BudimanZahri/mini_cnc_miling_engraver/Poster/Poster.PNG

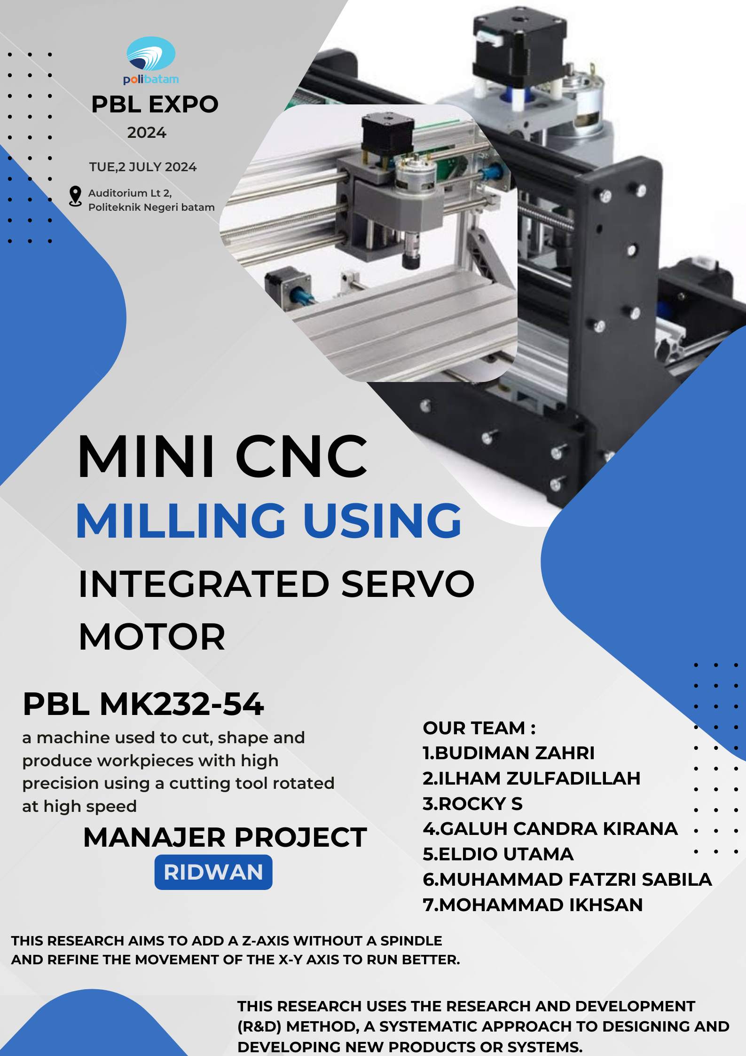
Poster/Poster.PNG
