BudimanZahri/mini_cnc_miling_engraver/Image Documentation/WhatsApp Image 2024-03-01 at 21.08.24.jpeg

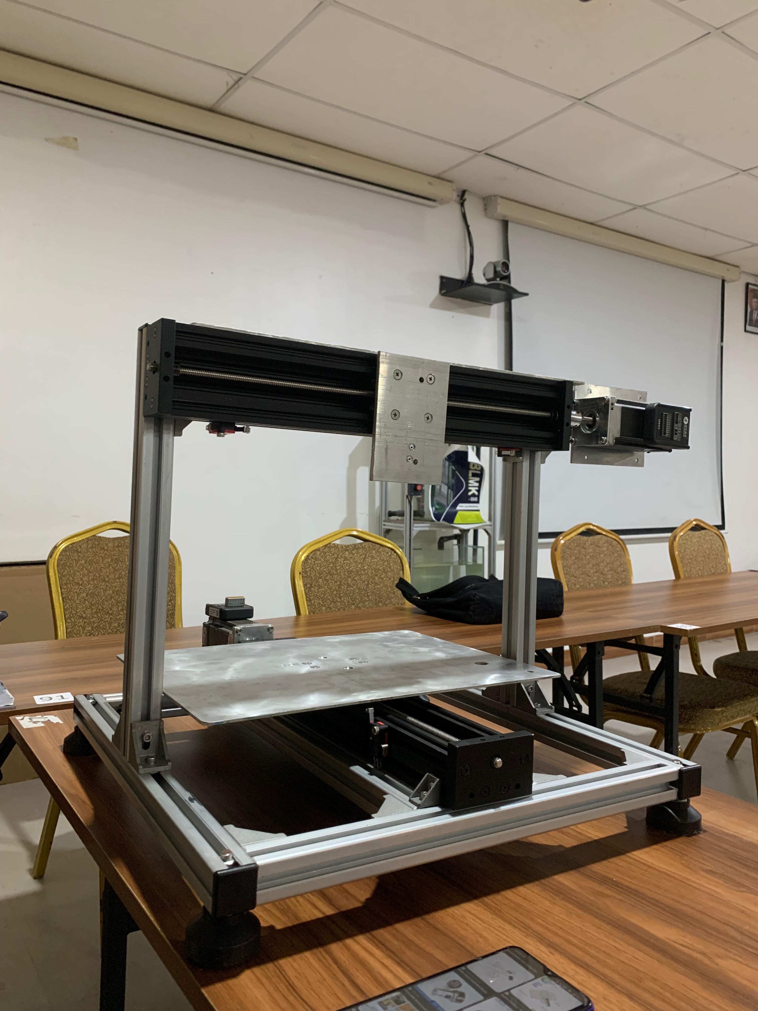
Image Documentation/WhatsApp Image 2024-03-01 at 21.08.24.jpeg
