BudimanZahri/mini_cnc_miling_engraver/Image Documentation/WhatsApp Image 2024-03-02 at 20.33.16.jpeg

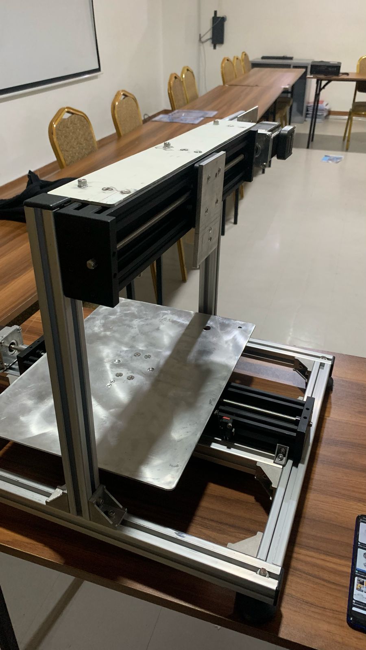
Image Documentation/WhatsApp Image 2024-03-02 at 20.33.16.jpeg
