BudimanZahri/mini_cnc_miling_engraver/Image Documentation/WhatsApp Image 2024-07-15 at 20.14.46 (1).jpeg

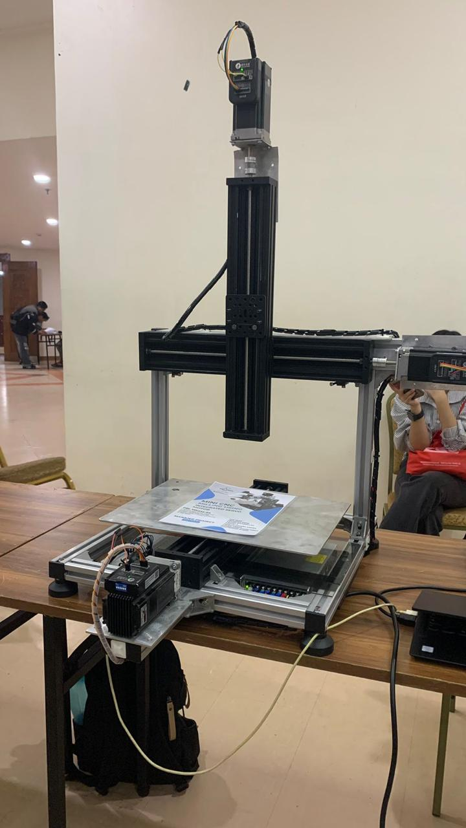
Image Documentation/WhatsApp Image 2024-07-15 at 20.14.46 (1).jpeg
