BudimanZahri/mini_cnc_miling_engraver/Mechanical/3D Design/images.png

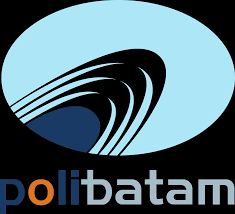
Mechanical/3D Design/images.png
