BudimanZahri/mini_cnc_miling_engraver/Program Interface/MINI_CNC_MILING/src/img/Arrow Down Axis X.png

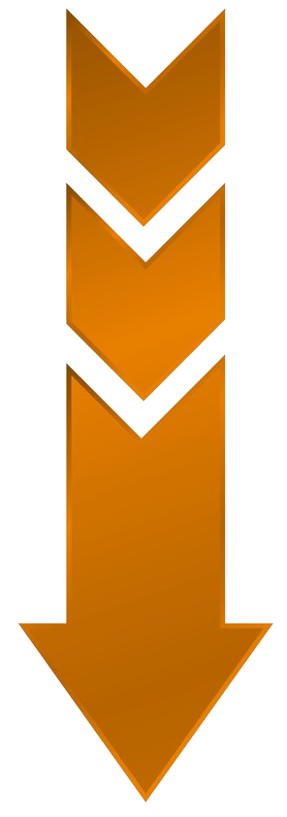
Program Interface/MINI_CNC_MILING/src/img/Arrow Down Axis X.png
