BudimanZahri/mini_cnc_miling_engraver/Program Interface/MINI_CNC_MILING/src/img/Arrow Left Axis Y.png

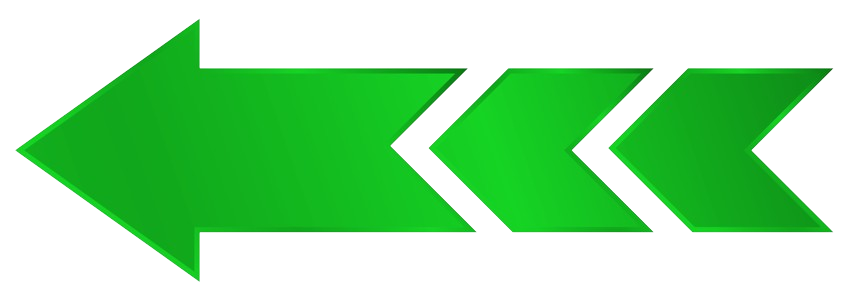
Program Interface/MINI_CNC_MILING/src/img/Arrow Left Axis Y.png
