BudimanZahri/mini_cnc_miling_engraver/Program Interface/MINI_CNC_MILING/src/img/Arrow Up Axis X.png

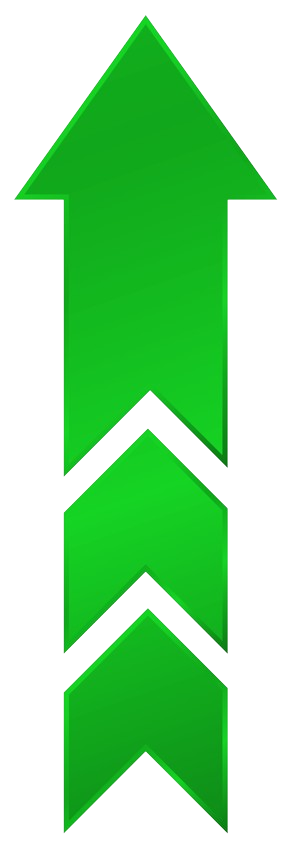
Program Interface/MINI_CNC_MILING/src/img/Arrow Up Axis X.png
