BudimanZahri/mini_cnc_miling_engraver/Program Interface/MINI_CNC_MILING/src/img/arrow_down.png

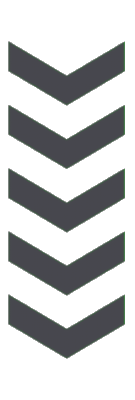
Program Interface/MINI_CNC_MILING/src/img/arrow_down.png
