BudimanZahri/mini_cnc_miling_engraver/Program Interface/MINI_CNC_MILING/src/img/arrow_up.png

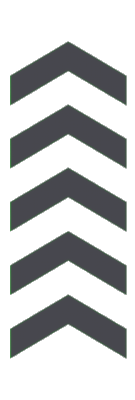
Program Interface/MINI_CNC_MILING/src/img/arrow_up.png
