BudimanZahri/mini_cnc_miling_engraver/Program Interface/MINI_CNC_MILING/src/img/cylinder_up.png

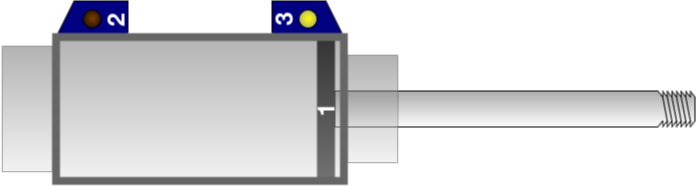
Program Interface/MINI_CNC_MILING/src/img/cylinder_up.png
