BudimanZahri/mini_cnc_miling_engraver/Program Interface/MINI_CNC_MILING/src/img/emergency_button.png

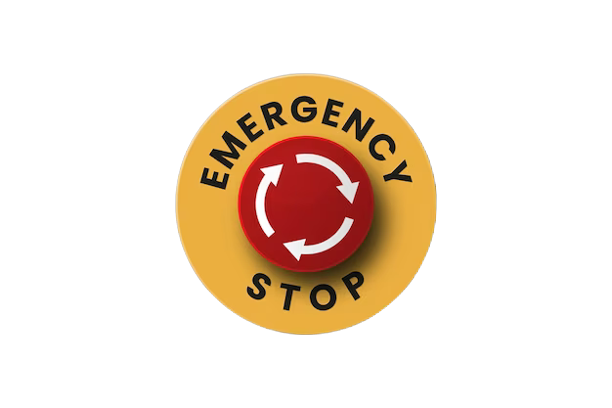
Program Interface/MINI_CNC_MILING/src/img/emergency_button.png
