BudimanZahri/mini_cnc_miling_engraver/Program Interface/MINI_CNC_MILING/src/img/green_light_signal.png

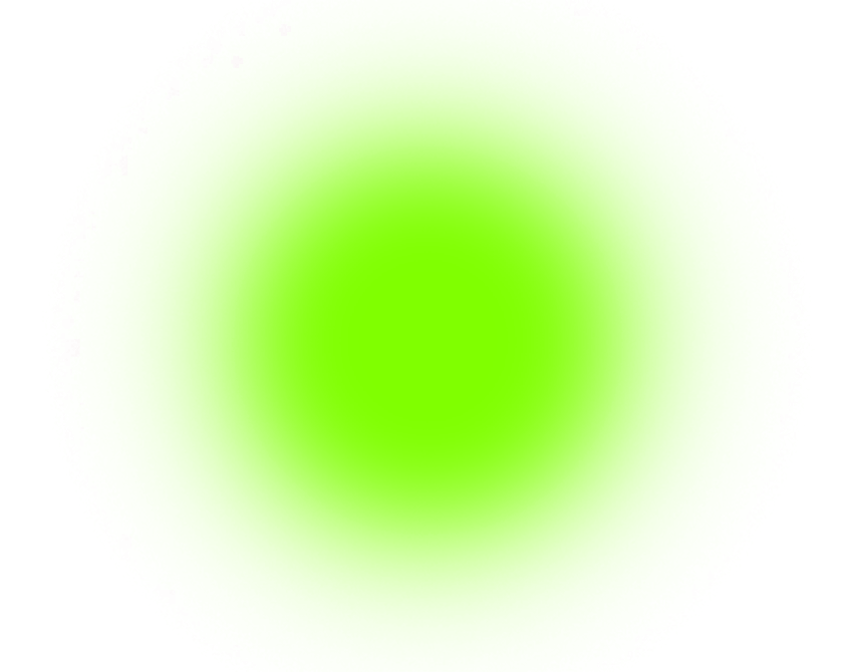
Program Interface/MINI_CNC_MILING/src/img/green_light_signal.png
