BudimanZahri/mini_cnc_miling_engraver/Program Interface/MINI_CNC_MILING/src/img/greenled_light_on.png

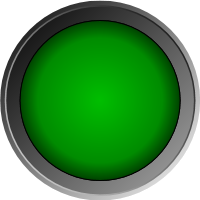
Program Interface/MINI_CNC_MILING/src/img/greenled_light_on.png
