BudimanZahri/mini_cnc_miling_engraver/Program Interface/MINI_CNC_MILING/src/img/pb_stop.png

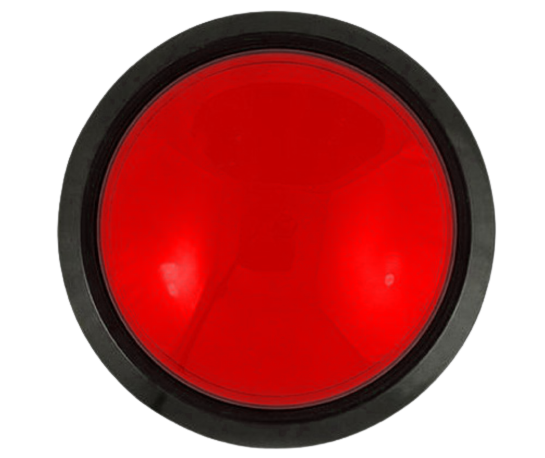
Program Interface/MINI_CNC_MILING/src/img/pb_stop.png
