BudimanZahri/mini_cnc_miling_engraver/Program Interface/MINI_CNC_MILING/src/img/pipe_conveyor.png

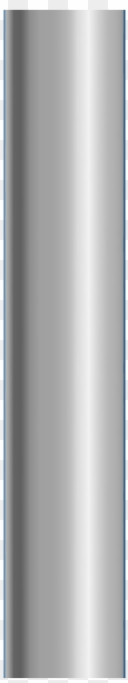
Program Interface/MINI_CNC_MILING/src/img/pipe_conveyor.png
