BudimanZahri/mini_cnc_miling_engraver/Gantt Chart/PBLMK232-54_Gant Chart.xlsx

Sheet: Gantt Chart
PBL Code | PBLMK232-54
PROJECT TITLE | Mini CNC Milling Using Integrated Servo Motor
No | Description Task |  | PIC | Status | Achievement in percentage | Team | Plan/Actual | February | March |  |  |  |  |  |  |  |  |  |  |  |  |  |  |  |  |  |  | April |  |  |  |  |  |  | May
 |  |  |  |  |  |  |  | Date | Dates |  |  |  |  |  |  |  |  |  |  |  |  |  |  |  |  |  |  | Dates |  |  |  |  |  |  | Dates
 |  |  |  |  |  |  |  | 29 | 1 | 4 | 5 | 6 | 7 | 8 | 11 | 13 | 14 | 15 | 18 | 19 | 20 | 21 | 22 | 25 | 26 | 27 | 28 | 22 | 23 | 24 | 25 | 26 | 29 | 30 | 1 | 2 | 3 | 6 | 7 | 8 | 9 | 10 | 13 | 14 | 15 | 16 | 17 | 20 | 21 | 22 | 23 | 24 | 27 | 28 | 29 | 30 | 31
1. | Planning and Team Discussion |  | Budiman Zahri
 | 1.1 | First discussion online with Project Manager |  | Done | 100% | All | PLAN
 |  |  |  |  |  |  | ACTUAL
 | 1.2 | Member registration on PBL ready website |  | Done | 100% | All | PLAN
 |  |  |  |  |  |  | ACTUAL
 | 1.3 | Create timeline |  | Done | 100% | Galuh | PLAN
 |  |  |  |  |  |  | ACTUAL
 | 1.4 | Offline discussion with project manager |  | Done | 100% | All | PLAN
 |  |  |  |  |  |  | ACTUAL
 | 1.5 | Identify team members and assign roles. |  | Done | 100% | Budi | PLAN
 |  |  |  |  |  |  | ACTUAL
 | 1.6 | Discussion about the list of BHP that will be submitted |  | Done | 100% | All | PLAN
 |  |  |  |  |  |  | ACTUAL
 | 1.7 | Ensure the targets that will result from this PBL |  | Done | 100% | Budi | PLAN
 |  |  |  |  |  |  | ACTUAL
 | 1.8 | Search information about CNC Milling that is worked on in the project. |  | Done | 100% | Galuh | PLAN
 |  |  |  |  |  |  | ACTUAL
2. | Planner and HR |  | Galuh Candra Kirana
 | 2.1 | Create the RPP (Rencana Pelaksanaan Proyek) |  | Done | 100% | Galuh | PLAN
 |  |  |  |  |  |  | ACTUAL
 | 2.2 | Create a BHP list |  | Done | 100% | Galuh | PLAN
 |  |  |  |  |  |  | ACTUAL
 | 2.3 | Ensure smooth submission of BHP from ordering until the goods are ready for use |  | Done | 100% | Galuh | PLAN
 |  |  |  |  |  |  | ACTUAL
 | 2.4 | Create attendance to ensure team members are working according to their tasks. |  | Done | 100% | Galuh | PLAN
 |  |  |  |  |  |  | ACTUAL
3. | Mechanical Design |  | Eldio Utama
 | 3.1 | Download software Soliwork |  | Done | 100 | Eldio | PLAN
 |  |  |  |  |  |  | ACTUAL
 | 3.2 | Measuring the parts of the tool to be designed |  | Done | 100 | Eldio | PLAN
 |  |  |  |  |  |  | ACTUAL
 | 3.3 | Create a design |  | Done | 100 | Eldio | PLAN
 |  |  |  |  |  |  | ACTUAL
4. | Machanical |  | Mohammad Ihsan
 | 4.1 | Checking Raw Material and Request Material Approval |  | Done | 100% | Ihsan | PLAN
 |  |  |  |  |  |  | ACTUAL
 | 4.2 | Assembly Z Axis |  | Done | 100% | Ihsan | PLAN
 |  |  |  |  |  |  | ACTUAL
 | 4.3 | Assembly Spindell |  | Done | 100% | Ihsan | PLAN
 |  |  |  |  |  |  | ACTUAL
 | 4.4 | Assembly Servo Motor |  | Done | 100% | Ihsan | PLAN
 |  |  |  |  |  |  | ACTUAL
 | 4.5 | Assembly of other supporting materials |  | Done | 100% | Ihsan | PLAN
 |  |  |  |  |  |  | ACTUAL
5. | Electrical Diagram |  | Ilham Zulfadillah
 | 5.1 | Make electrical diagrams in accordance with electrical wiring |  | Done | 100 | Ilham | PLAN
 |  |  |  |  |  |  | ACTUAL
 | 5.2 | Perform wiring check |  | Done | 100 | Ilham | PLAN
 |  |  |  |  |  |  | ACTUAL
6. | Electrical Wiring |  | Muhammad Fatzri Sabila
 | 6.1 | Checking Raw Material and Request Material Approval |  | Done | 100% | Fatzri | PLAN
 |  |  |  |  |  |  | ACTUAL
 | 6.2 | Install power supply |  | Done | 100% | Fatzri | PLAN
 |  |  |  |  |  |  | ACTUAL
 | 6.3 | Install electrical for X, Y, and Z axis |  | Done | 100% | Fatzri | PLAN
 |  |  |  |  |  |  | ACTUAL
 | 6.4 | Adjust part for moving X, Y, and Z axis |  | Done | 100% | Fatzri | PLAN
 |  |  |  |  |  |  | ACTUAL
 | 6.5 | Trubleshooting electrical |  | Done | 100% | Fatzri | PLAN
 |  |  |  |  |  |  | ACTUAL
 | 6.6 | Testing |  | Done | 100% | Fatzri | PLAN
 |  |  |  |  |  |  | ACTUAL
7. | Program Interface |  | Budiman Zahri
 | 7.1 | study documentation of Servo motor, C#, C++, Accelstepper |  | Done | 100 | Budi | PLAN
 |  |  |  |  |  |  | ACTUAL
 | 7.2 | Create the program interfaces CNC Milling |  | Done | 100 | Budi | PLAN
 |  |  |  |  |  |  | ACTUAL
 | 7.3 | Testing |  | Done | 100 | Budi | PLAN
 |  |  |  |  |  |  | ACTUAL
8. | QA/QC |  | Rocky S
 | 8.1 | Verifying product conformance to specifications |  | Done | 100 | Rocky | PLAN
 |  |  |  |  |  |  | ACTUAL
 | 8.2 | Identify and report quality issues |  | Done | 100 | Rocky | PLAN
 |  |  |  |  |  |  | ACTUAL
 | 8.3 | Provide recommendations for process improvement |  | Done | 100 | Rocky | PLAN
 |  |  |  |  |  |  | ACTUAL
9 | Report PBL |  | Galuh Candra Kirana
 | 9.1 | Create a PBL report |  | Done | 100% | Galuh | PLAN
 |  |  |  |  |  |  | ACTUAL

Sheet: Konfigurasi
STATUS | Information | Nama PIC | Information
To Do |  | Galuh
In Progress |  | Ikhsan
Waiting Approval |  | Budi
Done |  | Rocky
Cancelled |  | Ilham
 |  | Fatzri
 |  | Eldio
 |  | All
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
