BudimanZahri/mini_cnc_miling_engraver/Mechanical/3D Design/PBLMK-041-A/Frame/Frame0001.SLDASM

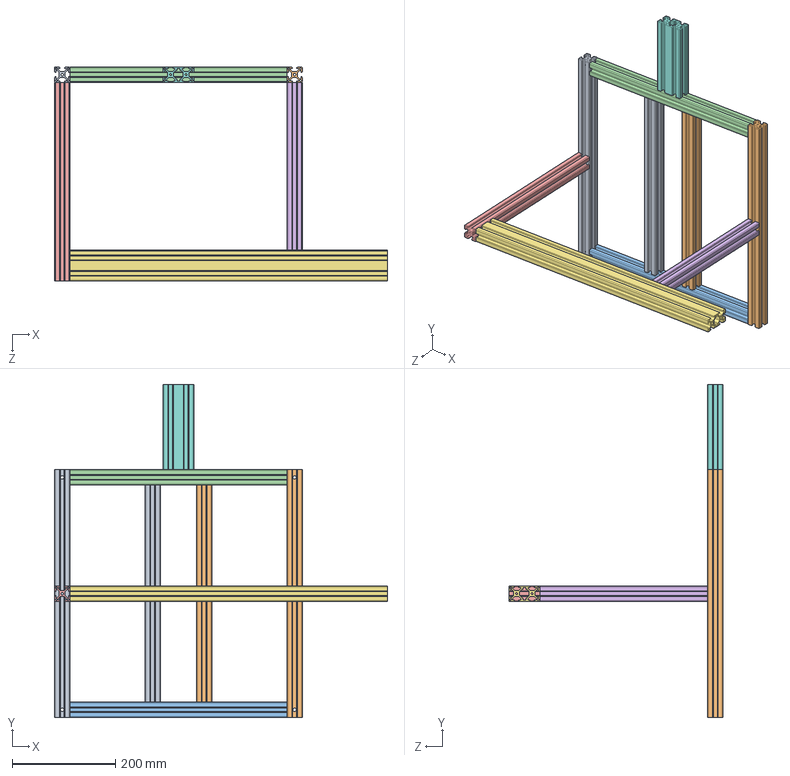
[picture p33: CAD file, 2024-07-05]
Mechanical/3D Design/PBLMK-041-A/Frame/Frame0001.SLDASM
645.0 x 645.0 x 415.0 mm
ALU PROFILE 3030 00000001.ipt
ALU PROFILE 3030 00000002.ipt
ALU PROFILE 3030 00000003.ipt
ALU PROFILE 3030 00000004.ipt
ALU PROFILE 3030 00000006.ipt
ALU PROFILE 3030 00000007.ipt
ALU PROFILE 3060 00000008.ipt
ALU PROFILE 3060 00000009.ipt
Aluminum Profile 30x30 00000010.ipt
Aluminum Profile 30x30 00000011.ipt
