BudimanZahri/mini_cnc_miling_engraver/Mechanical/3D Design/LINEAR ACTUATOR.SLDASM

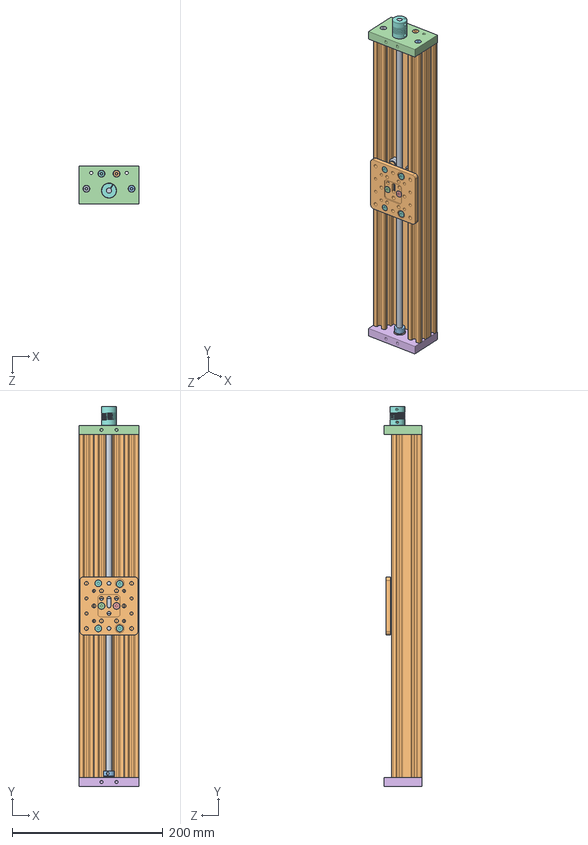
[picture p34: CAD file, 2024-07-05]
Mechanical/3D Design/LINEAR ACTUATOR.SLDASM
80.0 x 505.0 x 50.0 mm
Solid33.ipt
Solid45.ipt
Solid39.ipt
Solid41.ipt
Solid43.ipt
Solid44.ipt
Solid57.ipt
Solid58.ipt x 3
Solid31.ipt
Solid32.ipt
Solid1.ipt x 2
Solid53.ipt
Solid54.ipt
Solid55.ipt
Solid56.ipt
Solid49.ipt x 4
Solid16.ipt x 4
Solid15.ipt x 4
Solid14.ipt x 4
Solid13.ipt x 4
Solid12.ipt x 4
Solid11.ipt x 4
Solid10.ipt x 4
Solid64.ipt
Solid63.ipt
Solid62.ipt
Solid61.ipt
Solid46.ipt
Solid42.ipt
Solid40.ipt
Solid38.ipt
Solid34.ipt
