BudimanZahri/mini_cnc_miling_engraver/Mechanical/3D Design/PBLMK-041-5.SLDPRT

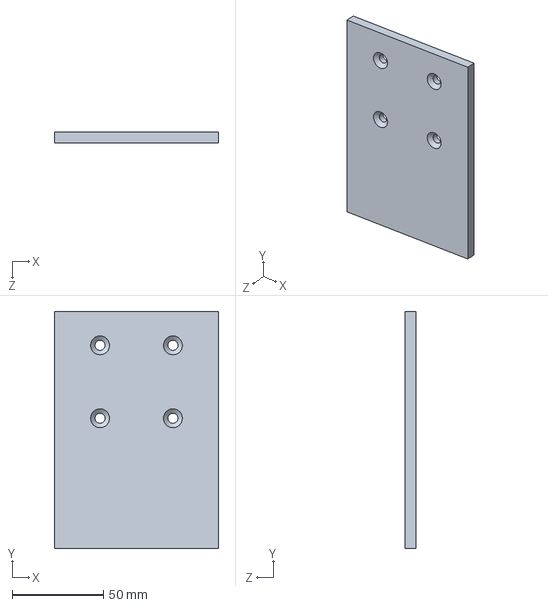
[picture p35: CAD file, 2024-07-05]
Mechanical/3D Design/PBLMK-041-5.SLDPRT
90.0 x 130.0 x 6.00 mm
