BudimanZahri/mini_cnc_miling_engraver/Mechanical/3D Design/PBLMK-041-A/Frame/ALU PROFILE 3060  00000008.SLDPRT

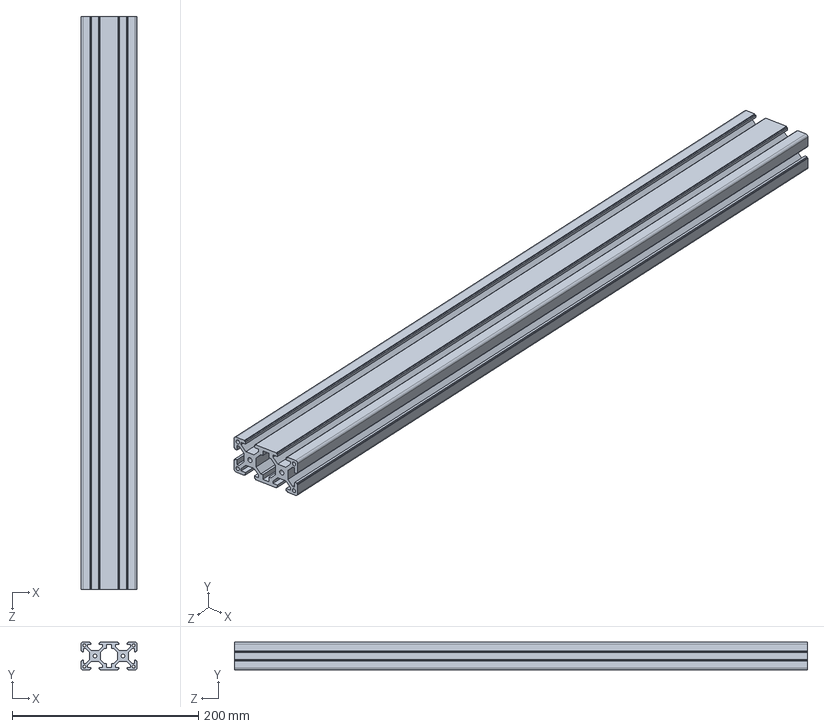
[picture p36: CAD file, 2024-07-05]
Mechanical/3D Design/PBLMK-041-A/Frame/ALU PROFILE 3060 00000008.SLDPRT
60.0 x 30.0 x 615.0 mm
