BudimanZahri/mini_cnc_miling_engraver/Mechanical/3D Design/BASE LINEAR ACTUATOR.SLDPRT

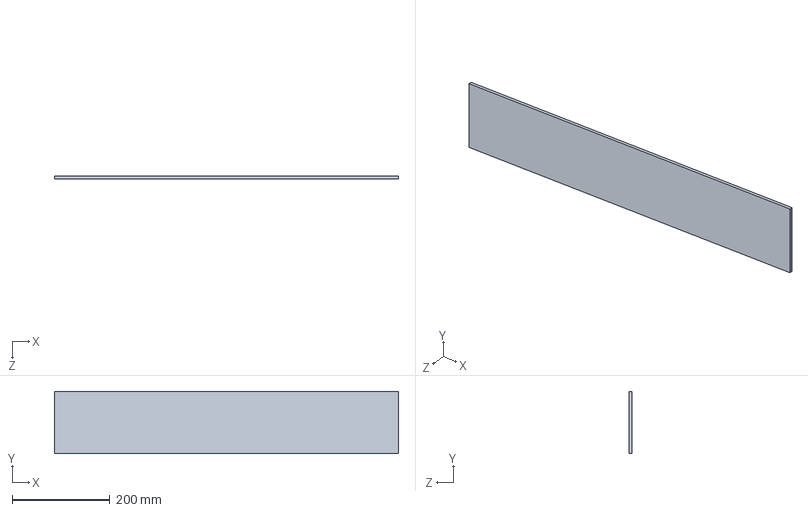
[picture p37: CAD file, 2024-07-05]
Mechanical/3D Design/BASE LINEAR ACTUATOR.SLDPRT
703.0 x 127.0 x 6.00 mm
