BudimanZahri/mini_cnc_miling_engraver/Mechanical/3D Design/END CAP 3060.SLDPRT

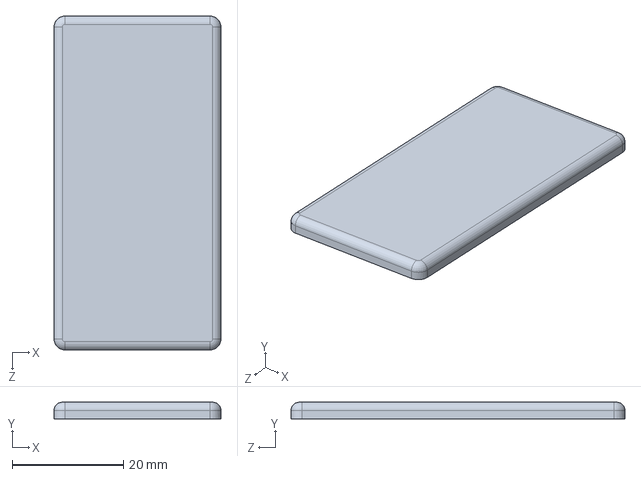
[picture p38: CAD file, 2024-07-05]
Mechanical/3D Design/END CAP 3060.SLDPRT
30.0 x 3.00 x 60.0 mm
