BudimanZahri/mini_cnc_miling_engraver/Mechanical/3D Design/Adjuster Pad.SLDPRT

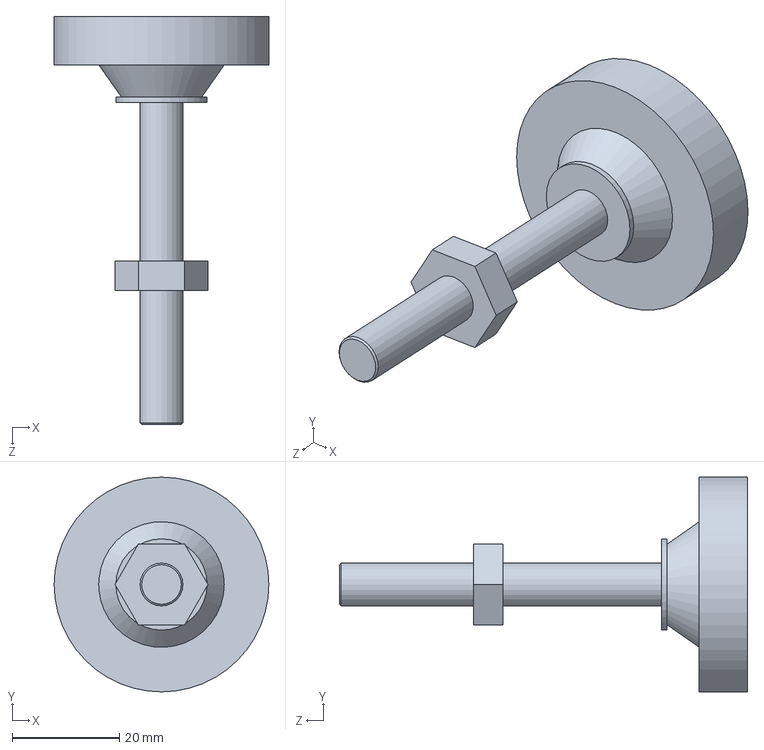
[picture p39: CAD file, 2024-07-05]
Mechanical/3D Design/Adjuster Pad.SLDPRT
40.0 x 40.0 x 76.0 mm
