BudimanZahri/mini_cnc_miling_engraver/Mechanical/3D Design/PBLMK-041-A/Frame/ALU PROFILE 3030  00000005.SLDPRT

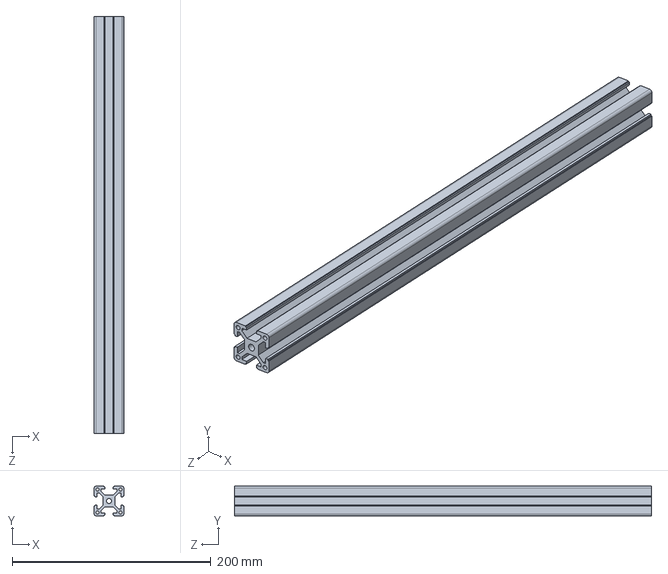
[picture p40: CAD file, 2024-07-05]
Mechanical/3D Design/PBLMK-041-A/Frame/ALU PROFILE 3030 00000005.SLDPRT
30.0 x 30.0 x 420.0 mm
