BudimanZahri/mini_cnc_miling_engraver/Mechanical/3D Design/END CAP 30.SLDPRT

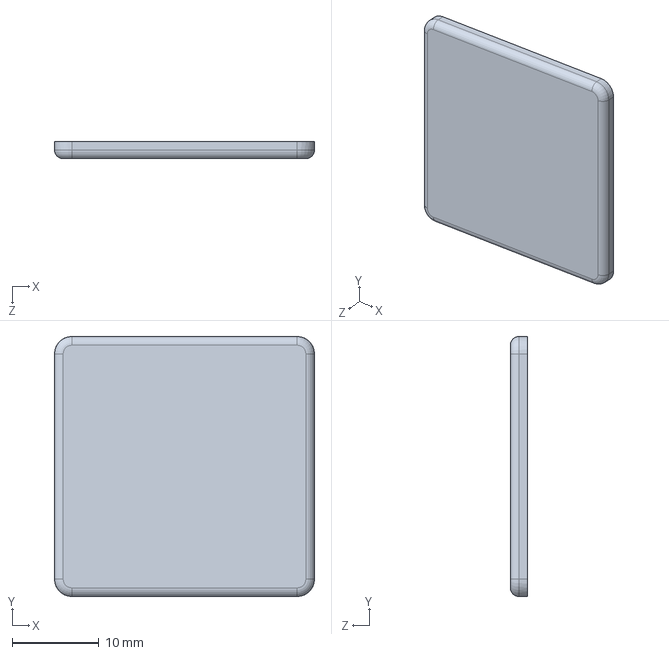
[picture p41: CAD file, 2024-07-05]
Mechanical/3D Design/END CAP 30.SLDPRT
30.0 x 30.0 x 2.00 mm
