BudimanZahri/mini_cnc_miling_engraver/Mechanical/3D Design/PBLMK-041-A/Frame/ALU PROFILE 3030  00000001.SLDPRT

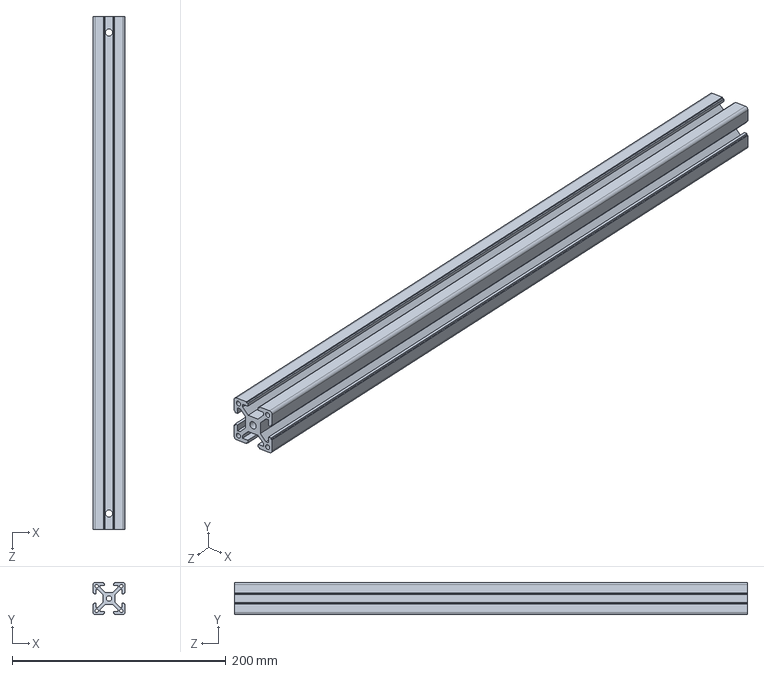
[picture p42: CAD file, 2024-07-05]
Mechanical/3D Design/PBLMK-041-A/Frame/ALU PROFILE 3030 00000001.SLDPRT
30.0 x 30.0 x 480.0 mm
