BudimanZahri/mini_cnc_miling_engraver/Mechanical/3D Design/Gusset 30.SLDPRT

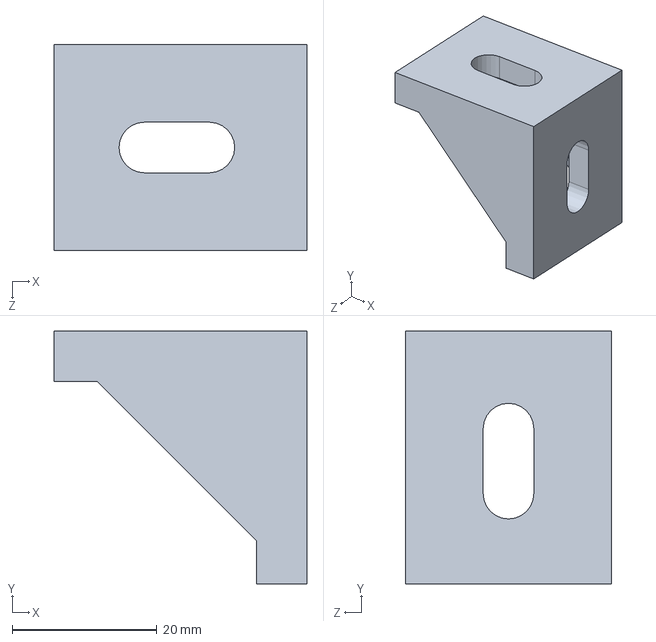
[picture p43: CAD file, 2024-07-05]
Mechanical/3D Design/Gusset 30.SLDPRT
35.0 x 35.0 x 28.5 mm
