BudimanZahri/mini_cnc_miling_engraver/Mechanical/3D Design/PBLMK-041-A/Frame/C-Beam Linear Actuator 500mm.stp.SLDPRT

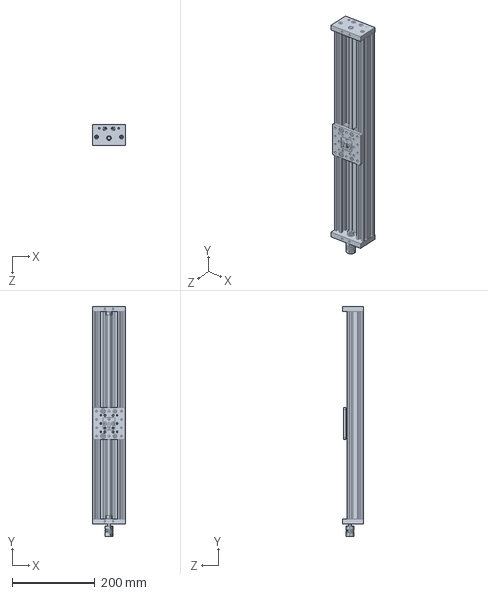
[picture p44: CAD file, 2024-07-05]
Mechanical/3D Design/PBLMK-041-A/Frame/C-Beam Linear Actuator 500mm.stp.SLDPRT
80.0 x 554.4 x 50.0 mm
