BudimanZahri/mini_cnc_miling_engraver/Mechanical/3D Design/PBLMK-041-1.SLDPRT

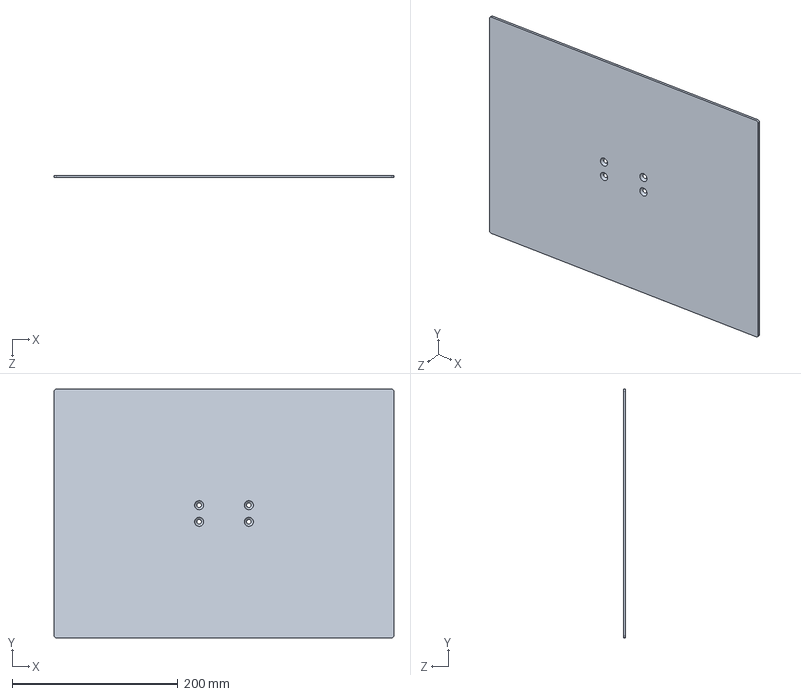
[picture p45: CAD file, 2024-07-05]
Mechanical/3D Design/PBLMK-041-1.SLDPRT
410.0 x 300.0 x 3.00 mm
