BudimanZahri/mini_cnc_miling_engraver/Mechanical/3D Design/PBLMK-041-A/Frame/ALU PROFILE 3030  00000007.SLDPRT

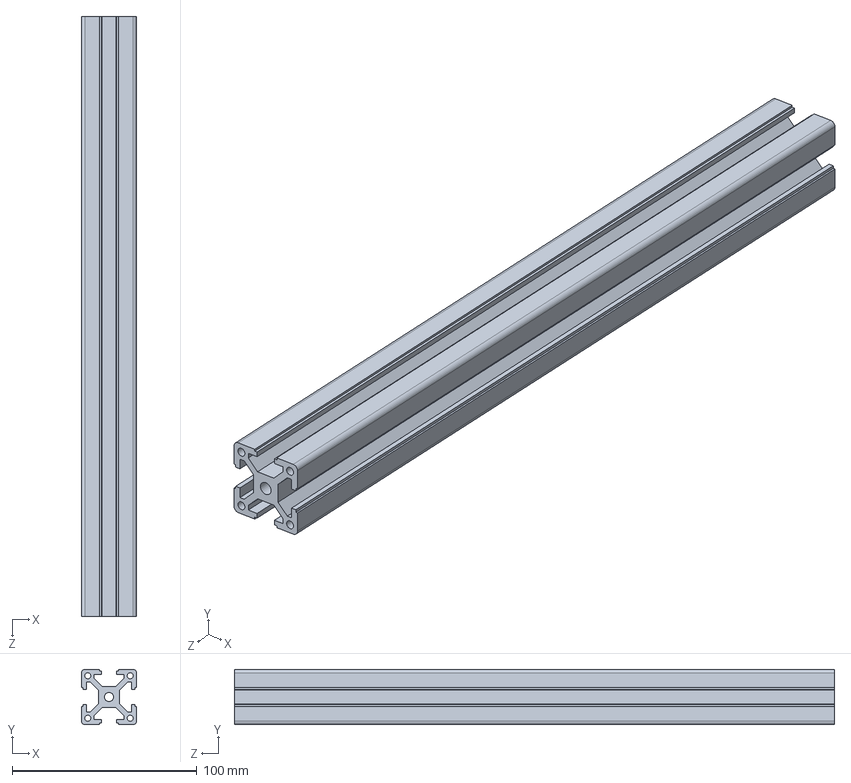
[picture p46: CAD file, 2024-07-05]
Mechanical/3D Design/PBLMK-041-A/Frame/ALU PROFILE 3030 00000007.SLDPRT
30.0 x 30.0 x 325.0 mm
