BudimanZahri/mini_cnc_miling_engraver/Mechanical/3D Design/BRACKET MOTOR.SLDPRT

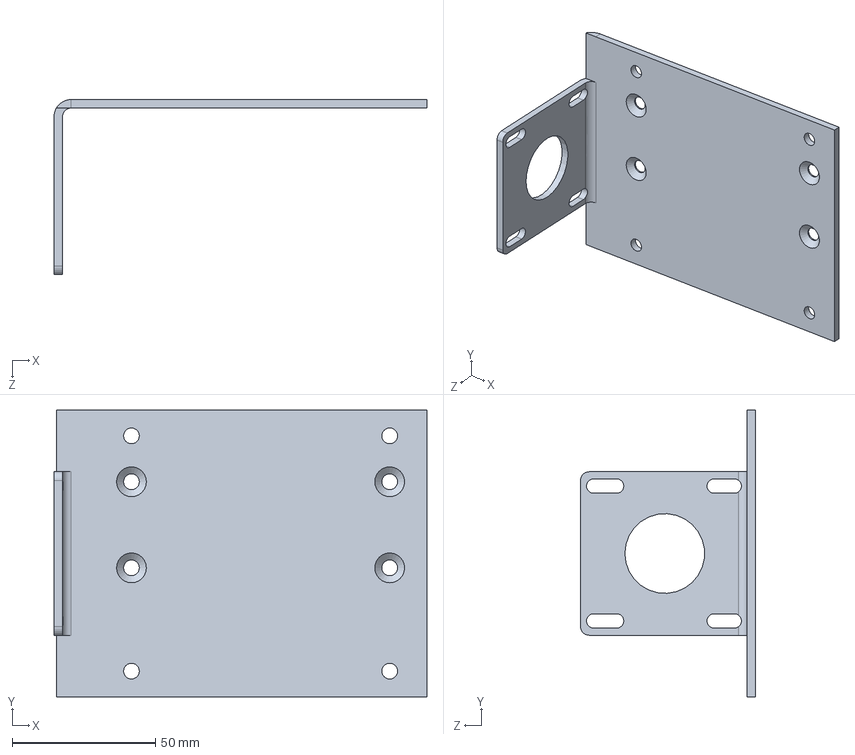
[picture p47: CAD file, 2024-07-05]
Mechanical/3D Design/BRACKET MOTOR.SLDPRT
130.0 x 100.0 x 61.0 mm
