BudimanZahri/mini_cnc_miling_engraver/Mechanical/3D Design/PBLMK-041-A/Frame/ALU PROFILE 3060  00000009.SLDPRT

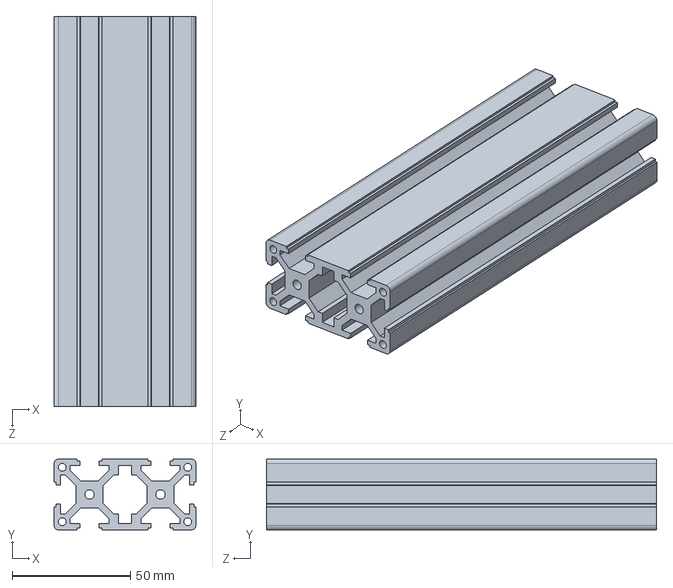
[picture p48: CAD file, 2024-07-05]
Mechanical/3D Design/PBLMK-041-A/Frame/ALU PROFILE 3060 00000009.SLDPRT
60.0 x 30.0 x 165.0 mm
