BudimanZahri/mini_cnc_miling_engraver/Mechanical/3D Design/Jig for Motor.SLDPRT

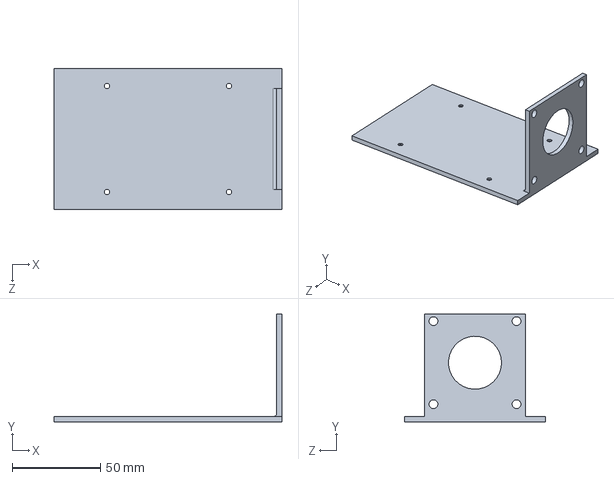
[picture p49: CAD file, 2024-07-05]
Mechanical/3D Design/Jig for Motor.SLDPRT
129.0 x 61.0 x 80.0 mm
