BudimanZahri/mini_cnc_miling_engraver/Mechanical/3D Design/PBLMK-041-A/Frame/ALU PROFILE 3030  00000006.SLDPRT

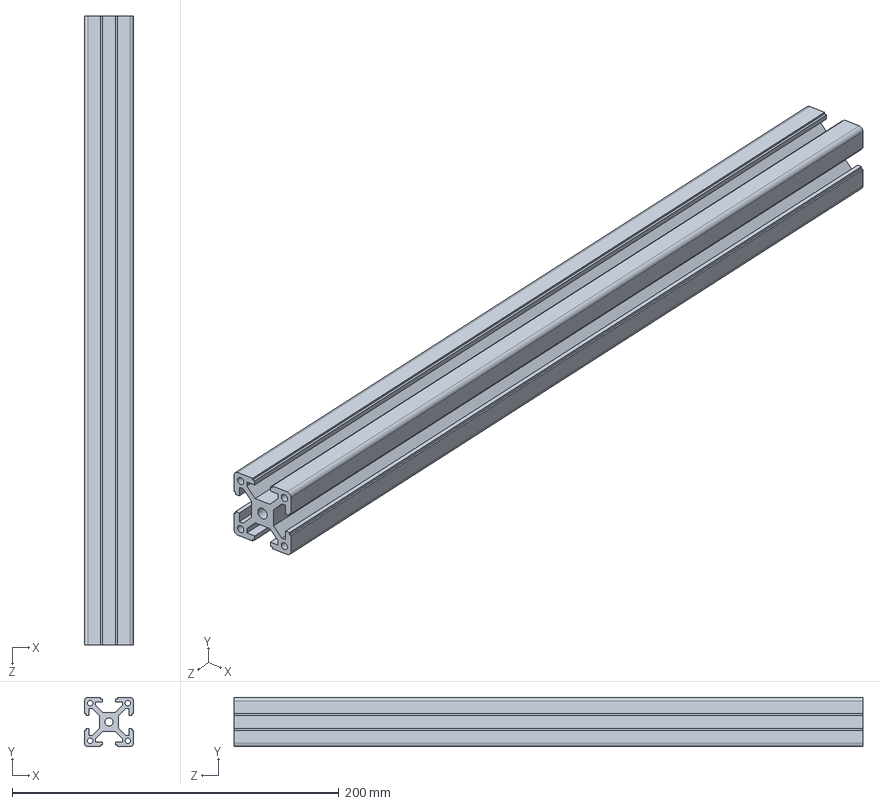
[picture p50: CAD file, 2024-07-05]
Mechanical/3D Design/PBLMK-041-A/Frame/ALU PROFILE 3030 00000006.SLDPRT
30.0 x 30.0 x 385.0 mm
