BudimanZahri/mini_cnc_miling_engraver/Mechanical/3D Design/SHAFT SUPPORT BRACKET dia 12.SLDPRT

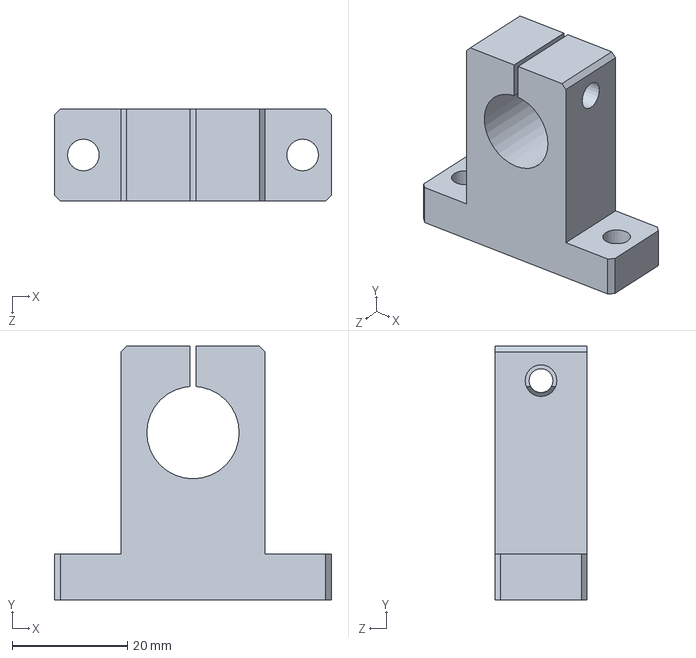
[picture p51: CAD file, 2024-07-05]
Mechanical/3D Design/SHAFT SUPPORT BRACKET dia 12.SLDPRT
48.0 x 44.0 x 16.0 mm
