BudimanZahri/mini_cnc_miling_engraver/Mechanical/3D Design/GUSSET 2020.SLDPRT

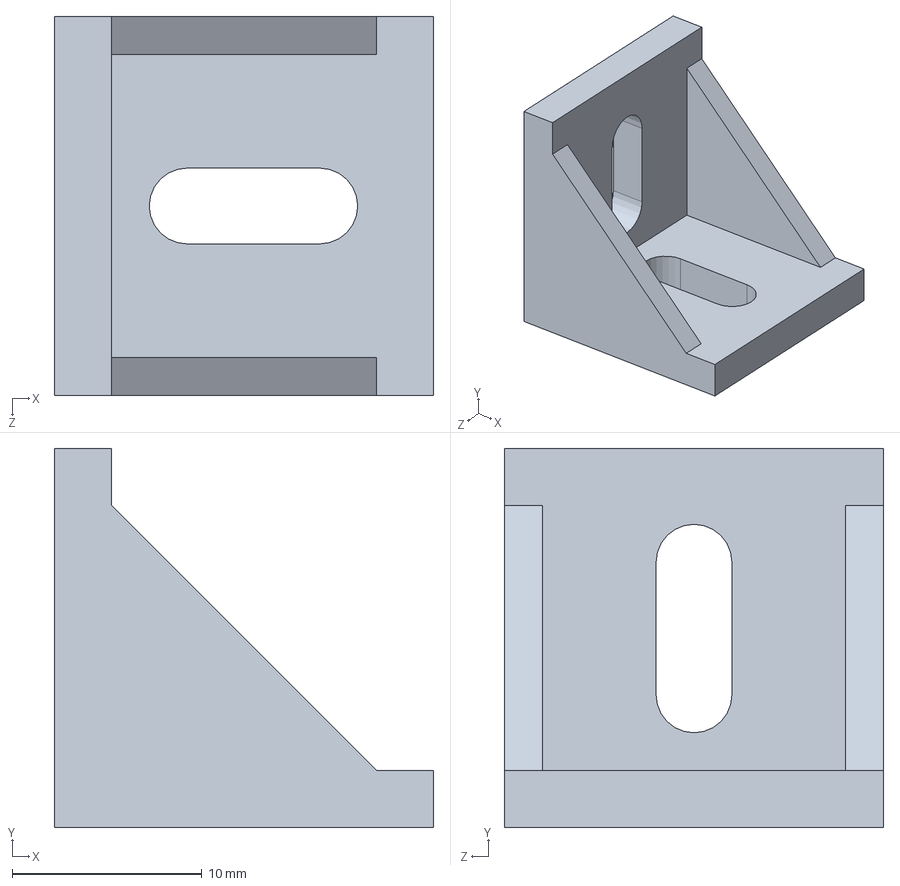
[picture p52: CAD file, 2024-07-05]
Mechanical/3D Design/GUSSET 2020.SLDPRT
20.0 x 20.0 x 20.0 mm
