BudimanZahri/mini_cnc_miling_engraver/Mechanical/3D Design/PBLMK-041-2.SLDPRT

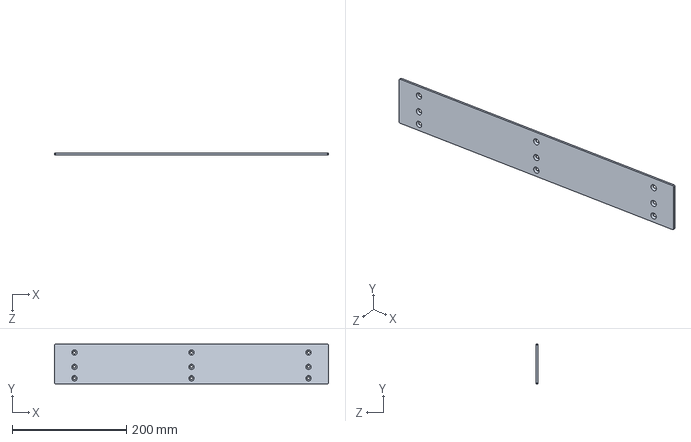
[picture p53: CAD file, 2024-07-05]
Mechanical/3D Design/PBLMK-041-2.SLDPRT
480.0 x 70.0 x 3.00 mm
