BudimanZahri/mini_cnc_miling_engraver/(list of files, cad)

Other CAD files:
Mechanical/3D Design/PBLMK-041-A/Frame/Skeleton0001.SLDPRT
Mechanical/3D Design/PBLMK-041-A/Frame/ALU PROFILE 3030 00000004.SLDPRT
Mechanical/3D Design/BRACKET MOTOR 2.SLDPRT
Mechanical/3D Design/PBLMK-041-A/Frame/Aluminum Profile 30x30 00000010.SLDPRT
Mechanical/3D Design/PBLMK-041-A/Frame/Aluminum Profile 30x30 00000011.SLDPRT
Mechanical/3D Design/PBLMK-041-A/Frame/ALU PROFILE 3030 00000003.SLDPRT
Mechanical/3D Design/PBLMK-041-A/Frame/ALU PROFILE 3030 00000002.SLDPRT
Mechanical/3D Design/Adjuster Pad.ipt
Mechanical/3D Design/BASE LINEAR ACTUATOR.ipt
Mechanical/3D Design/BRACKET MOTOR 2.ipt
Mechanical/3D Design/BRACKET MOTOR.ipt
Mechanical/3D Design/END CAP 30.ipt
Mechanical/3D Design/END CAP 3060.ipt
Mechanical/3D Design/GUSSET 2020.ipt
Mechanical/3D Design/Gusset 30.ipt
Mechanical/3D Design/Jig for Motor.SLDDRW
Mechanical/3D Design/LINEAR ACTUATOR.iam
Mechanical/3D Design/OldVersions/Adjuster Pad.0001.ipt
Mechanical/3D Design/OldVersions/BASE LINEAR ACTUATOR.0001.ipt
Mechanical/3D Design/OldVersions/BRACKET MOTOR 2.0013.ipt
Mechanical/3D Design/OldVersions/BRACKET MOTOR.0018.ipt
Mechanical/3D Design/OldVersions/END CAP 30.0001.ipt
Mechanical/3D Design/OldVersions/END CAP 3060.0001.ipt
Mechanical/3D Design/OldVersions/GUSSET 2020.0003.ipt
Mechanical/3D Design/OldVersions/Gusset 30.0002.ipt
Mechanical/3D Design/OldVersions/LINEAR ACTUATOR.0016.iam
Mechanical/3D Design/OldVersions/PBLMK-041-1.0015.idw
Mechanical/3D Design/OldVersions/PBLMK-041-1.0025.ipt
Mechanical/3D Design/OldVersions/PBLMK-041-2.0011.idw
Mechanical/3D Design/OldVersions/PBLMK-041-2.0017.ipt
Mechanical/3D Design/OldVersions/PBLMK-041-2.0022.ipt
Mechanical/3D Design/OldVersions/PBLMK-041-3.0012.ipt
Mechanical/3D Design/OldVersions/PBLMK-041-3.0019.idw
Mechanical/3D Design/OldVersions/PBLMK-041-4.0025.idw
Mechanical/3D Design/OldVersions/PBLMK-041-5.0005.idw
Mechanical/3D Design/OldVersions/PBLMK-041-5.0006.ipt
Mechanical/3D Design/OldVersions/PBLMK-041-A.0141.iam
Mechanical/3D Design/OldVersions/PBLMK-041-A1.0027.idw
Mechanical/3D Design/OldVersions/PBLMK-041-ALU 165.0009.idw
Mechanical/3D Design/OldVersions/PBLMK-041-ALU 325.0010.idw
Mechanical/3D Design/OldVersions/PBLMK-041-ALU 385.0007.idw
Mechanical/3D Design/OldVersions/PBLMK-041-ALU 420 A.0002.idw
Mechanical/3D Design/OldVersions/PBLMK-041-ALU 420 B.0001.idw
Mechanical/3D Design/OldVersions/PBLMK-041-ALU 420.0011.idw
Mechanical/3D Design/OldVersions/PBLMK-041-ALU 480.0003.idw
Mechanical/3D Design/OldVersions/PBLMK-041-ALU 615.0009.idw
Mechanical/3D Design/OldVersions/SC16 SCS16UU Linear Rail Bearing v4.0001.ipt
Mechanical/3D Design/OldVersions/SC16 SCS16UU Linear Rail Bearing v4.0003.ipt
Mechanical/3D Design/OldVersions/SHAFT SUPPORT BRACKET dia 12.0002.ipt
Mechanical/3D Design/OldVersions/SHAFT SUPPORT BRACKET dia 12.0003.ipt
Mechanical/3D Design/OldVersions/SKETCH.0008.ipt
Mechanical/3D Design/PBLMK-041-1.idw
Mechanical/3D Design/PBLMK-041-1.ipt
Mechanical/3D Design/PBLMK-041-2.idw
Mechanical/3D Design/PBLMK-041-2.ipt
Mechanical/3D Design/PBLMK-041-3.idw
Mechanical/3D Design/PBLMK-041-4.idw
Mechanical/3D Design/PBLMK-041-5.idw
Mechanical/3D Design/PBLMK-041-5.ipt
Mechanical/3D Design/PBLMK-041-A.iam
Mechanical/3D Design/PBLMK-041-A/Frame/ALU PROFILE 3030 00000001.ipt
Mechanical/3D Design/PBLMK-041-A/Frame/ALU PROFILE 3030 00000002.ipt
Mechanical/3D Design/PBLMK-041-A/Frame/ALU PROFILE 3030 00000003.ipt
Mechanical/3D Design/PBLMK-041-A/Frame/ALU PROFILE 3030 00000004.ipt
Mechanical/3D Design/PBLMK-041-A/Frame/ALU PROFILE 3030 00000005.ipt
Mechanical/3D Design/PBLMK-041-A/Frame/ALU PROFILE 3030 00000006.ipt
Mechanical/3D Design/PBLMK-041-A/Frame/ALU PROFILE 3030 00000007.ipt
Mechanical/3D Design/PBLMK-041-A/Frame/ALU PROFILE 3060 00000008.ipt
Mechanical/3D Design/PBLMK-041-A/Frame/ALU PROFILE 3060 00000009.ipt
Mechanical/3D Design/PBLMK-041-A/Frame/Aluminum Profile 30x30 00000010.ipt
Mechanical/3D Design/PBLMK-041-A/Frame/Aluminum Profile 30x30 00000011.ipt
Mechanical/3D Design/PBLMK-041-A/Frame/Frame0001.iam
Mechanical/3D Design/PBLMK-041-A/Frame/OldVersions/ALU PROFILE 3030 00000001.0009.ipt
Mechanical/3D Design/PBLMK-041-A/Frame/OldVersions/ALU PROFILE 3030 00000002.0009.ipt
Mechanical/3D Design/PBLMK-041-A/Frame/OldVersions/ALU PROFILE 3030 00000003.0006.ipt
Mechanical/3D Design/PBLMK-041-A/Frame/OldVersions/ALU PROFILE 3030 00000004.0006.ipt
Mechanical/3D Design/PBLMK-041-A/Frame/OldVersions/ALU PROFILE 3030 00000005.0005.ipt
Mechanical/3D Design/PBLMK-041-A/Frame/OldVersions/ALU PROFILE 3030 00000006.0004.ipt
Mechanical/3D Design/PBLMK-041-A/Frame/OldVersions/ALU PROFILE 3030 00000007.0008.ipt
Mechanical/3D Design/PBLMK-041-A/Frame/OldVersions/ALU PROFILE 3060 00000008.0009.ipt
Mechanical/3D Design/PBLMK-041-A/Frame/OldVersions/ALU PROFILE 3060 00000009.0004.ipt
Mechanical/3D Design/PBLMK-041-A/Frame/OldVersions/Aluminum Profile 30x30 00000010.0005.ipt
Mechanical/3D Design/PBLMK-041-A/Frame/OldVersions/Aluminum Profile 30x30 00000011.0005.ipt
Mechanical/3D Design/PBLMK-041-A/Frame/OldVersions/Frame0001.0026.iam
Mechanical/3D Design/PBLMK-041-A/Frame/OldVersions/Skeleton0001.0002.ipt
Mechanical/3D Design/PBLMK-041-A/Frame/Skeleton0001.ipt
Mechanical/3D Design/PBLMK-041-A1.idw
Mechanical/3D Design/PBLMK-041-ALU 165.idw
Mechanical/3D Design/PBLMK-041-ALU 325.idw
Mechanical/3D Design/PBLMK-041-ALU 385.idw
Mechanical/3D Design/PBLMK-041-ALU 420.idw
Mechanical/3D Design/PBLMK-041-ALU 480.idw
Mechanical/3D Design/PBLMK-041-ALU 615.idw
Mechanical/3D Design/RHOMBUS NUT 4.SLDPRT
Mechanical/3D Design/RHOMBUS NUT 4.ipt
Mechanical/3D Design/SC16 SCS16UU Linear Rail Bearing v4.ipt
Mechanical/3D Design/SHAFT SUPPORT BRACKET dia 12.ipt
Mechanical/3D Design/SKETCH.ipt
Mechanical/Drawing 2D design mechanical/Gambar Kerja (2D)/16.lead Screw T8 D2 lead 8 SOLID.SLDDRW
Mechanical/Drawing 2D design mechanical/Gambar Kerja (2D)/17.Linear Shaft SOLID.SLDDRW
Mechanical/Drawing 2D design mechanical/Gambar Kerja (2D)/18.Lock Shaft.SLDDRW
Mechanical/Drawing 2D design mechanical/Gambar Kerja (2D)/19.Nut Lead Screw T8 SOLID.SLDDRW
Mechanical/Drawing 2D design mechanical/Gambar Kerja (2D)/20.Dudukan Nut Lead Screw SOLID.SLDDRW
Mechanical/Drawing 2D design mechanical/Gambar Kerja (2D)/21.Dudukan Nut Housing SOLID.SLDDRW
Mechanical/Drawing 2D design mechanical/Gambar Kerja (2D)/22.Frame Depan SOLID.SLDDRW
Mechanical/Drawing 2D design mechanical/Gambar Kerja (2D)/23.Frame Belakang SOLID.SLDDRW
Mechanical/Drawing 2D design mechanical/Gambar Kerja (2D)/24. Mur SOLID.SLDDRW
Mechanical/Drawing 2D design mechanical/Gambar Kerja (2D)/25.Meja Kerja SOLID.SLDDRW
Mechanical/Drawing 2D design mechanical/Gambar Kerja (2D)/26.Penyambung Meja Kerja.SLDDRW
Mechanical/Drawing 2D design mechanical/Gambar Kerja (2D)/27.V slot gantry rod plate 625ZZ.SLDDRW
Mechanical/Drawing 2D design mechanical/Gambar Kerja (2D)/28.Baut L 5,5mm SOLID.SLDDRW
Mechanical/Drawing 2D design mechanical/Gambar Kerja (2D)/29.Baut L 14,5 mm 2D.PDF.SLDDRW
Mechanical/Drawing 2D design mechanical/Gambar Kerja (2D)/29.Baut L 14,5 mm SOLID.SLDDRW
Mechanical/Drawing 2D design mechanical/Gambar Kerja (2D)/30.BAUT L 32,5 mm 2D.SLDDRW
Mechanical/Drawing 2D design mechanical/Gambar Kerja (2D)/30.BAUT L 32,5 mm SOLID.SLDDRW
Mechanical/Drawing 2D design mechanical/Gambar Kerja (2D)/30.BAUT L 32,5 mm.SLDDRW
Mechanical/Drawing 2D design mechanical/Gambar Kerja (2D)/31. Assembly Spindel Part SOLID.SLDDRW
Mechanical/Drawing 2D design mechanical/Gambar Kerja (2D)/33. Sub-Assembly Unit Y-Axis.SLDDRW
Mechanical/Drawing 2D design mechanical/Gambar Kerja (2D)/33.Assembly Struktur + Motor+X axis.SLDDRW
Mechanical/Drawing 2D design mechanical/Gambar Kerja (2D)/34.Sub-Assembly Unit Meja Kerja SOLID.SLDDRW
Mechanical/Drawing 2D design mechanical/Gambar Kerja (2D)/35.Rangka Dudukan Mesin SOLID.SLDDRW
Mechanical/Drawing 2D design mechanical/Gambar Kerja (2D)/Aluminium V slot 20100 80 mm SOLID.SLDDRW
Mechanical/Drawing 2D design mechanical/Gambar Kerja (2D)/Aluminium V slot 2040 500 mm SOLID.SLDDRW
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
