BudimanZahri/mini_cnc_miling_engraver/Electrical/Diagram Wiring.jpg

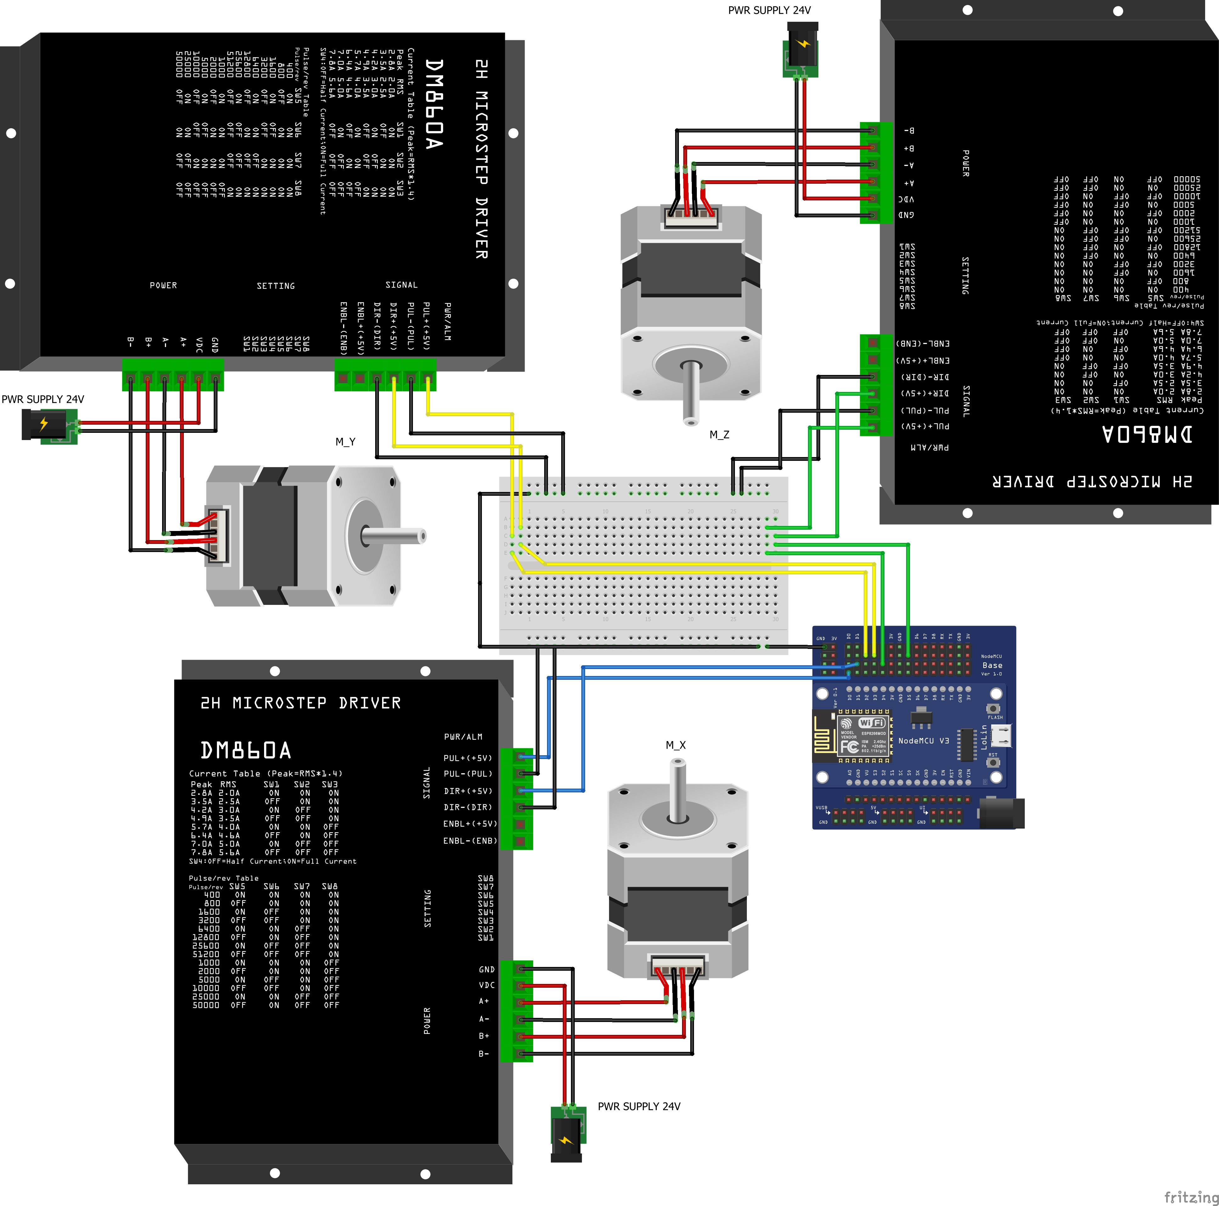
Electrical/Diagram Wiring.jpg
