BudimanZahri/mini_cnc_miling_engraver/Electrical/Schematic Wiring.jpg

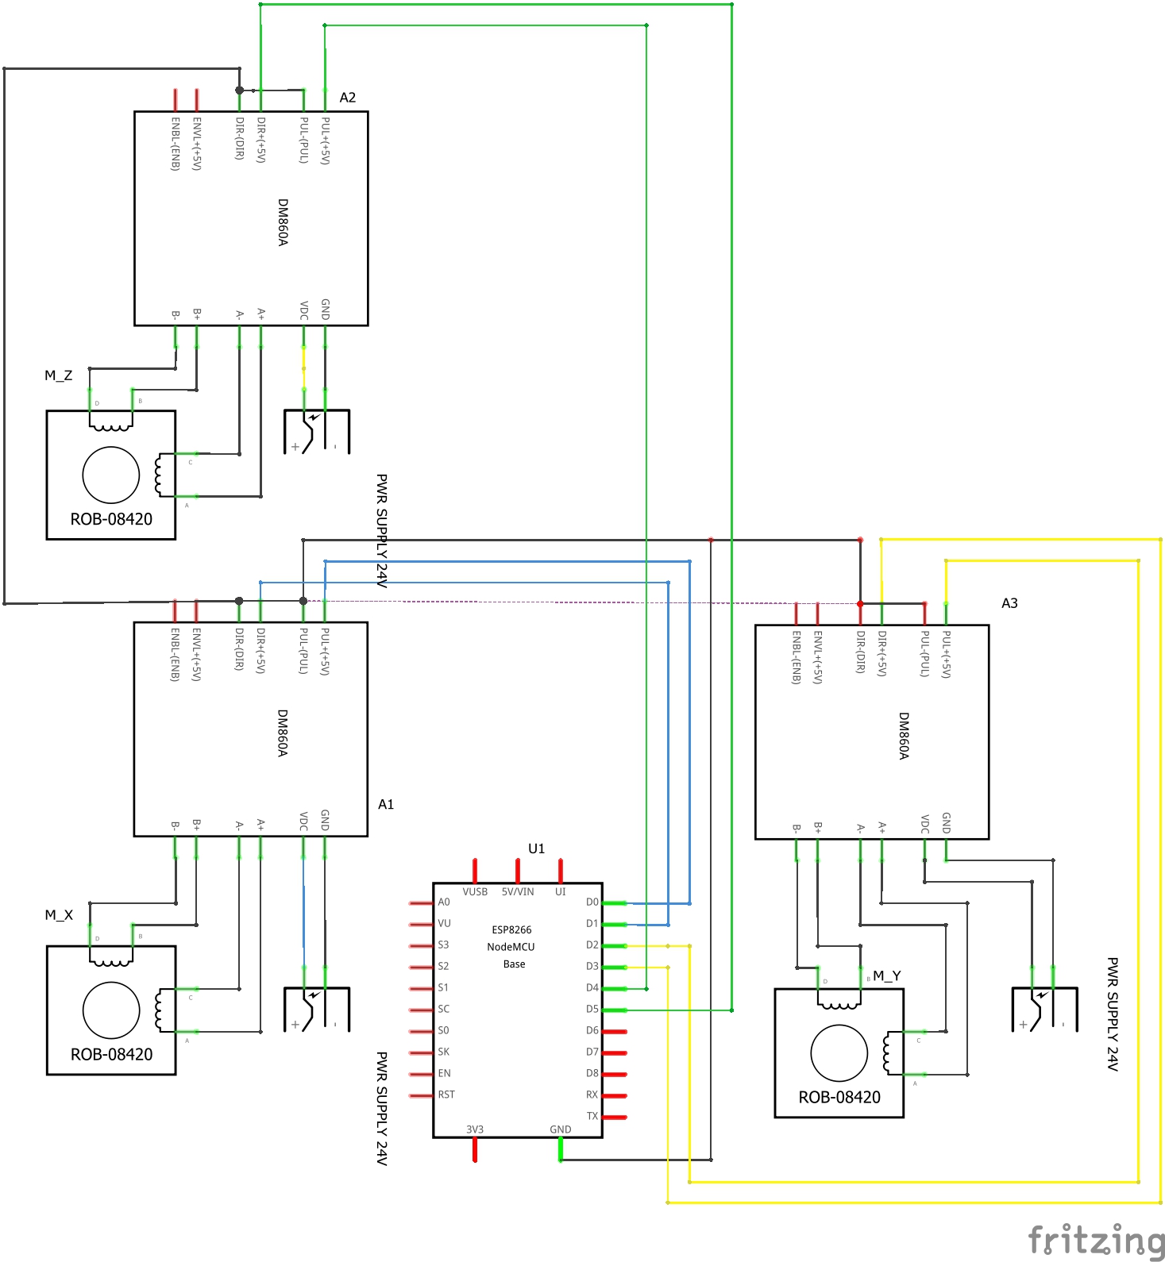
Electrical/Schematic Wiring.jpg
