BudimanZahri/mini_cnc_miling_engraver/Mechanical/3D Design/PBLMK-041-1.pdf

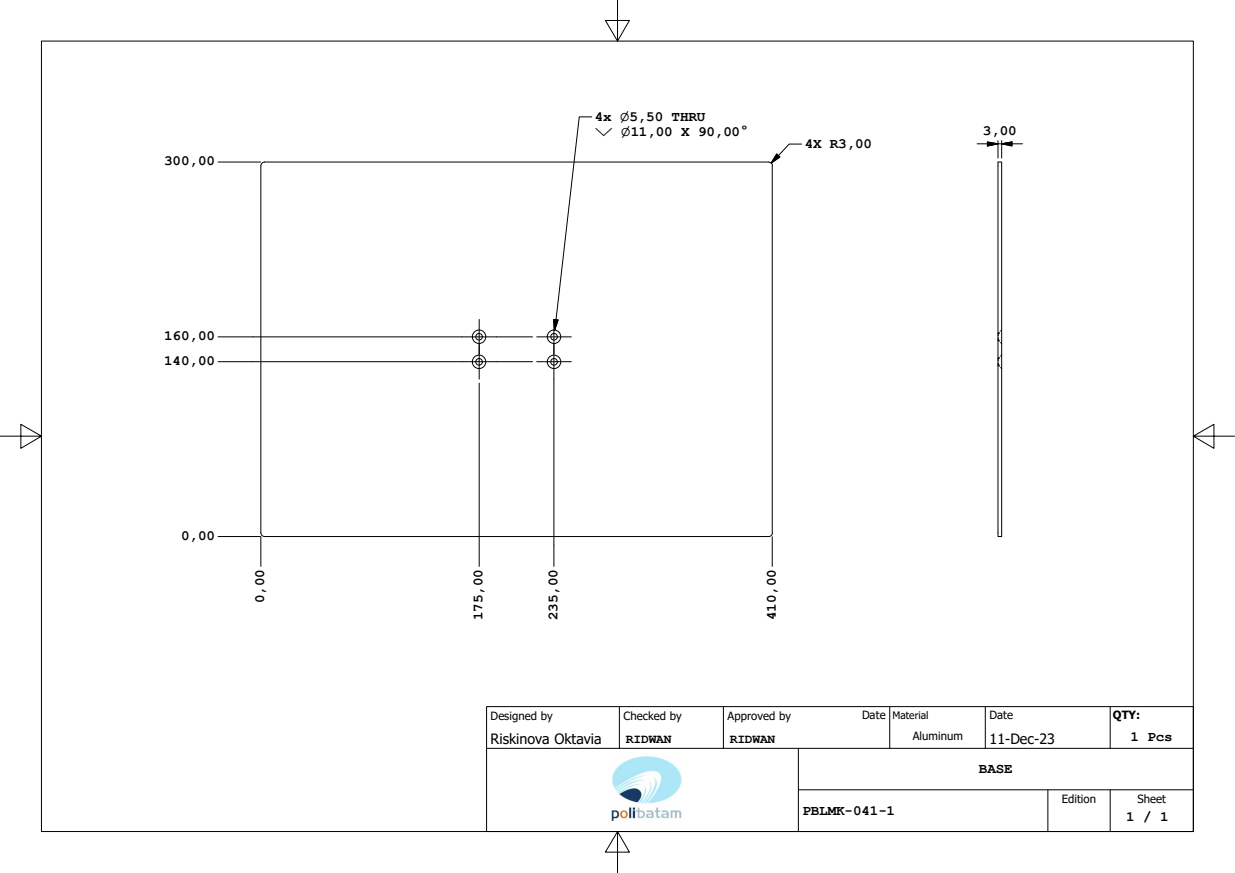
[picture p56: page 1]
BASE; PBLMK-041-1; Riskinova Oktavia; 11-Dec-23; Designed by; Checked by; Approved by; Date; Edition; Sheet; Aluminum; Material; RIDWAN; 4x P5,50 THRU Y P11,00 X 90,00; 1 Pcs; QTY:
