BudimanZahri/mini_cnc_miling_engraver/Mechanical/3D Design/PBLMK-041-2.pdf

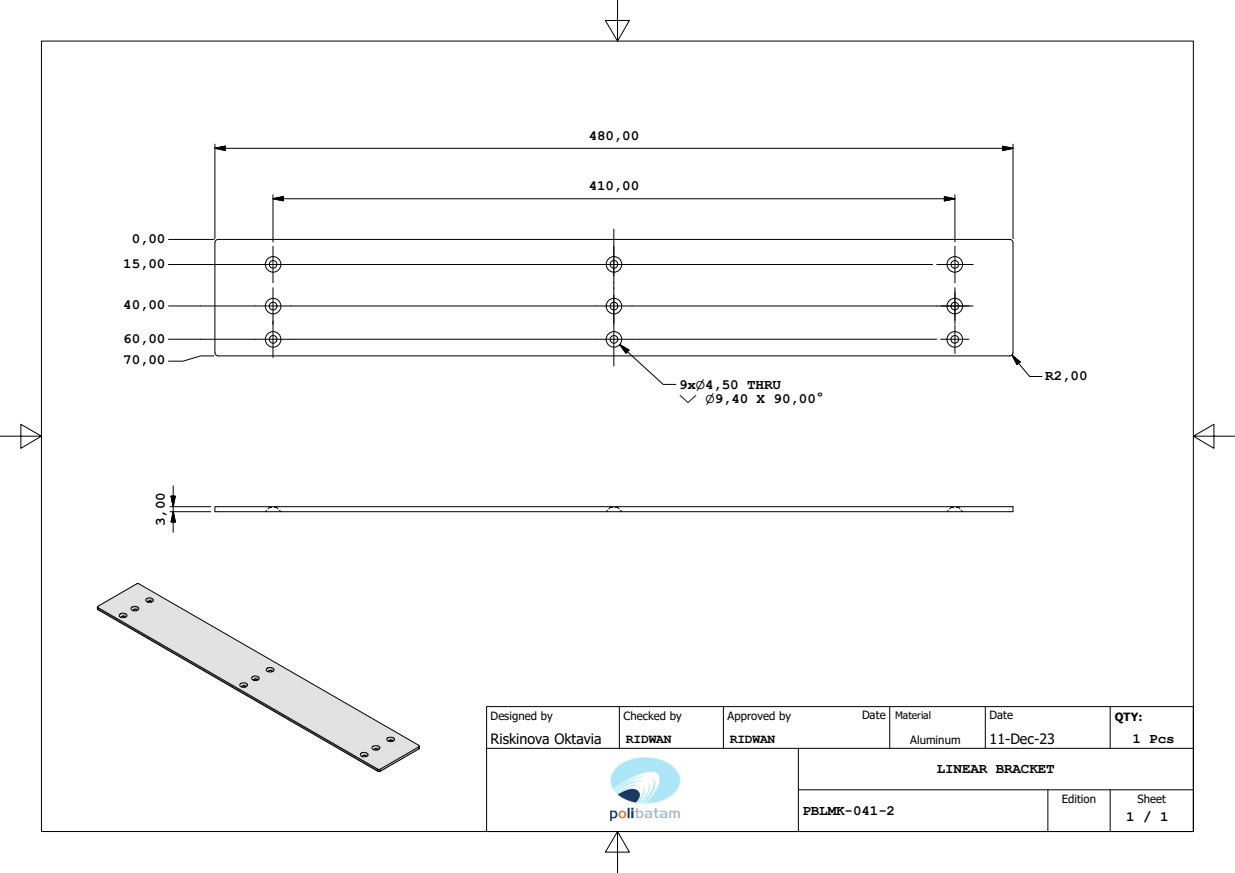
[picture p57: page 1]
LINEAR BRACKET; PBLMK-041-2; Riskinova Oktavia; 11-Dec-23; Designed by; Checked by; Approved by; Date; Edition; Sheet; RIDWAN; 9xP4,50 THRU Y P9,40 X 90,00; Material; Aluminum; 1 Pcs; QTY:
