BudimanZahri/mini_cnc_miling_engraver/Mechanical/3D Design/PBLMK-041-3.pdf

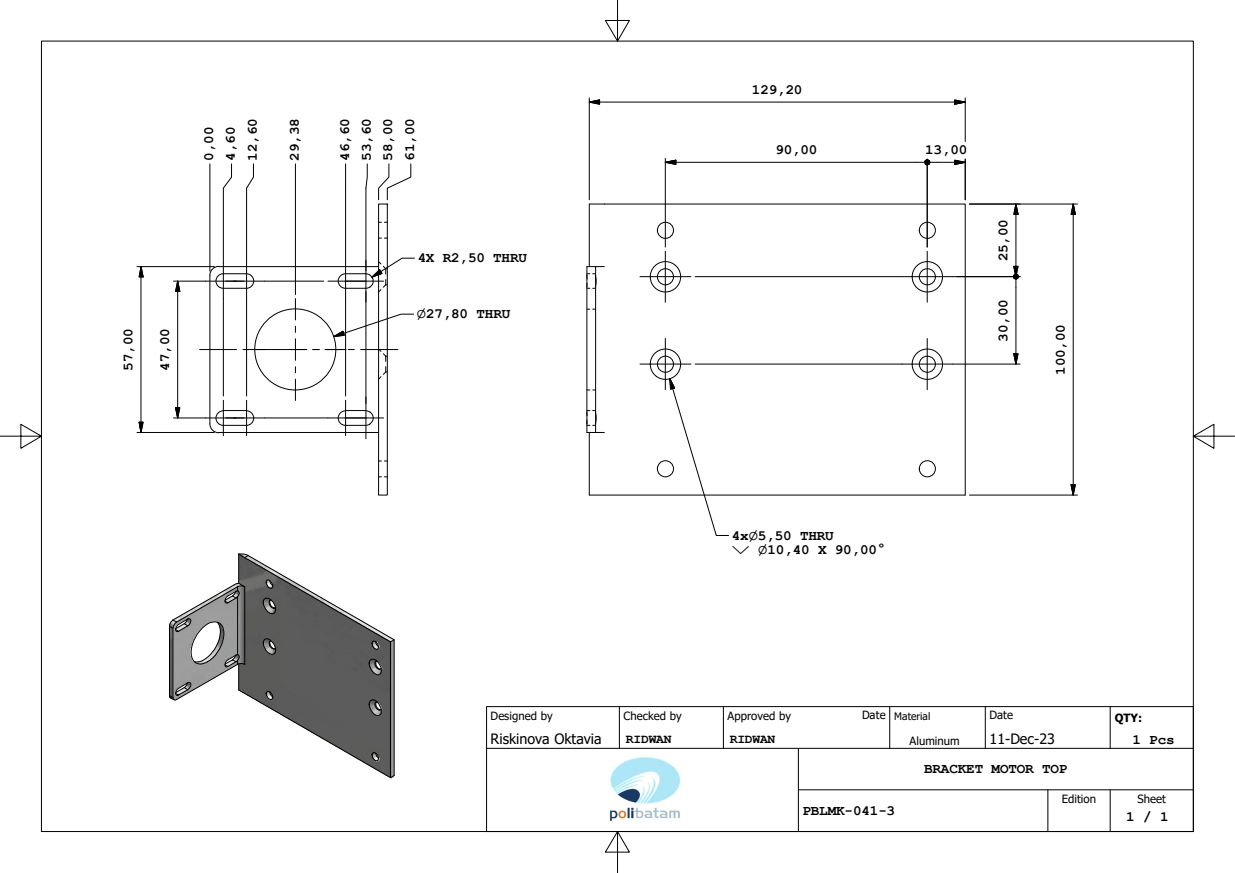
[picture p58: page 1]
PBLMK-041-3; Riskinova Oktavia; 11-Dec-23; Designed by; Checked by; Approved by; Date; Edition; Sheet; RIDWAN; 4X R2,50 THRU; P27,80 THRU; 4xP5,50 THRU Y P10,40 X 90,00; Aluminum; Material; QTY:; 1 Pcs

BRACKET MOTOR TOP
