BudimanZahri/mini_cnc_miling_engraver/Mechanical/3D Design/PBLMK-041-4.pdf

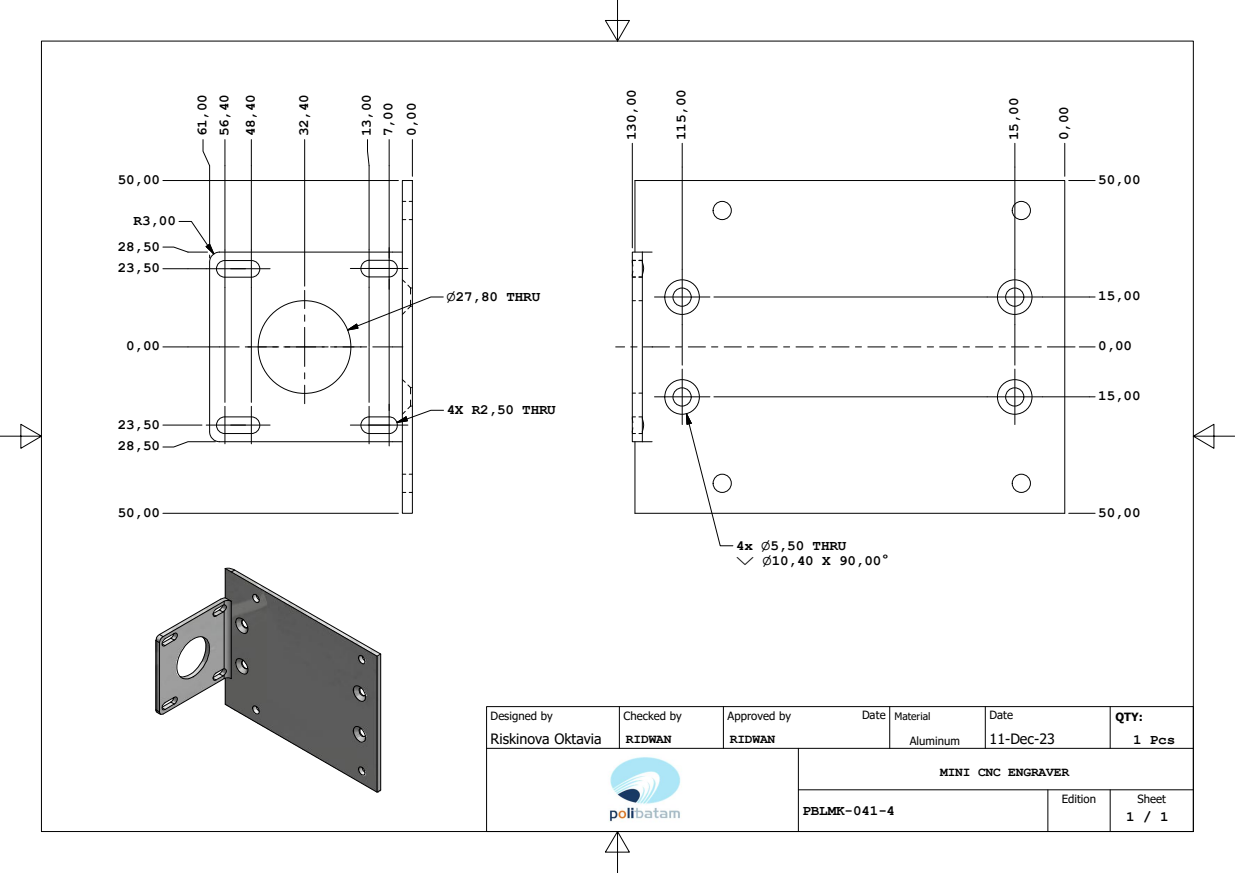
[picture p59: page 1]
PBLMK-041-4; Riskinova Oktavia; 11-Dec-23; Designed by; Checked by; Approved by; Date; Edition; Sheet; RIDWAN; 4X R2,50 THRU; P27,80 THRU; 4x P5,50 THRU Y P10,40 X 90,00; Material; Aluminum; 1 Pcs; QTY:

MINI CNC ENGRAVER
