BudimanZahri/mini_cnc_miling_engraver/Mechanical/3D Design/PBLMK-041-5.pdf

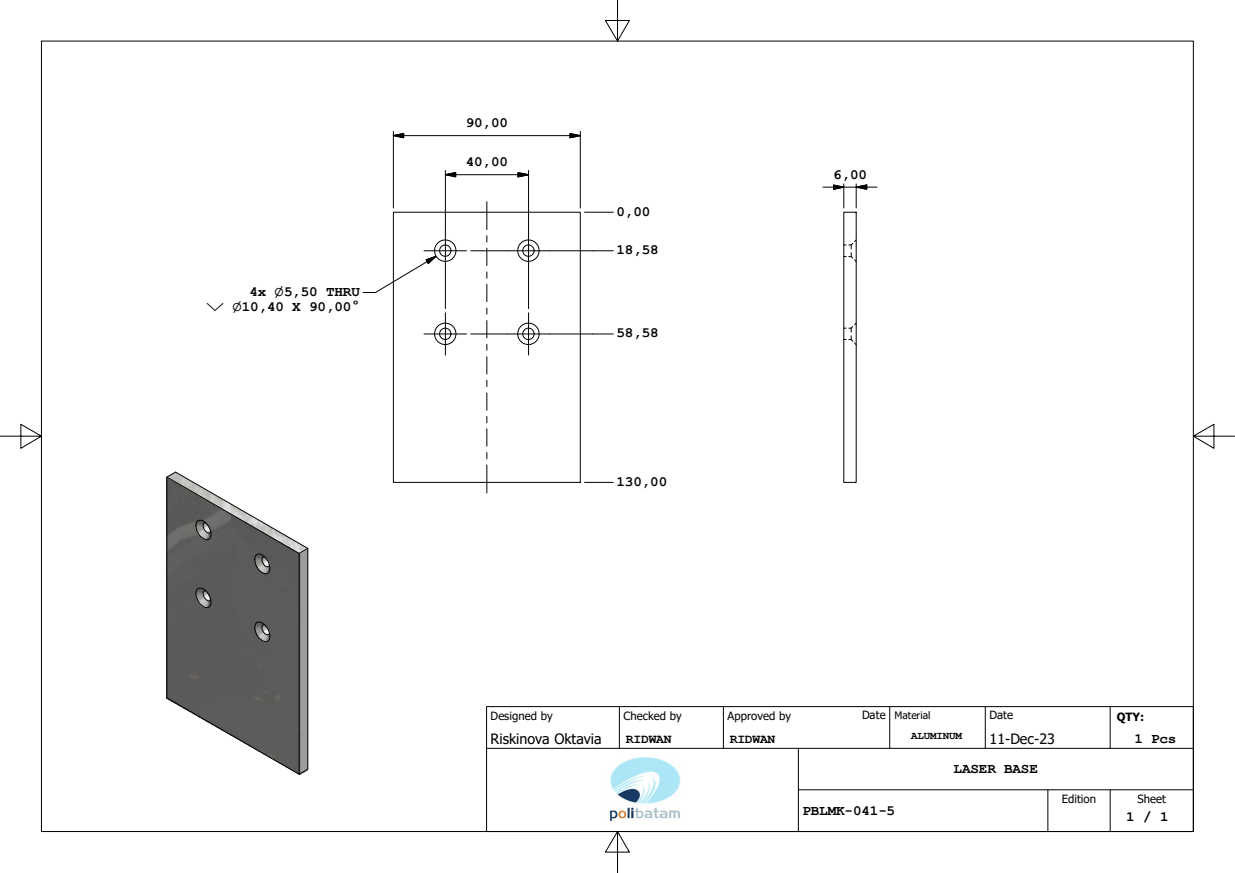
[picture p60: page 1]
LASER BASE; PBLMK-041-5; Riskinova Oktavia; 11-Dec-23; Designed by; Checked by; Approved by; Date; Edition; Sheet; RIDWAN; 4x P5,50 THRU Y P10,40 X 90,00; ALUMINUM; Material; QTY:; 1 Pcs
