BudimanZahri/mini_cnc_miling_engraver/Mechanical/3D Design/PBLMK-041-A.pdf

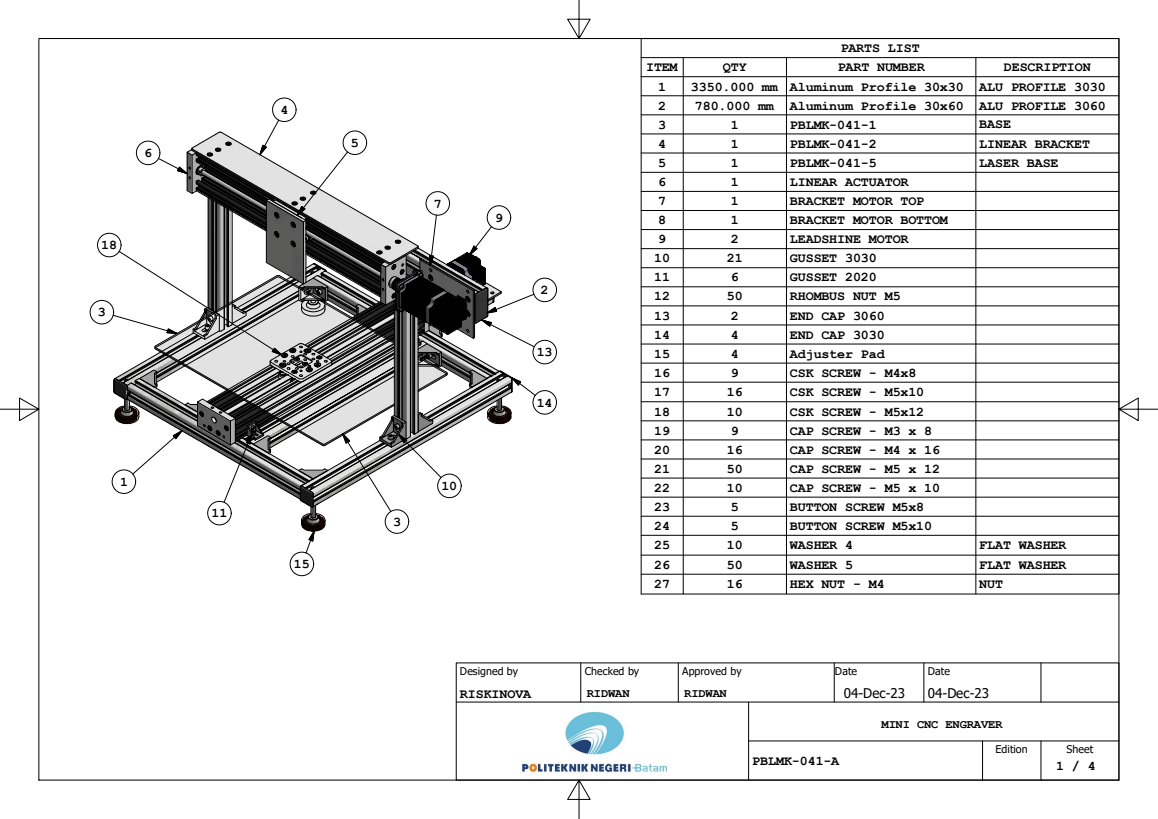
[picture p61: page 1]
PARTS LIST; ITEM; QTY; PART NUMBER; DESCRIPTION; Aluminum Profile 30x30; ALU PROFILE 3030; Aluminum Profile 30x60; ALU PROFILE 3060; PBLMK-041-1; BASE; PBLMK-041-2; LINEAR BRACKET; PBLMK-041-5; LASER BASE; LINEAR ACTUATOR; BRACKET MOTOR TOP; BRACKET MOTOR BOTTOM; LEADSHINE MOTOR; GUSSET 3030; GUSSET 2020; RHOMBUS NUT M5; END CAP 3060; END CAP 3030; Adjuster Pad; CSK SCREW - M4x8; CSK SCREW - M5x10; CSK SCREW - M5x12; CAP SCREW - M3 x 8; CAP SCREW - M4 x 16; CAP SCREW - M5 x 12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

MINI CNC ENGRAVER

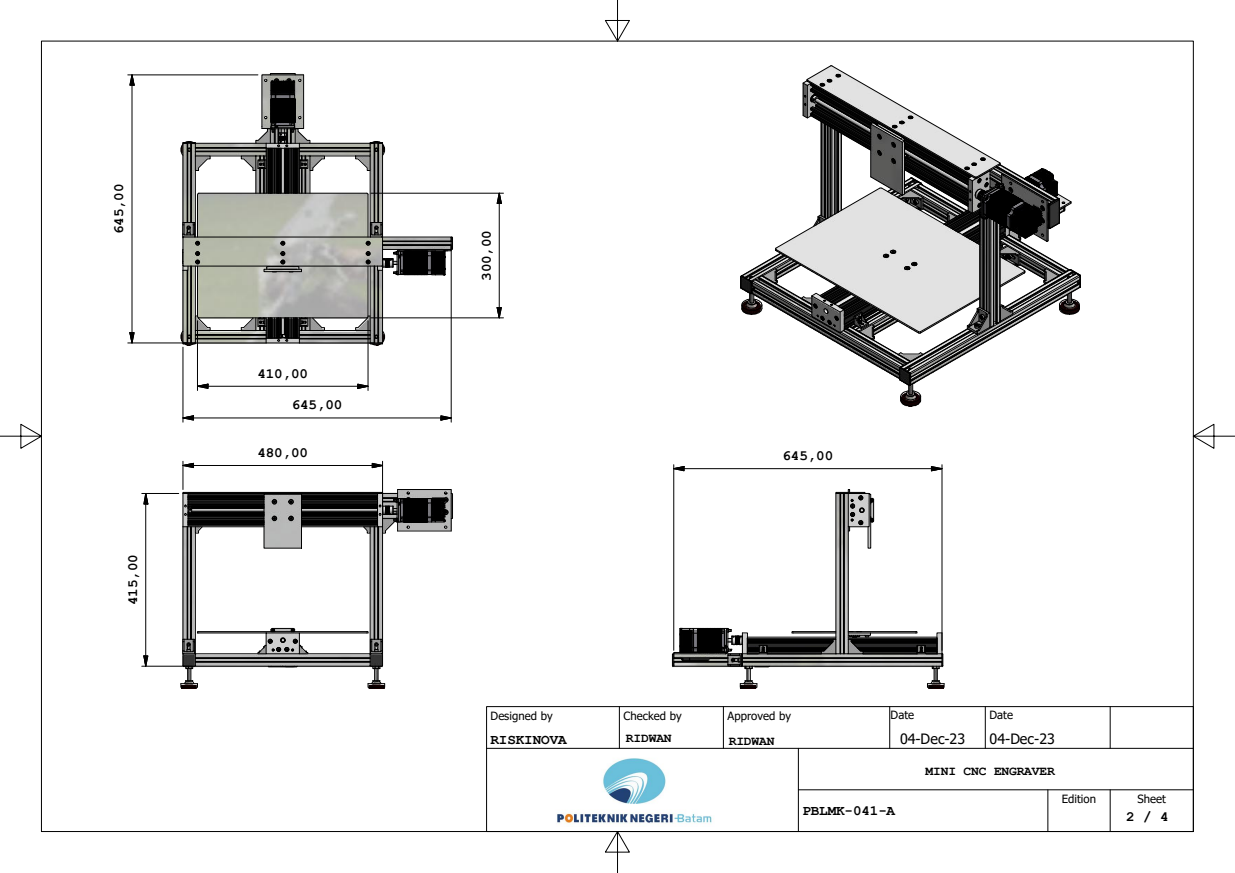
[picture p62: page 2]
RISKINOVA; 04-Dec-23; Designed by; Checked by; Approved by; Date; Edition; Sheet; RIDWAN

MINI CNC ENGRAVER

A ( .6 )

B ( .6 )

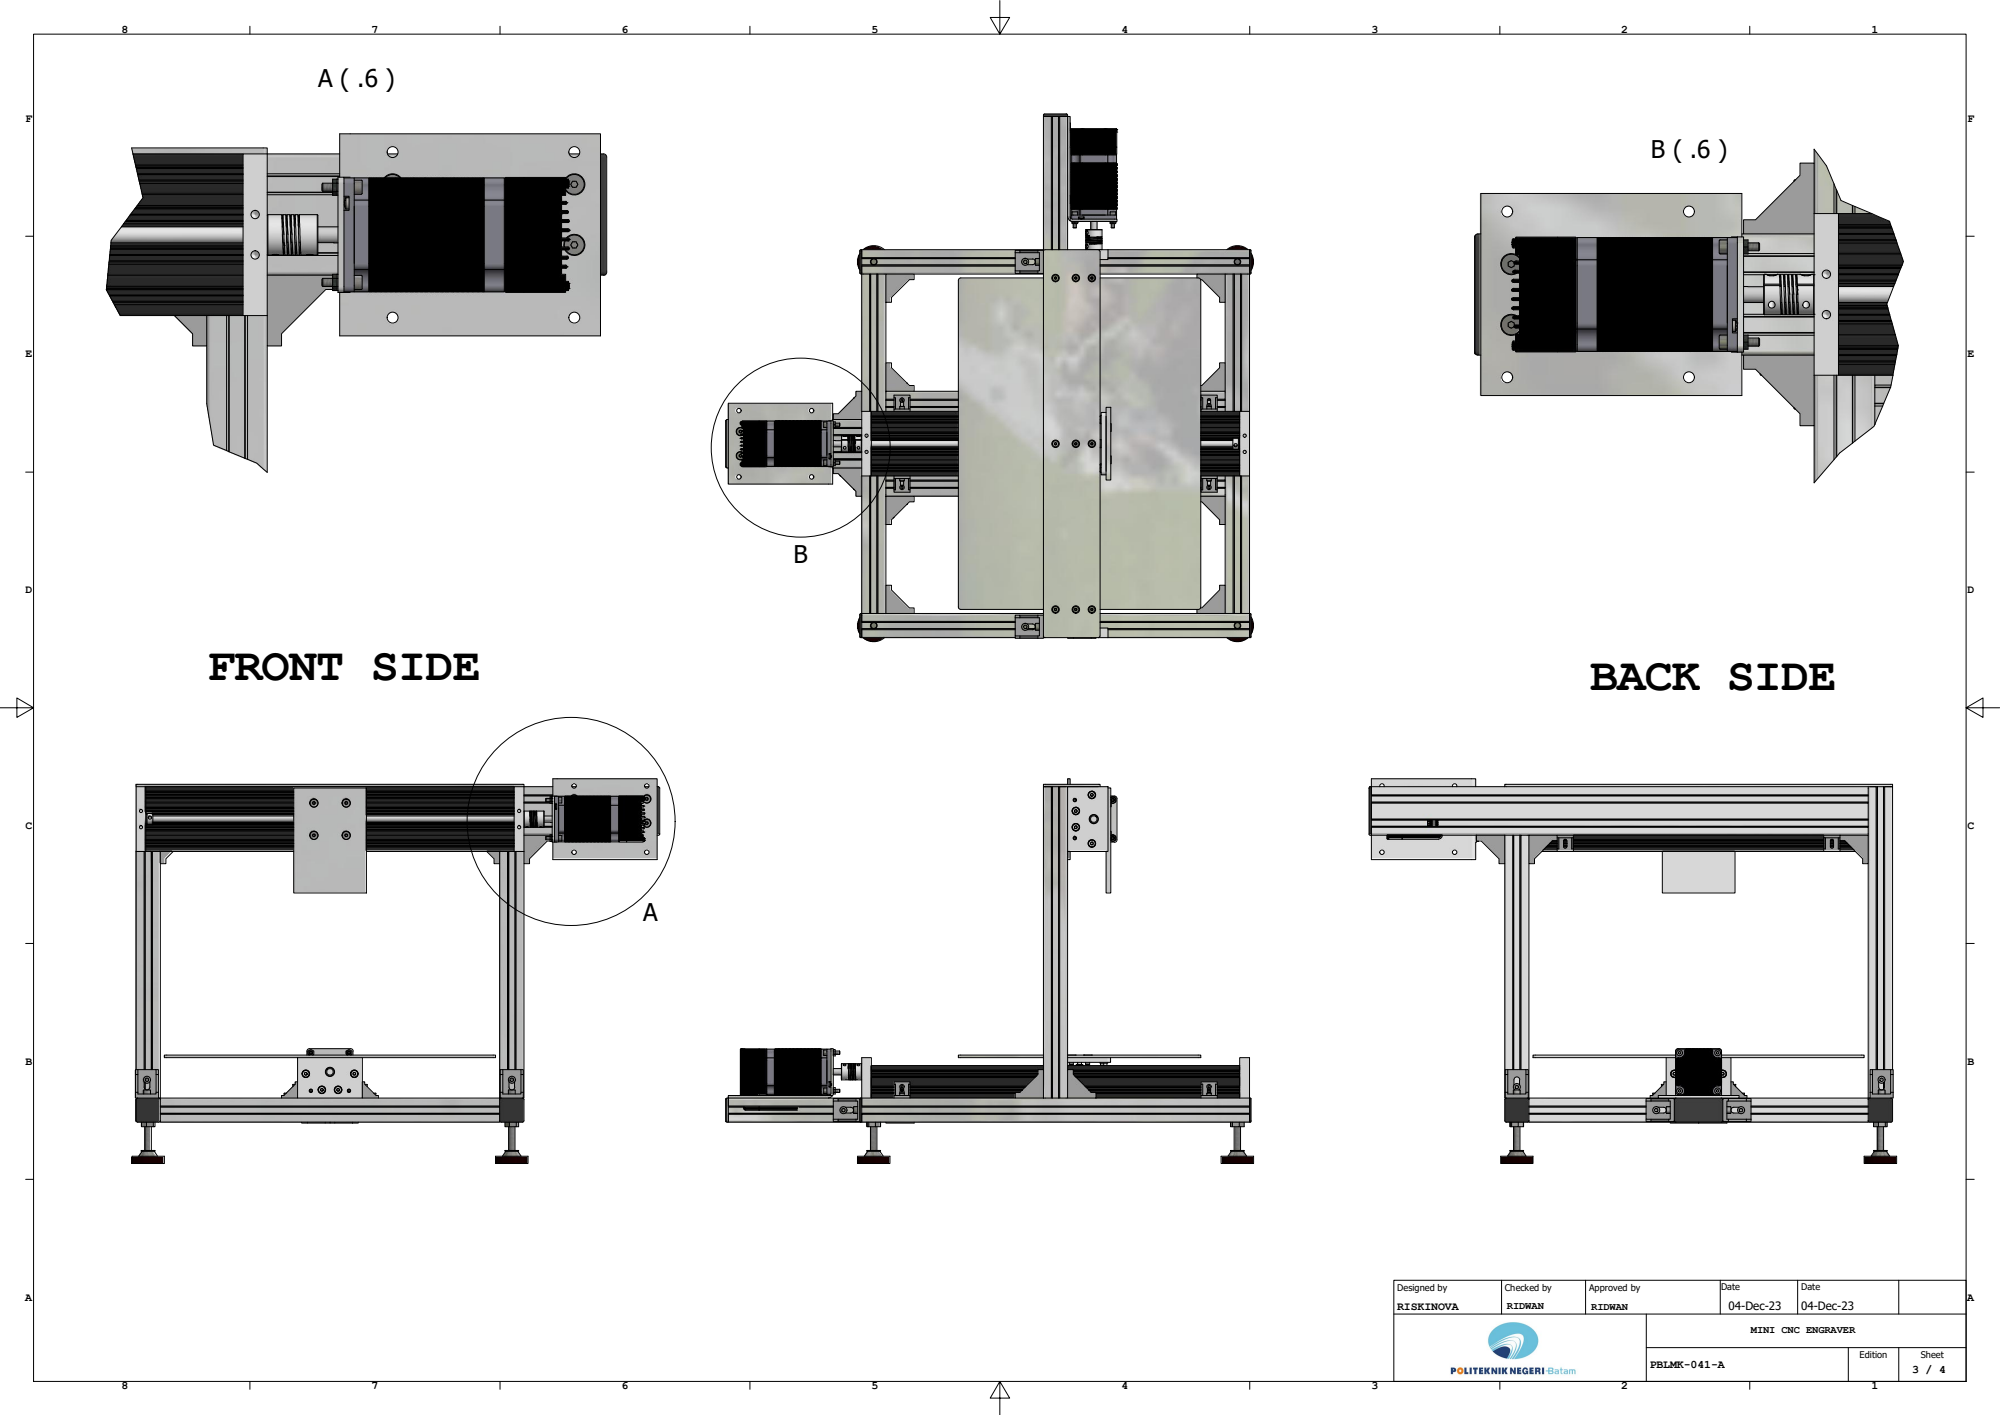
[picture p63: page 3]
RISKINOVA; 04-Dec-23; Designed by; Checked by; Approved by; Date; Edition; Sheet; FRONT SIDE; BACK SIDE; RIDWAN

MINI CNC ENGRAVER

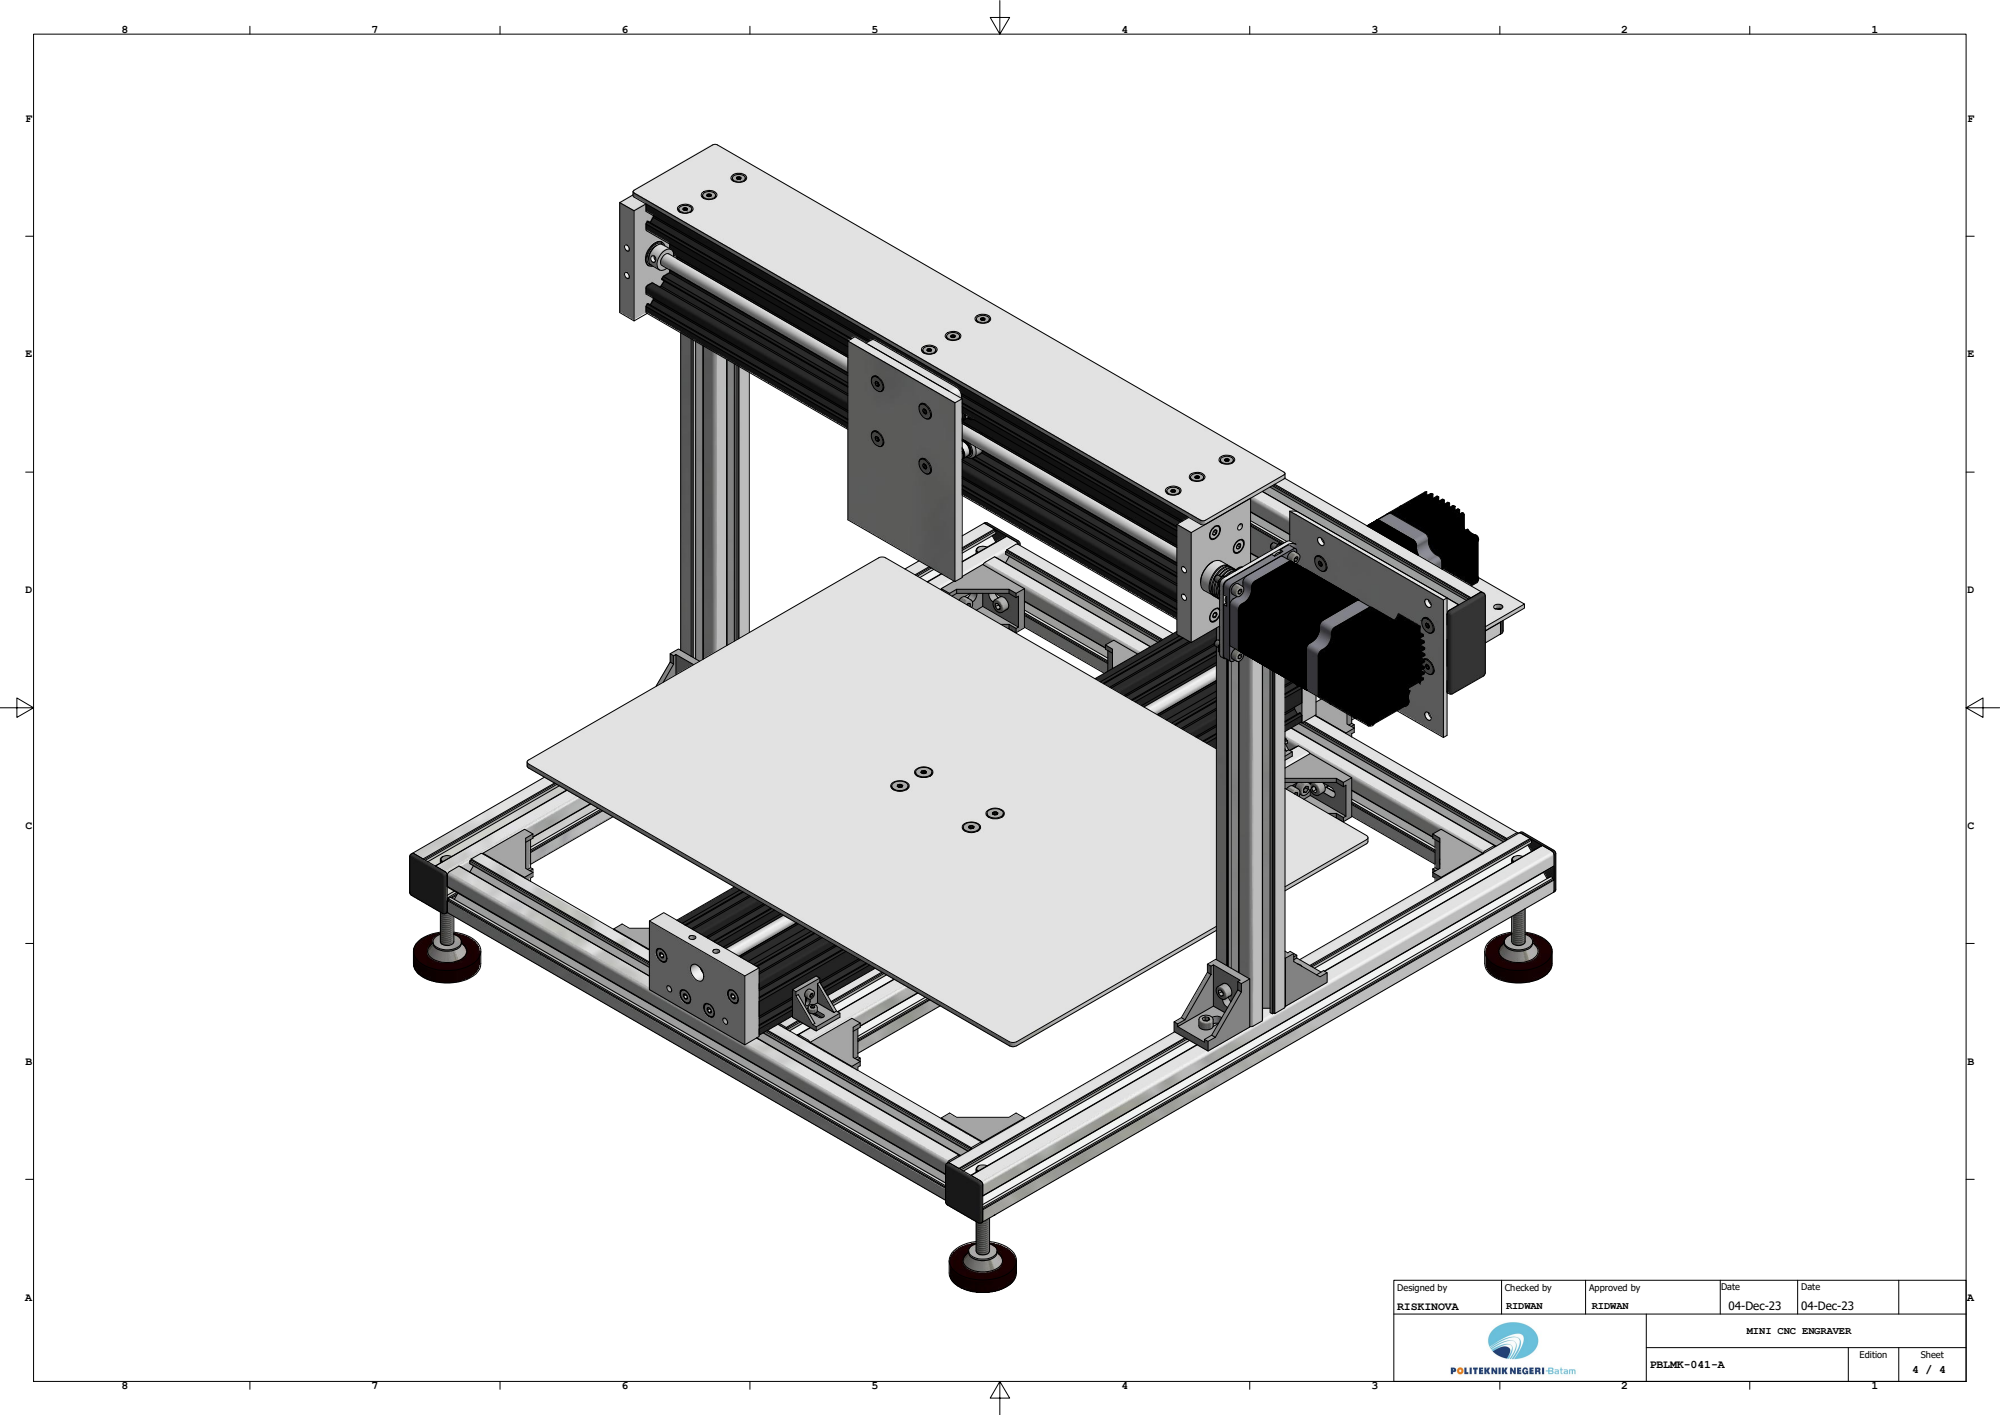
[picture p64: page 4]
RISKINOVA; 04-Dec-23; Designed by; Checked by; Approved by; Date; Edition; Sheet; RIDWAN

MINI CNC ENGRAVER
