BudimanZahri/mini_cnc_miling_engraver/Mechanical/3D Design/PBLMK-041-ALU 165.pdf

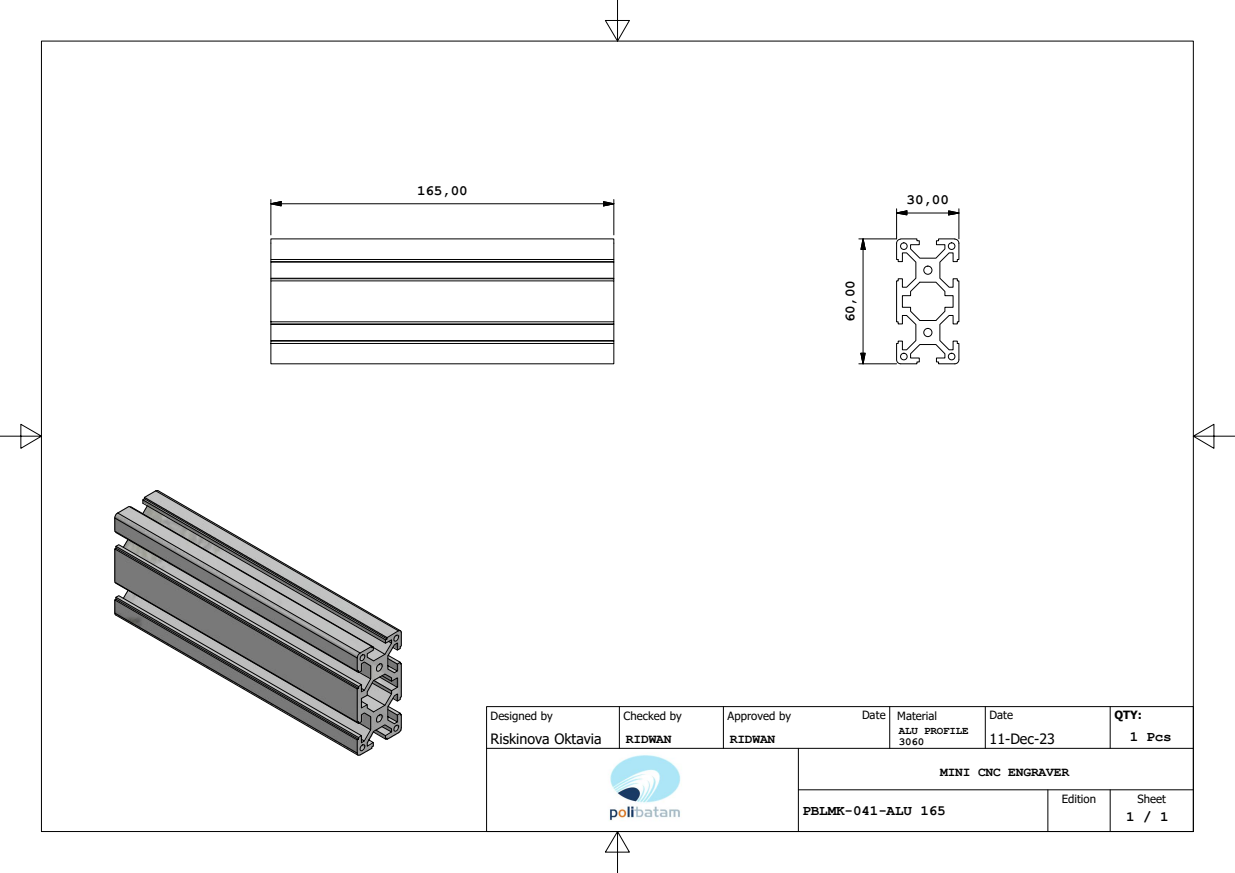
[picture p65: page 1]
PBLMK-041-ALU 165; Riskinova Oktavia; 11-Dec-23; Designed by; Checked by; Approved by; Date; Edition; Sheet; Material; RIDWAN; ALU PROFILE 3060; QTY:; 1 Pcs

MINI CNC ENGRAVER
