BudimanZahri/mini_cnc_miling_engraver/Mechanical/3D Design/PBLMK-041-ALU 325.pdf

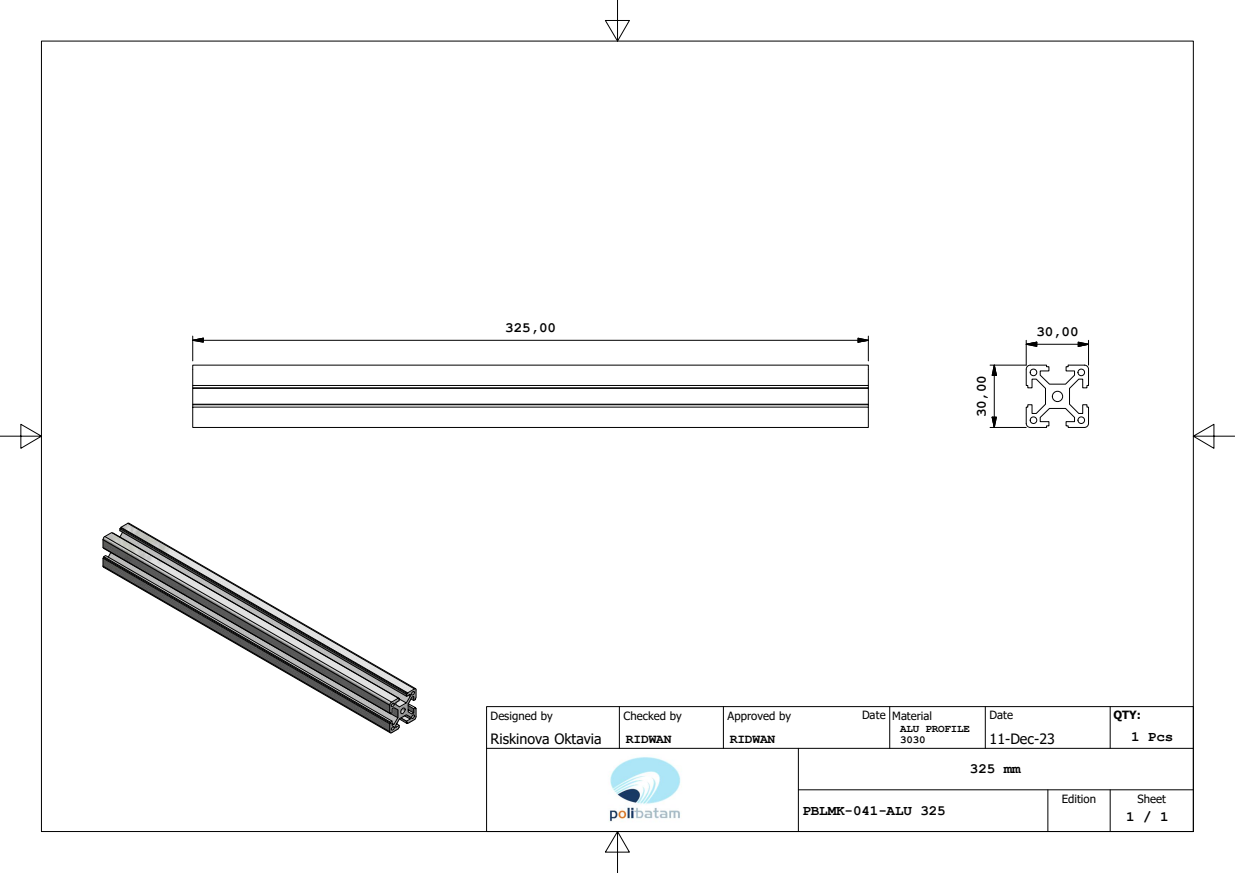
[picture p66: page 1]
PBLMK-041-ALU 325; Riskinova Oktavia; 11-Dec-23; Designed by; Checked by; Approved by; Date; Edition; Sheet; Material; RIDWAN; QTY:; 1 Pcs; ALU PROFILE 3030
