BudimanZahri/mini_cnc_miling_engraver/Mechanical/3D Design/PBLMK-041-ALU 385.pdf

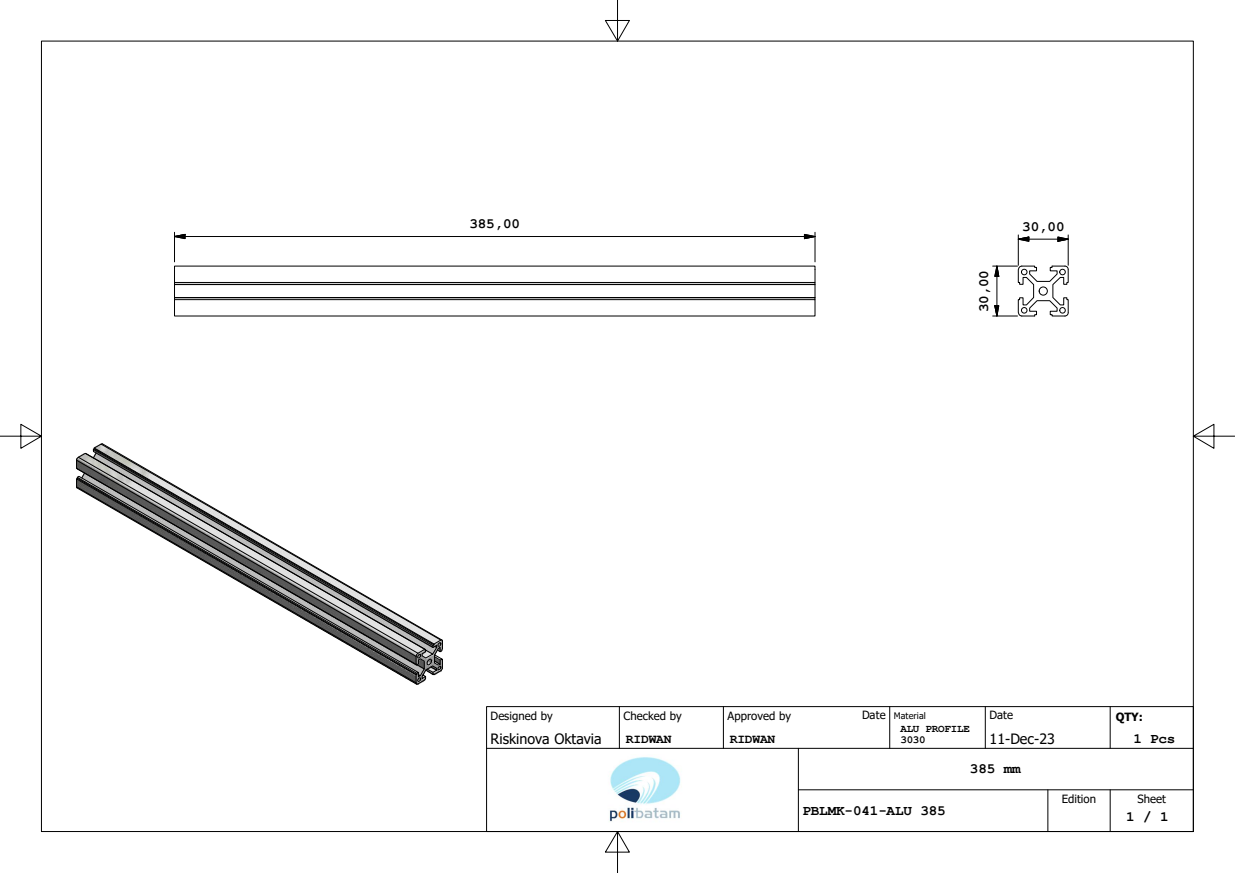
[picture p67: page 1]
PBLMK-041-ALU 385; Riskinova Oktavia; 11-Dec-23; Designed by; Checked by; Approved by; Date; Edition; Sheet; RIDWAN; ALU PROFILE 3030; QTY:; 1 Pcs; Material
