BudimanZahri/mini_cnc_miling_engraver/Mechanical/3D Design/PBLMK-041-ALU 420.pdf

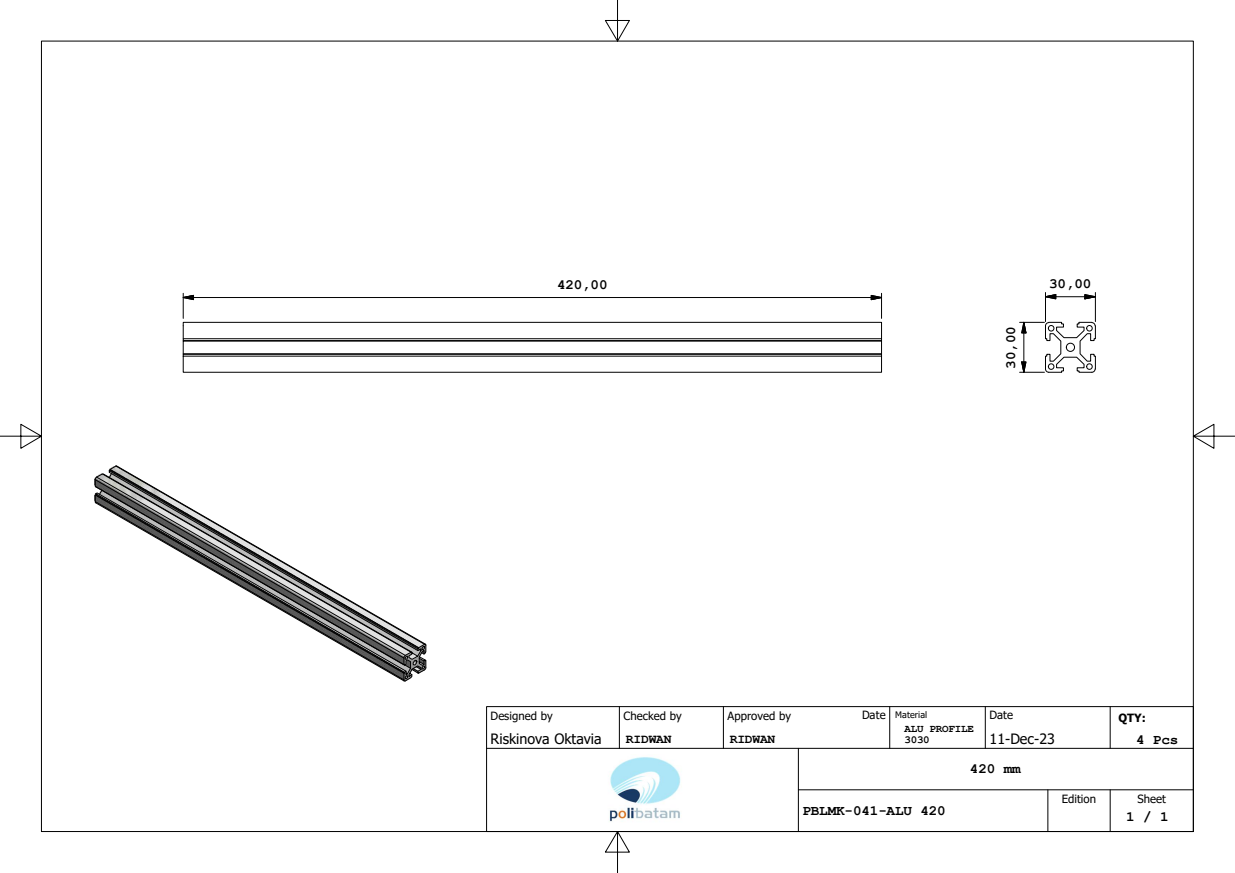
[picture p68: page 1]
PBLMK-041-ALU 420; Riskinova Oktavia; 11-Dec-23; Designed by; Checked by; Approved by; Date; Edition; Sheet; RIDWAN; Material; ALU PROFILE 3030; QTY:; 4 Pcs
