BudimanZahri/mini_cnc_miling_engraver/Mechanical/3D Design/PBLMK-041-ALU 480.pdf

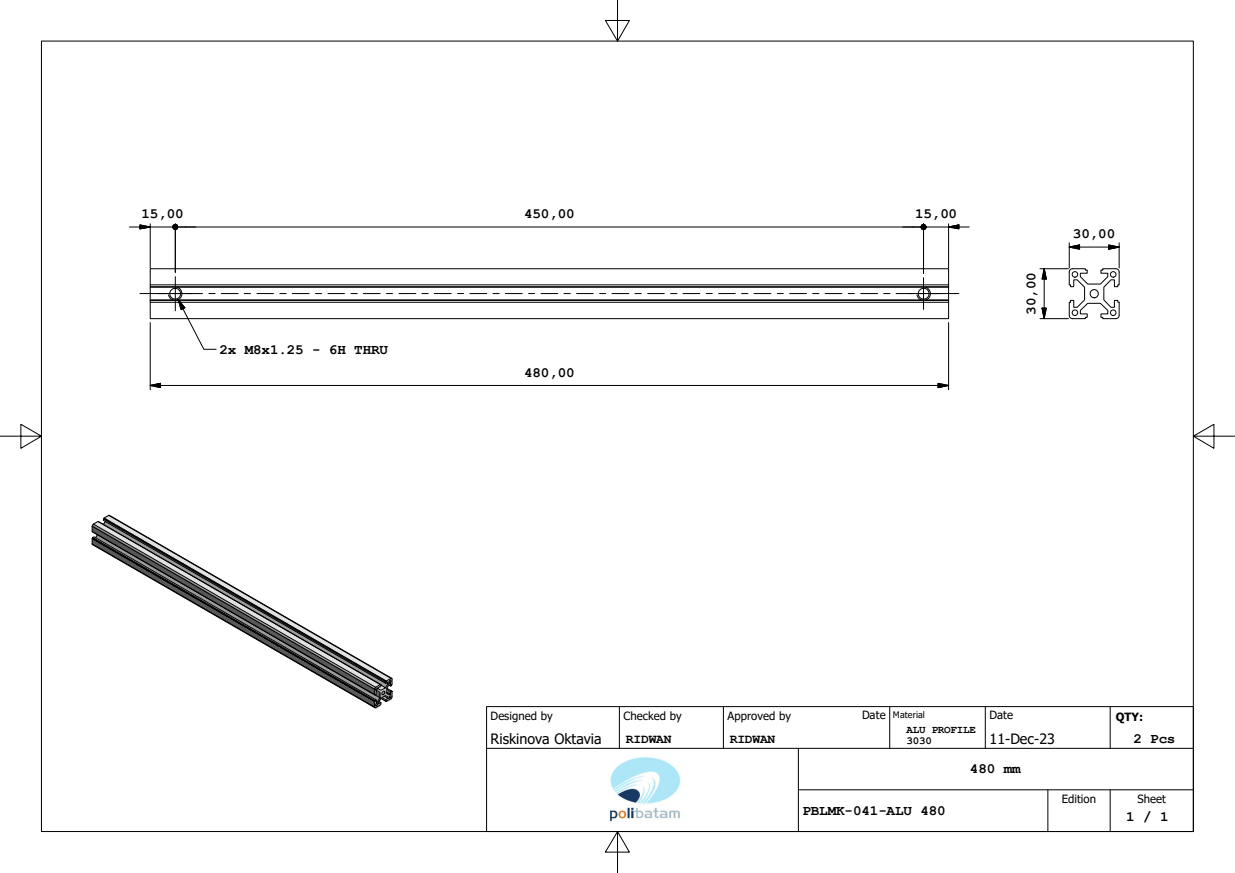
[picture p69: page 1]
PBLMK-041-ALU 480; Riskinova Oktavia; 11-Dec-23; Designed by; Checked by; Approved by; Date; Edition; Sheet; RIDWAN; 2 Pcs; QTY:; ALU PROFILE 3030; Material; 2x M8x1.25 - 6H THRU
