BudimanZahri/mini_cnc_miling_engraver/Mechanical/Drawing 2D design mechanical/Gambar Kerja (2D)/1.Aluminium V slot 2040 248.mm 2D.PDF

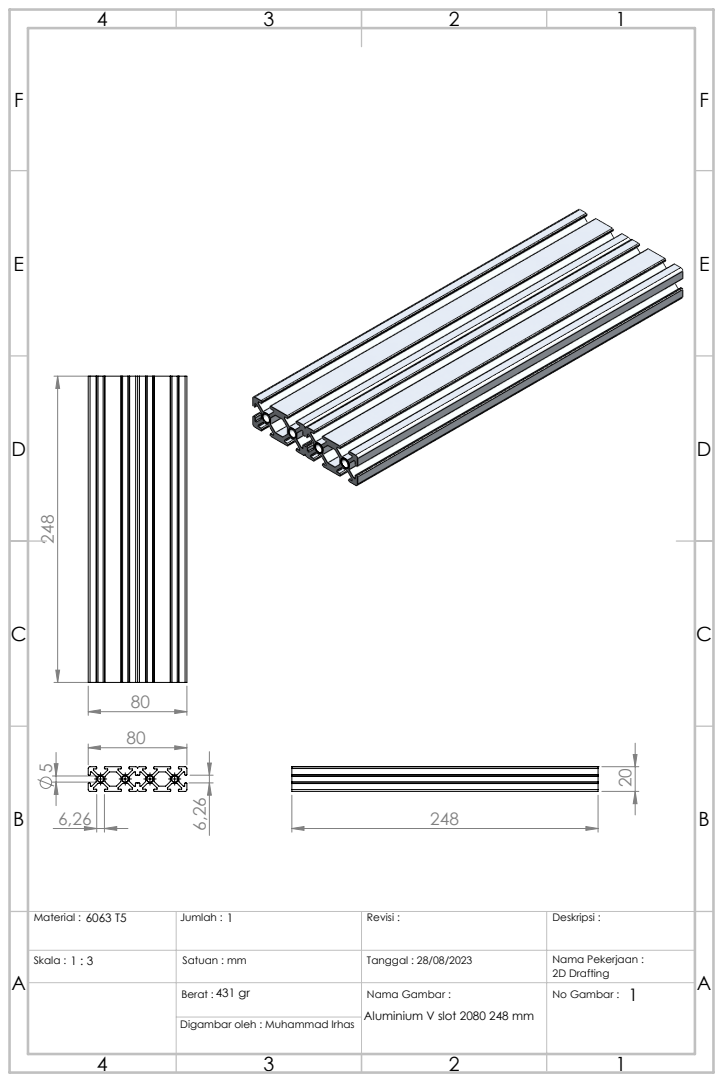
[picture p71: page 1]
Digambar oleh :; Muhammad Irhas

Material : 6063 T5 | Jumlah : 1 | Revisi : | Deskripsi :

Skala : 1 : 3 | Satuan : mm | Tanggal : 28/08/2023 | Nama Pekerjaan : 2D Drafting

Berat : | Nama Gambar : Aluminium V slot 2080 248 mm | 1 No Gambar :
