BudimanZahri/mini_cnc_miling_engraver/Mechanical/Drawing 2D design mechanical/Gambar Kerja (2D)/10.Aluminium V slot 20100 80 mm 2D.PDF

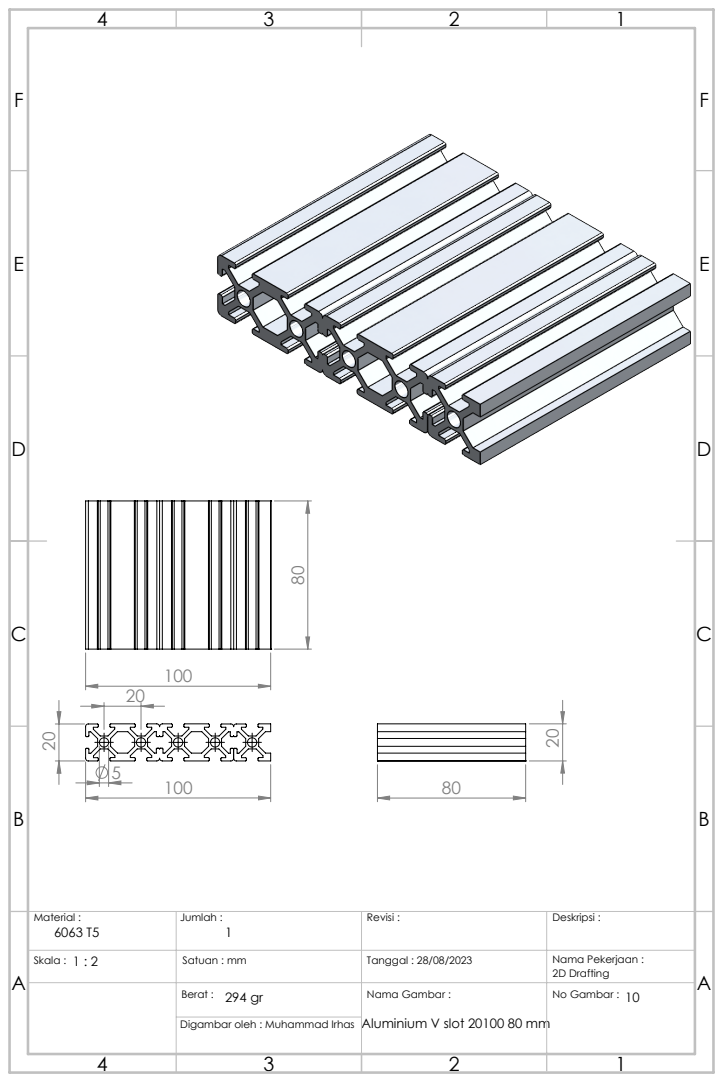
[picture p72: page 1]
Digambar oleh :; Muhammad Irhas

Material : 6063 T5 | Jumlah : 1 | Revisi : | Deskripsi :

Skala : 1 : 2 | Satuan : mm | Tanggal : 28/08/2023 | Nama Pekerjaan : 2D Drafting

Berat : 294 gr | Nama Gambar : Aluminium V slot 20100 80 mm | No Gambar : 10
