BudimanZahri/mini_cnc_miling_engraver/Mechanical/Drawing 2D design mechanical/Gambar Kerja (2D)/11.Bracket Spindle Clamp 2D.PDF

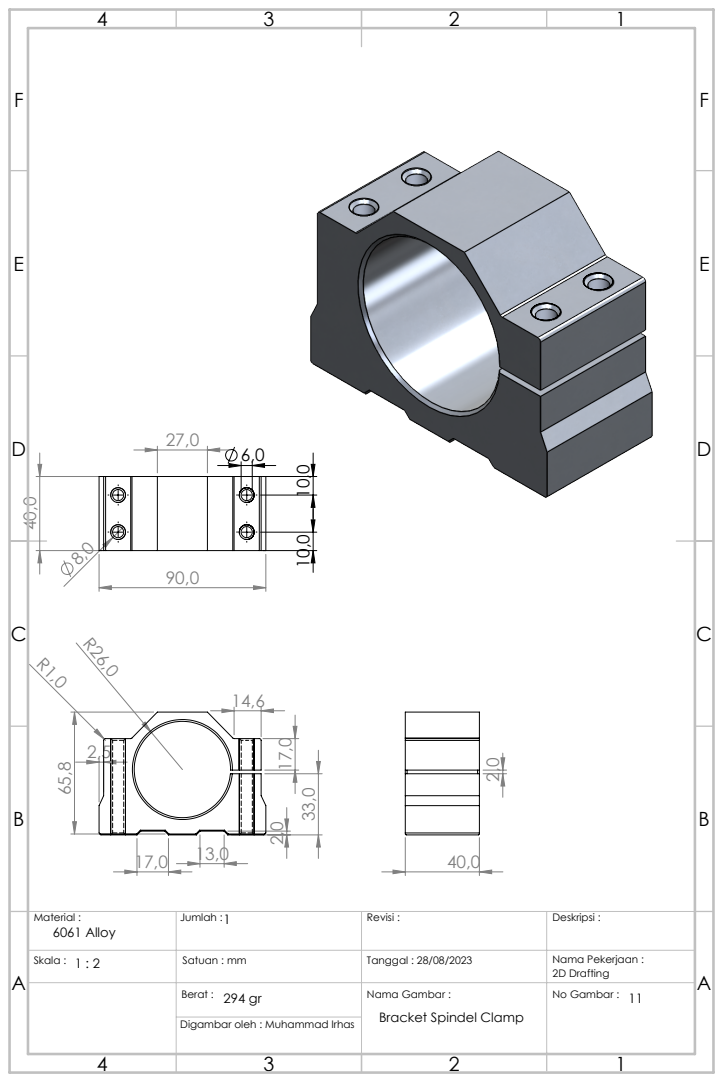
[picture p73: page 1]
Digambar oleh :; Muhammad Irhas

Material : 6061 Alloy | Jumlah : 1 | Revisi : | Deskripsi :

Skala : 1 : 2 | Satuan : mm | Tanggal : 28/08/2023 | Nama Pekerjaan : 2D Drafting

Berat : 294 gr | Nama Gambar : Bracket Spindel Clamp | No Gambar : 11
