BudimanZahri/mini_cnc_miling_engraver/Mechanical/Drawing 2D design mechanical/Gambar Kerja (2D)/12.Bearing Pillow Block KFL08 8mm 2D.PDF

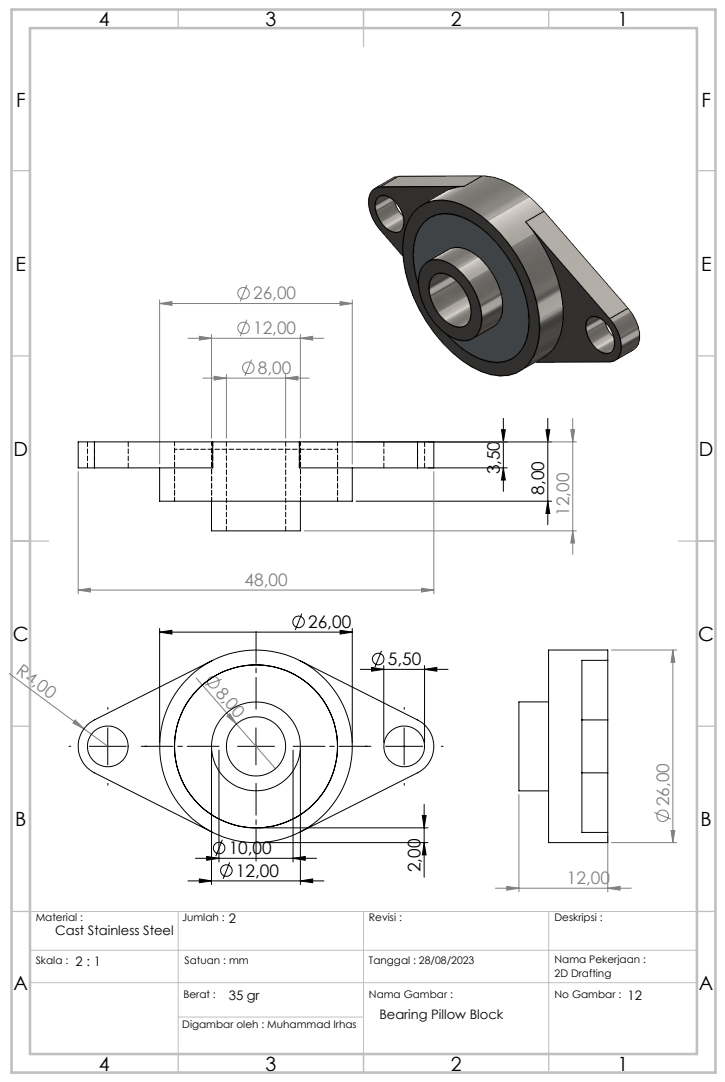
[picture p74: page 1]
Digambar oleh :; Muhammad Irhas

Material : Cast Stainless Steel | Jumlah : 2 | Revisi : | Deskripsi :

Skala : 2 : 1 | Satuan : mm | Tanggal : 28/08/2023 | Nama Pekerjaan : 2D Drafting

Berat : 35 gr | Nama Gambar : Bearing Pillow Block | No Gambar : 12
