BudimanZahri/mini_cnc_miling_engraver/Mechanical/Drawing 2D design mechanical/Gambar Kerja (2D)/13.lengan bagian kanan 2D.PDF

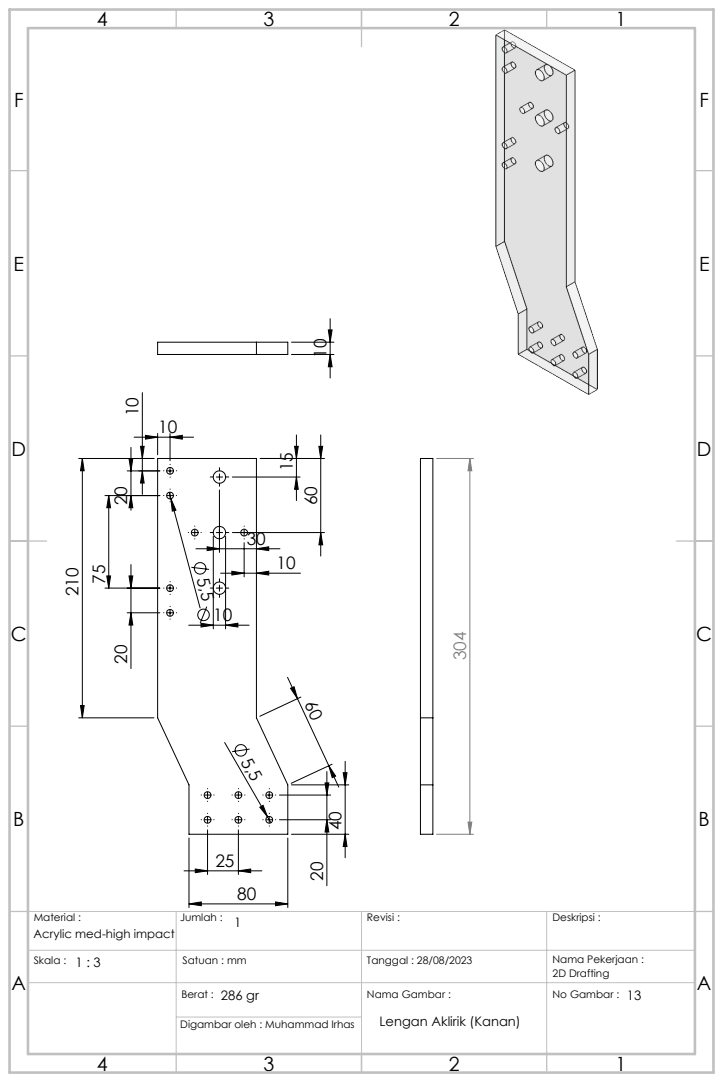
[picture p75: page 1]
Digambar oleh :; Muhammad Irhas

Material : Acrylic med-high impact | Jumlah : 1 | Revisi : | Deskripsi :

Skala : 1 : 3 | Satuan : mm | Tanggal : 28/08/2023 | Nama Pekerjaan : 2D Drafting

Berat : 286 gr | Nama Gambar : Lengan Aklirik (Kanan) | No Gambar : 13
