BudimanZahri/mini_cnc_miling_engraver/Mechanical/Drawing 2D design mechanical/Gambar Kerja (2D)/15.Aluminium V slot 2040 500 mm 2D.PDF

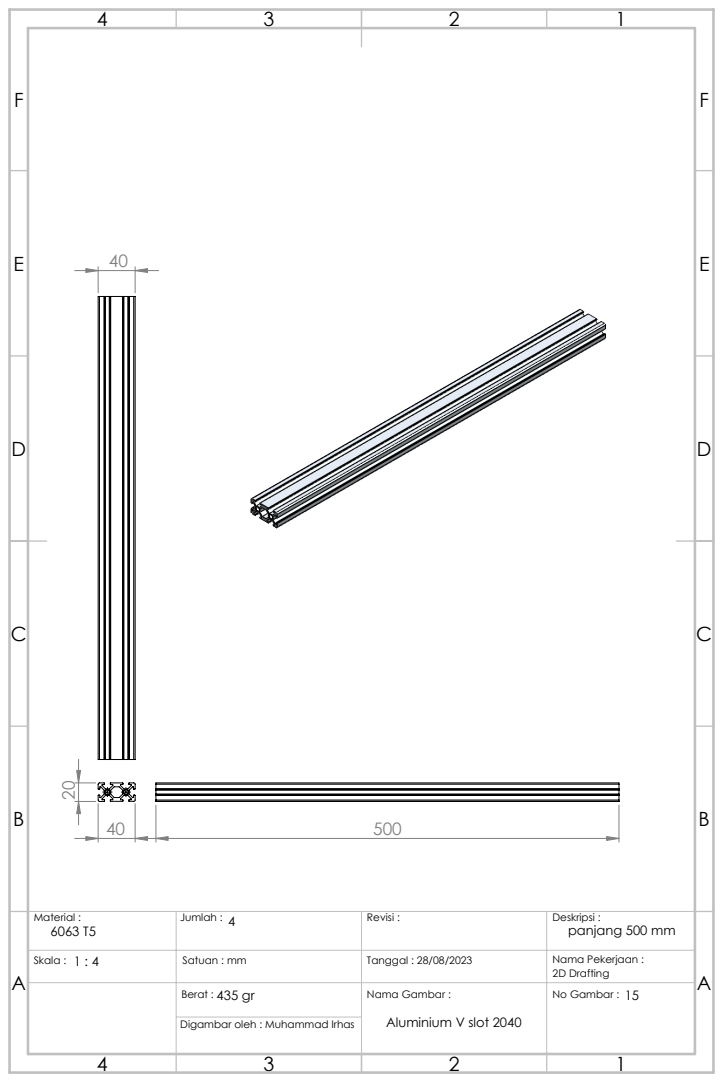
[picture p76: page 1]
Digambar oleh :; Muhammad Irhas

Material : 6063 T5 | Jumlah : 4 | Revisi : | Deskripsi : panjang 500 mm

Skala : 1 : 4 | Satuan : mm | Tanggal : 28/08/2023 | Nama Pekerjaan : 2D Drafting

Berat : 435 gr | Nama Gambar : Aluminium V slot 2040 | No Gambar : 15
