BudimanZahri/mini_cnc_miling_engraver/Mechanical/Drawing 2D design mechanical/Gambar Kerja (2D)/16.lead Screw T8 D2 lead 8 2D.PDF

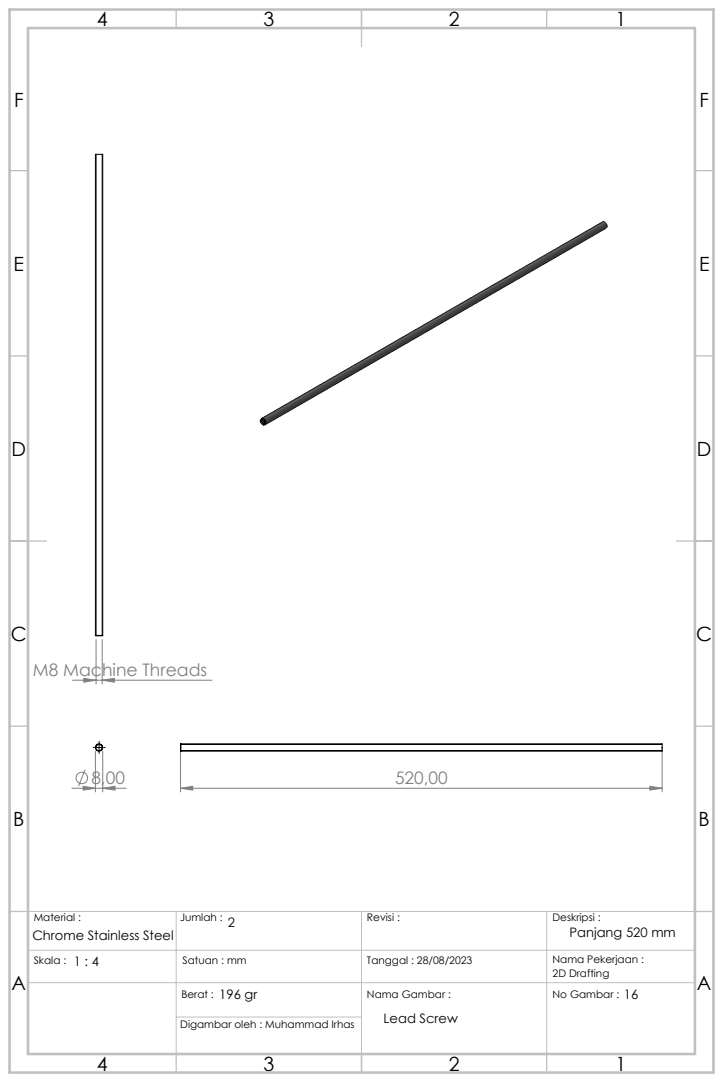
[picture p77: page 1]
M8 Machine Threads; Digambar oleh :; Muhammad Irhas

Material : Chrome Stainless Steel | Jumlah : 2 | Revisi : | Deskripsi : Panjang 520 mm

Skala : 1 : 4 | Satuan : mm | Tanggal : 28/08/2023 | Nama Pekerjaan : 2D Drafting

Berat : 196 gr | Nama Gambar : Lead Screw | No Gambar : 16
