BudimanZahri/mini_cnc_miling_engraver/Mechanical/Drawing 2D design mechanical/Gambar Kerja (2D)/17.Linear Shaft 2D.PDF

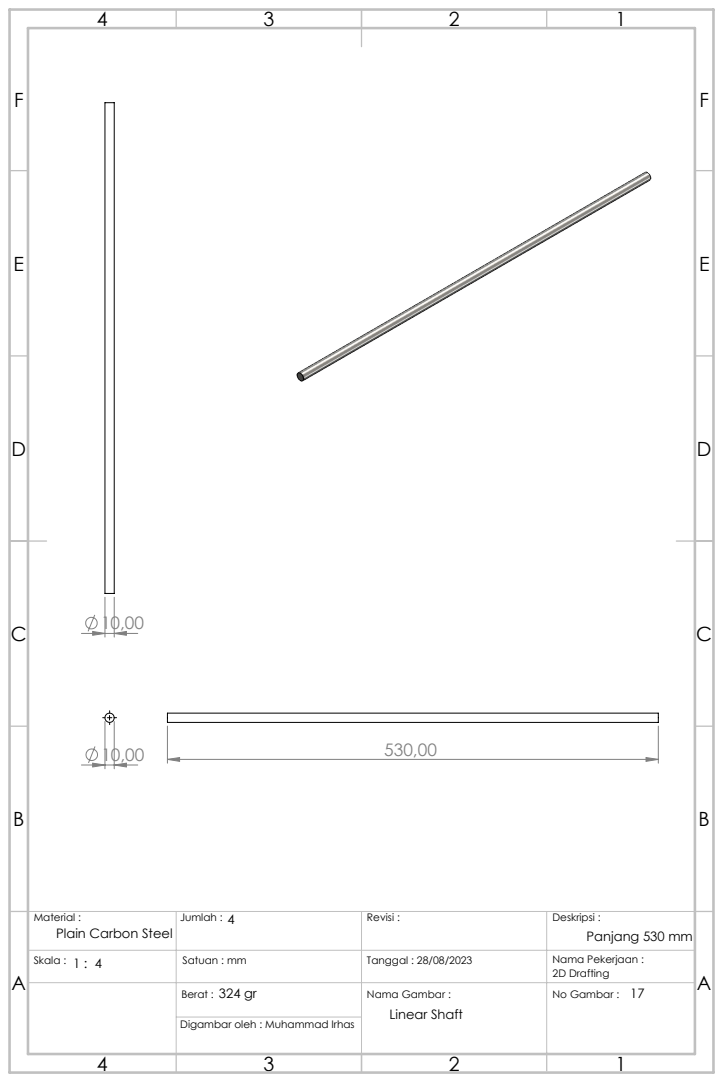
[picture p78: page 1]
Digambar oleh :; Muhammad Irhas

Material : Plain Carbon Steel | Jumlah : 4 | Revisi : | Deskripsi : Panjang 530 mm

Skala : 1 : 4 | Satuan : mm | Tanggal : 28/08/2023 | Nama Pekerjaan : 2D Drafting

324 gr Berat : | Nama Gambar : Linear Shaft | 17 No Gambar :
