BudimanZahri/mini_cnc_miling_engraver/Mechanical/Drawing 2D design mechanical/Gambar Kerja (2D)/18.Lock Shaft 2D.PDF

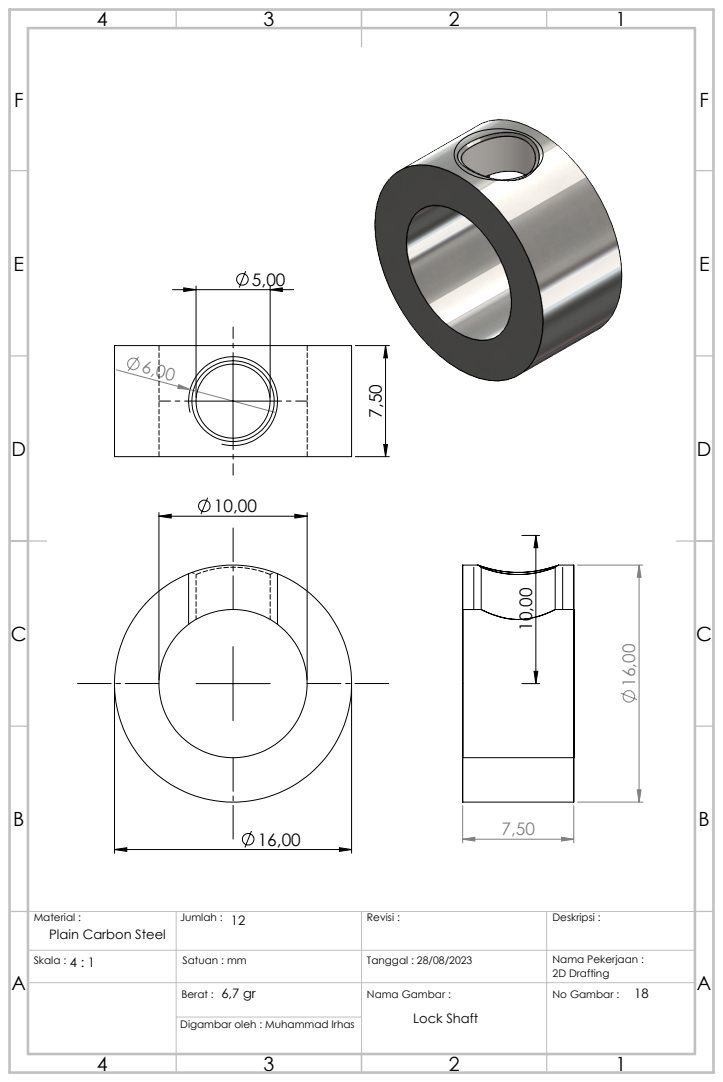
[picture p79: page 1]
Digambar oleh :; Muhammad Irhas

Material : Plain Carbon Steel | Jumlah : 12 | Revisi : | Deskripsi :

Skala : 4 : 1 | Satuan : mm | Tanggal : 28/08/2023 | Nama Pekerjaan : 2D Drafting

6,7 gr Berat : | Nama Gambar : Lock Shaft | No Gambar :
