BudimanZahri/mini_cnc_miling_engraver/Mechanical/Drawing 2D design mechanical/Gambar Kerja (2D)/19.Nut Lead Screw T8 2D.PDF

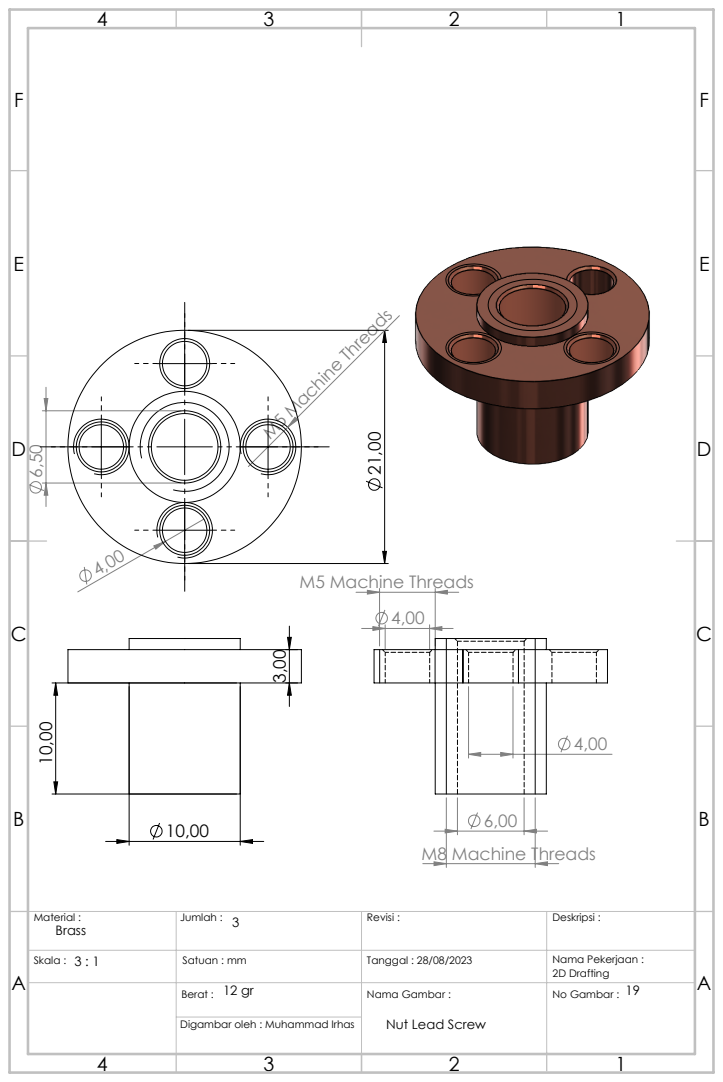
[picture p80: page 1]
M8 Machine Threads; M5 Machine Threads; Digambar oleh :; Muhammad Irhas

Material : Brass | Jumlah : 3 | Revisi : | Deskripsi :

Skala : 3 : 1 | Satuan : mm | Tanggal : 28/08/2023 | Nama Pekerjaan : 2D Drafting

Berat : | Nama Gambar : Nut Lead Screw | 19 No Gambar :
