BudimanZahri/mini_cnc_miling_engraver/Mechanical/Drawing 2D design mechanical/Gambar Kerja (2D)/2.Braket siku SOLID 2D.PDF

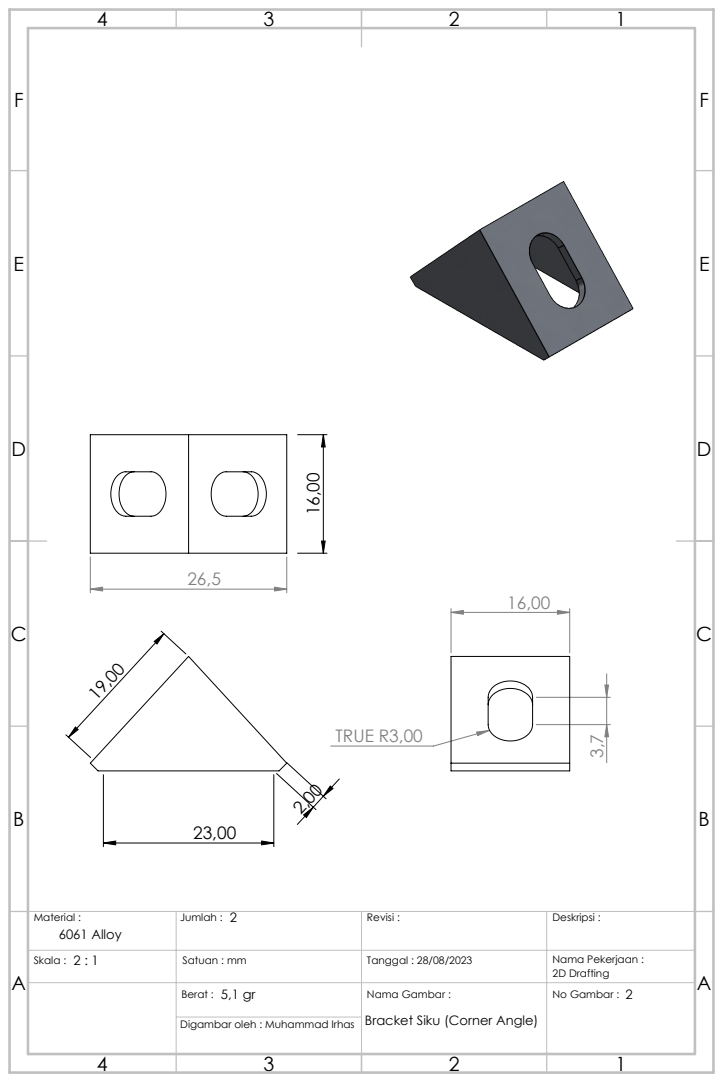
[picture p81: page 1]
TRUE R3,00; Digambar oleh :; Muhammad Irhas

Material : 6061 Alloy | Jumlah : 2 | Revisi : | Deskripsi :

Skala : 2 : 1 | Satuan : mm | Tanggal : 28/08/2023 | Nama Pekerjaan : 2D Drafting

Berat : 5,1 gr | Nama Gambar : Bracket Siku (Corner Angle) | No Gambar : 2
