BudimanZahri/mini_cnc_miling_engraver/Mechanical/Drawing 2D design mechanical/Gambar Kerja (2D)/20.Dudukan Nut Lead Screw 2D.PDF

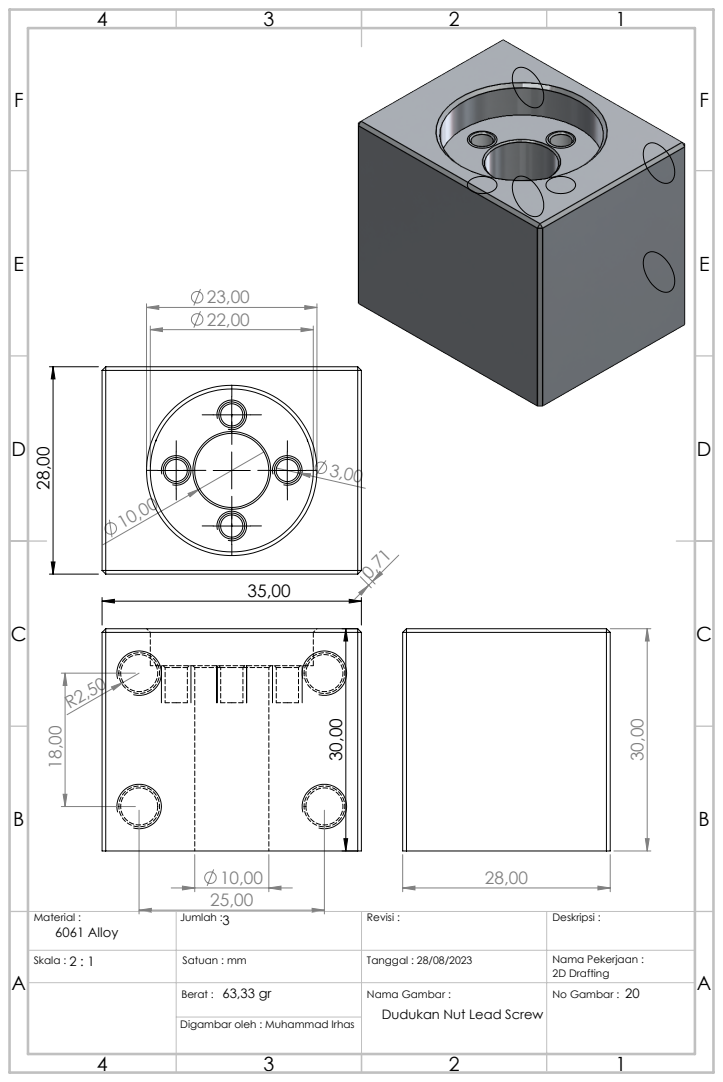
[picture p82: page 1]
Digambar oleh :; Muhammad Irhas

Material : 6061 Alloy | Jumlah : 3 | Revisi : | Deskripsi :

Skala : 2 : 1 | Satuan : mm | Tanggal : 28/08/2023 | Nama Pekerjaan : 2D Drafting

63,33 gr Berat : | Nama Gambar : Dudukan Nut Lead Screw | 20 No Gambar :
