BudimanZahri/mini_cnc_miling_engraver/Mechanical/Drawing 2D design mechanical/Gambar Kerja (2D)/21.Dudukan Nut Housing 2D.PDF

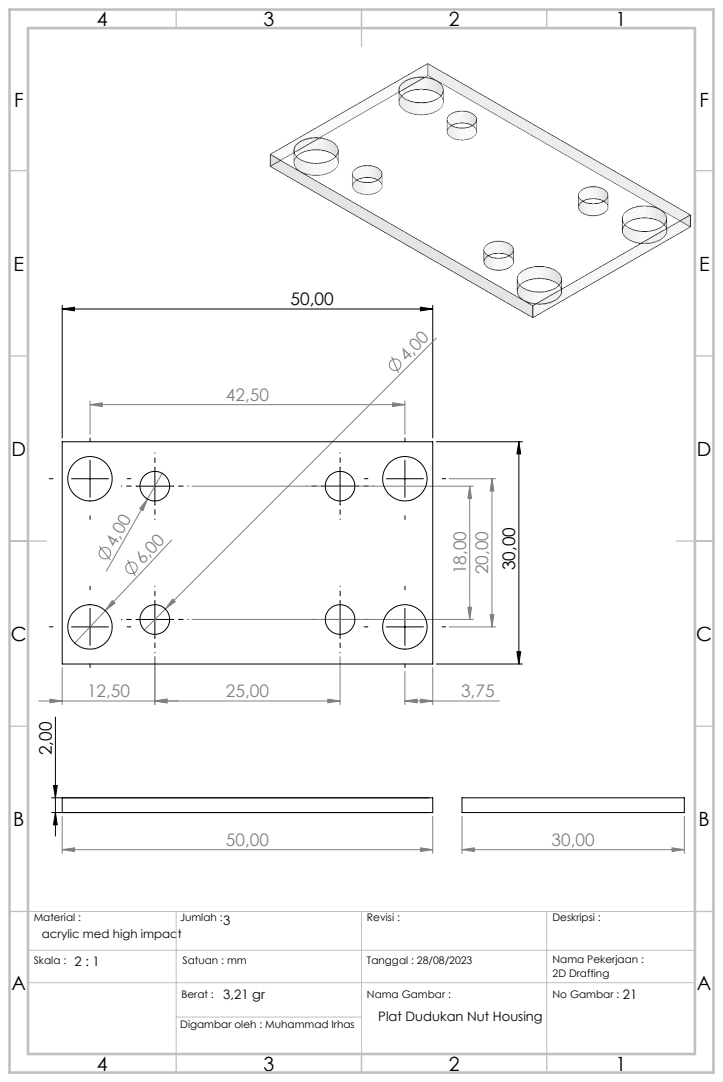
[picture p83: page 1]
Digambar oleh :; Muhammad Irhas

Material : acrylic med high impact | Jumlah : 3 | Revisi : | Deskripsi :

Skala : 2 : 1 | Satuan : mm | Tanggal : 28/08/2023 | Nama Pekerjaan : 2D Drafting

Berat : 3,21 gr | Nama Gambar : Plat Dudukan Nut Housing | No Gambar : 21
