BudimanZahri/mini_cnc_miling_engraver/Mechanical/Drawing 2D design mechanical/Gambar Kerja (2D)/22.Frame Depan 2D.PDF

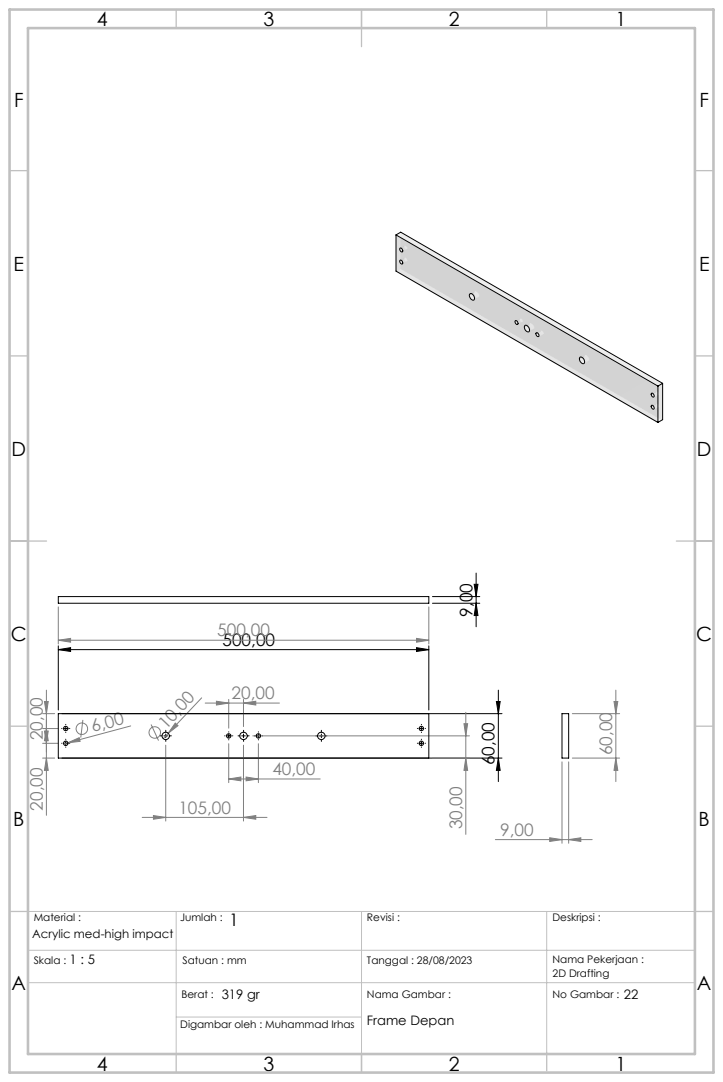
[picture p84: page 1]
Digambar oleh :; Muhammad Irhas

Material : Acrylic med-high impact | Jumlah : 1 | Revisi : | Deskripsi :

Skala : 1 : 5 | Satuan : mm | Tanggal : 28/08/2023 | Nama Pekerjaan : 2D Drafting

Berat : 319 gr | Nama Gambar : Frame Depan | No Gambar : 22
