BudimanZahri/mini_cnc_miling_engraver/Mechanical/Drawing 2D design mechanical/Gambar Kerja (2D)/23.Frame Belakang 2D.PDF

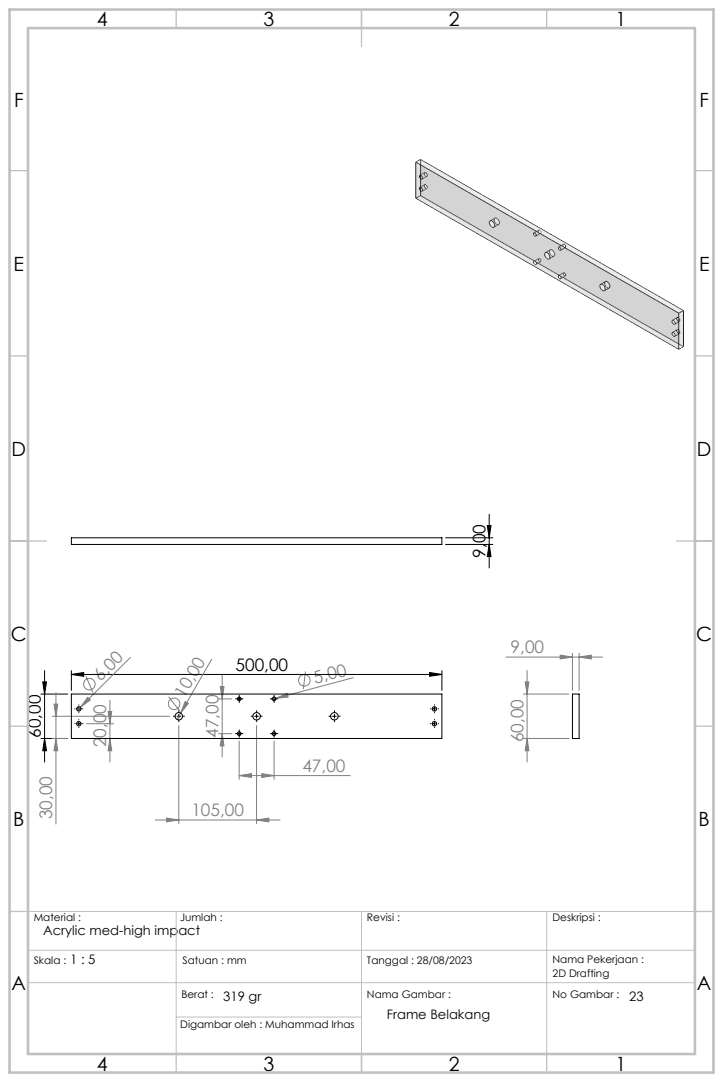
[picture p85: page 1]
Digambar oleh :; Muhammad Irhas

Material : Acrylic med-high impact | Jumlah : | Revisi : | Deskripsi :

Skala : 1 : 5 | Satuan : mm | Tanggal : 28/08/2023 | Nama Pekerjaan : 2D Drafting

Berat : 319 gr | Nama Gambar : Frame Belakang | No Gambar : 23
