BudimanZahri/mini_cnc_miling_engraver/Mechanical/Drawing 2D design mechanical/Gambar Kerja (2D)/24. Mur 2D.PDF

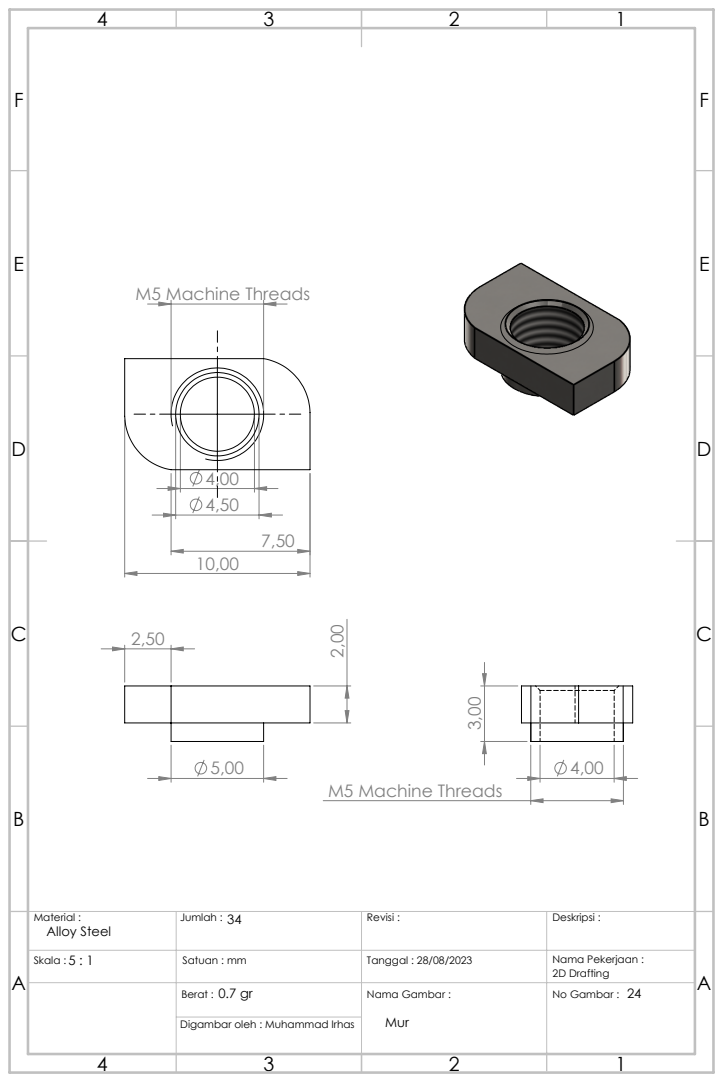
[picture p86: page 1]
M5 Machine Threads; M5 Machine Threads 3,00; Digambar oleh :; Muhammad Irhas

Material : Alloy Steel | Jumlah : 34 | Revisi : | Deskripsi :

Skala : 5 : 1 | Satuan : mm | Tanggal : 28/08/2023 | Nama Pekerjaan : 2D Drafting

0.7 gr Berat : | Nama Gambar : Mur | No Gambar :
