BudimanZahri/mini_cnc_miling_engraver/Mechanical/Drawing 2D design mechanical/Gambar Kerja (2D)/25.Meja Kerja 2D.PDF

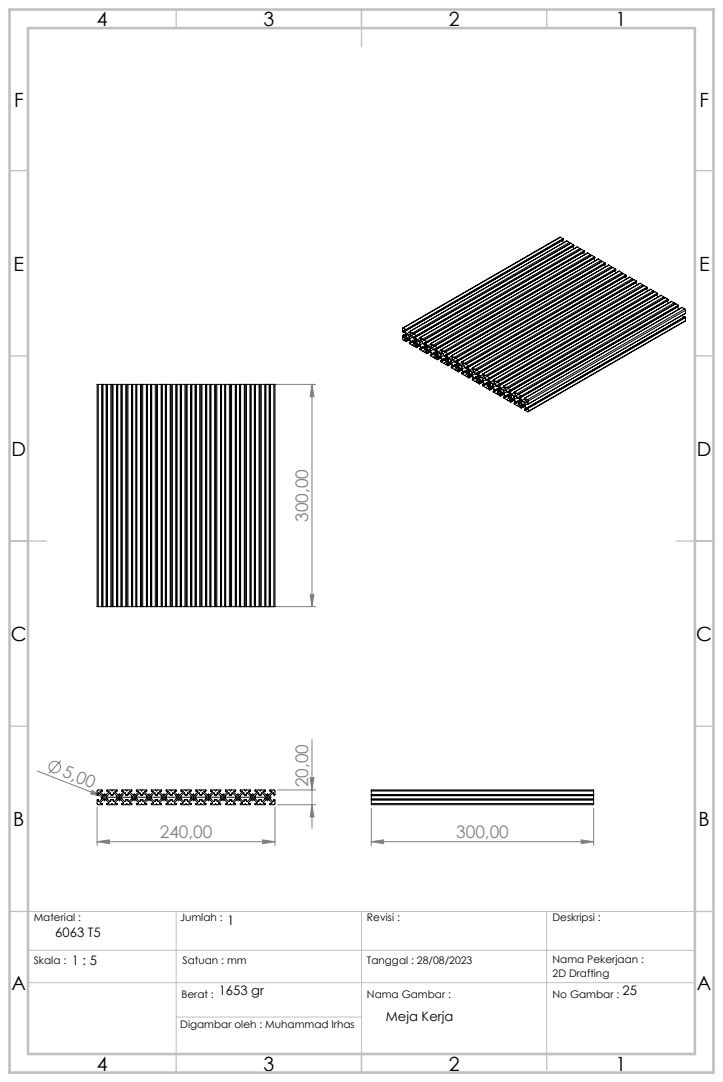
[picture p87: page 1]
Digambar oleh :; Muhammad Irhas

Material : 6063 T5 | Jumlah : 1 | Revisi : | Deskripsi :

Skala : 1 : 5 | Satuan : mm | Tanggal : 28/08/2023 | Nama Pekerjaan : 2D Drafting

1653 gr Berat : | Nama Gambar : Meja Kerja | No Gambar :
