BudimanZahri/mini_cnc_miling_engraver/Mechanical/Drawing 2D design mechanical/Gambar Kerja (2D)/26.Penyambung Meja Kerja 2D.PDF

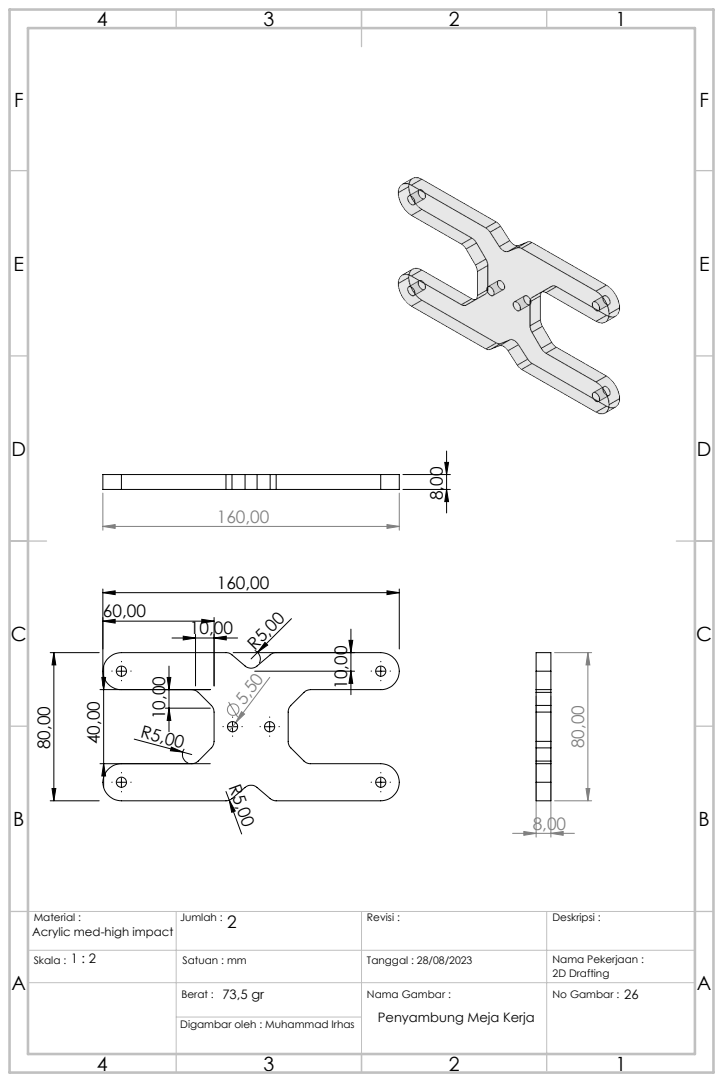
[picture p88: page 1]
Digambar oleh :; Muhammad Irhas

Material : Acrylic med-high impact | Jumlah : 2 | Revisi : | Deskripsi :

1 : 2 Skala : | Satuan : mm | Tanggal : 28/08/2023 | Nama Pekerjaan : 2D Drafting

Berat : 73,5 gr | Nama Gambar : Penyambung Meja Kerja | No Gambar : 26
