BudimanZahri/mini_cnc_miling_engraver/Mechanical/Drawing 2D design mechanical/Gambar Kerja (2D)/27.V slot gantry rod plate 625ZZ 2D.PDF

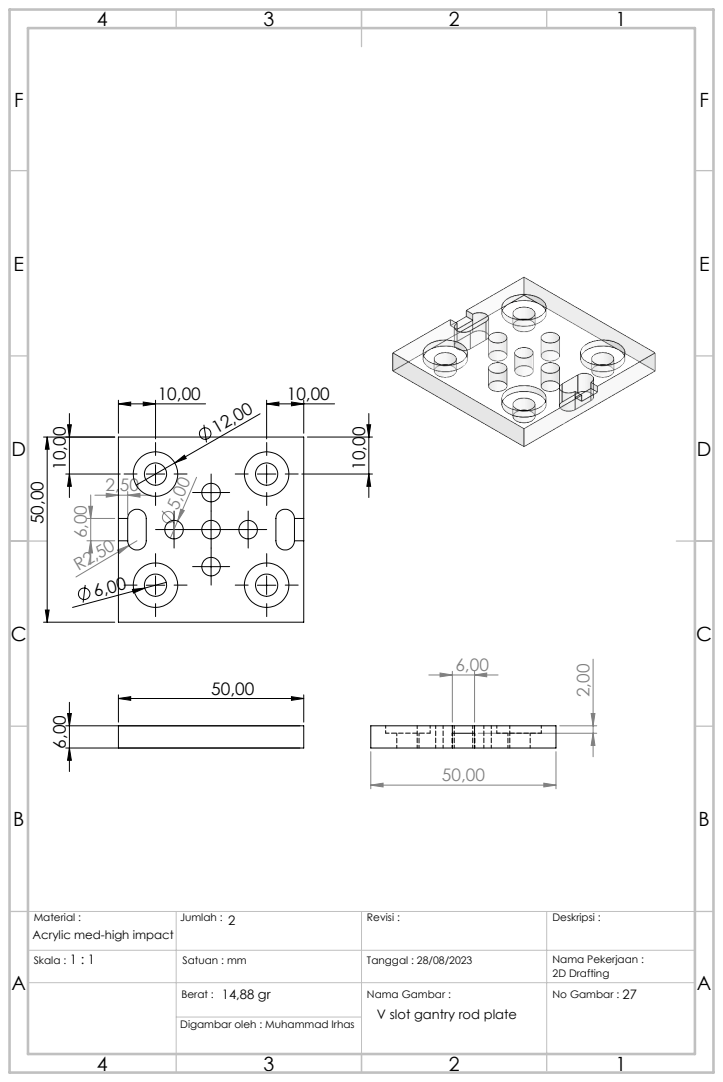
[picture p89: page 1]
Digambar oleh :; Muhammad Irhas

Material : Acrylic med-high impact | Jumlah : 2 | Revisi : | Deskripsi :

Skala : 1 : 1 | Satuan : mm | Tanggal : 28/08/2023 | Nama Pekerjaan : 2D Drafting

Berat : | Nama Gambar : V slot gantry rod plate | No Gambar : 27
