BudimanZahri/mini_cnc_miling_engraver/Mechanical/Drawing 2D design mechanical/Gambar Kerja (2D)/28.Baut L 5,5mm 2D.PDF

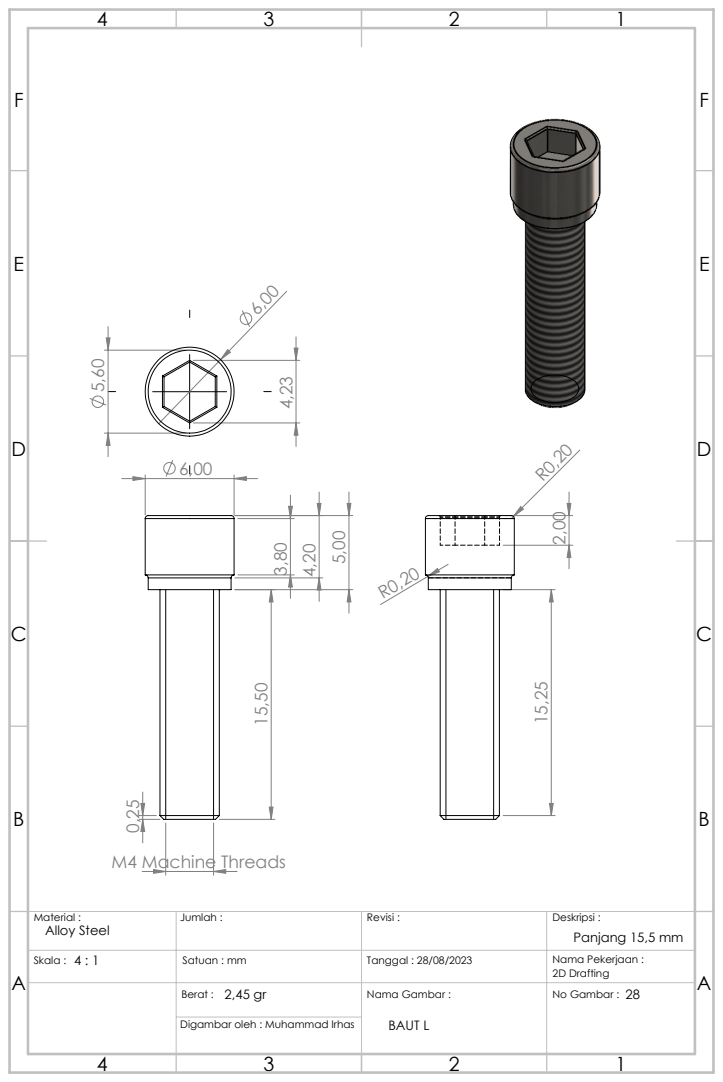
[picture p90: page 1]
M4 Machine Threads; Digambar oleh :; Muhammad Irhas

Material : Alloy Steel | Jumlah : | Revisi : | Deskripsi : Panjang 15,5 mm

Skala : 4 : 1 | Satuan : mm | Tanggal : 28/08/2023 | Nama Pekerjaan : 2D Drafting

Berat : 2,45 gr | Nama Gambar : BAUT L | No Gambar :
