BudimanZahri/mini_cnc_miling_engraver/Mechanical/Drawing 2D design mechanical/Gambar Kerja (2D)/29.Baut L 14,5 mm 2D.PDF

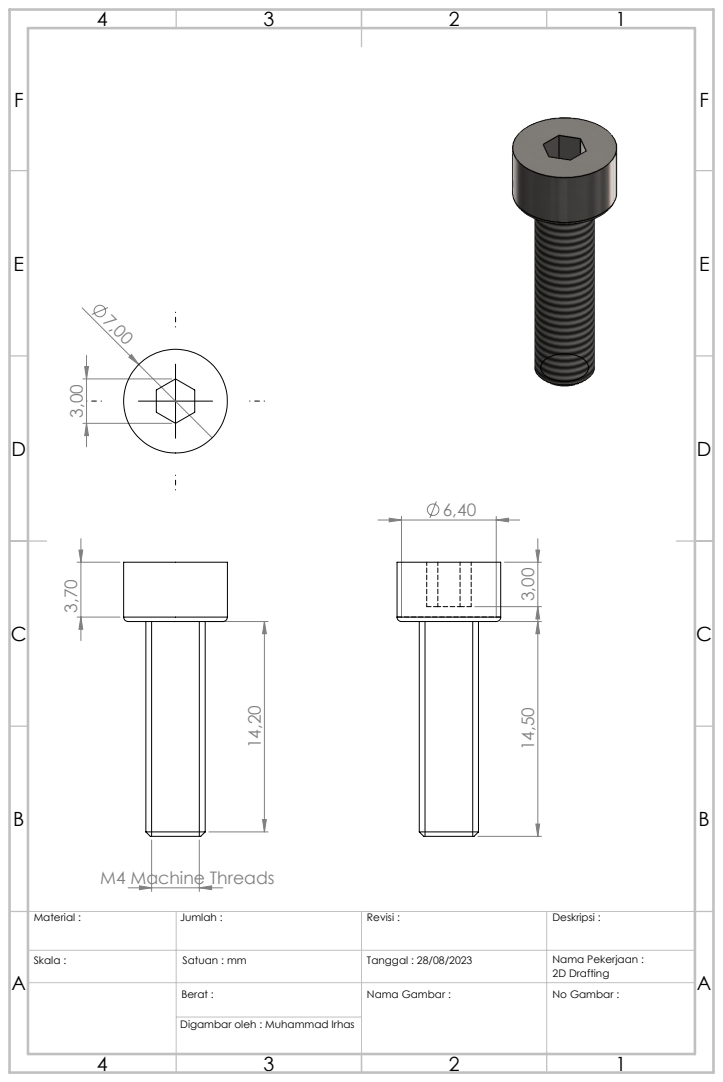
[picture p91: page 1]
M4 Machine Threads 14,20; Digambar oleh :; Muhammad Irhas

Material : | Jumlah : | Revisi : | Deskripsi :

Skala : | Satuan : mm | Tanggal : 28/08/2023 | Nama Pekerjaan : 2D Drafting

Berat : | Nama Gambar : | No Gambar :
