BudimanZahri/mini_cnc_miling_engraver/Mechanical/Drawing 2D design mechanical/Gambar Kerja (2D)/3.Plat Akrilik bagian bawah 2D.PDF

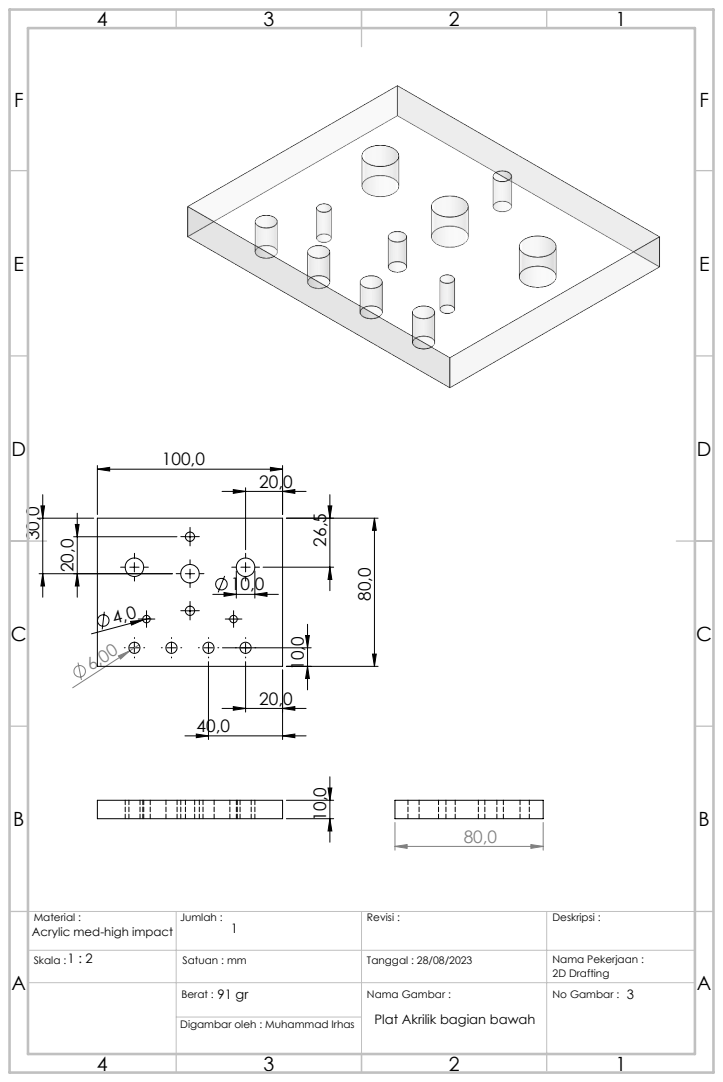
[picture p92: page 1]
Digambar oleh :; Muhammad Irhas

Material : Acrylic med-high impact | Jumlah : 1 | Revisi : | Deskripsi :

Skala : 1 : 2 | Satuan : mm | Tanggal : 28/08/2023 | Nama Pekerjaan : 2D Drafting

Berat : 91 gr | Nama Gambar : Plat Akrilik bagian bawah | No Gambar : 3
