BudimanZahri/mini_cnc_miling_engraver/Mechanical/Drawing 2D design mechanical/Gambar Kerja (2D)/30.BAUT L 32,5 mm 2D.pdf

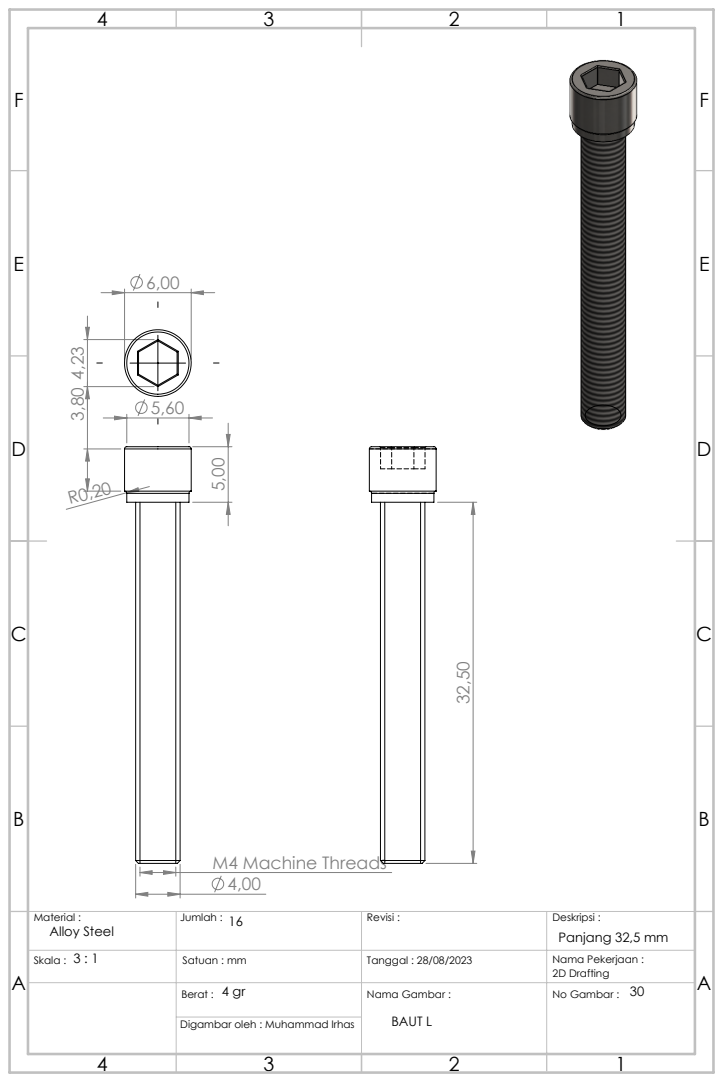
[picture p93: page 1]
M4 Machine Threads; Digambar oleh :; Muhammad Irhas

Material : Alloy Steel | Jumlah : 16 | Revisi : | Deskripsi : Panjang 32,5 mm

3 : 1 Skala : | Satuan : mm | Tanggal : 28/08/2023 | Nama Pekerjaan : 2D Drafting

4 gr Berat : | Nama Gambar : BAUT L | 30 No Gambar :
