BudimanZahri/mini_cnc_miling_engraver/Mechanical/Drawing 2D design mechanical/Gambar Kerja (2D)/31. Assembly Spindel Part 2D.PDF

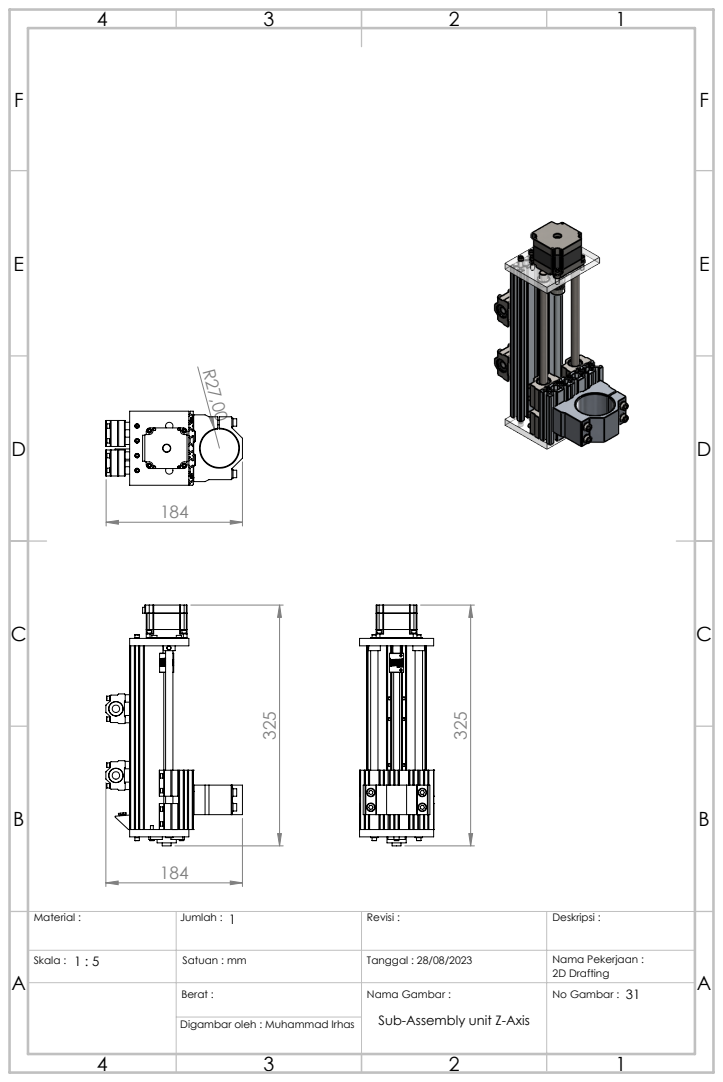
[picture p94: page 1]
Digambar oleh :; Muhammad Irhas

Material : | Jumlah : 1 | Revisi : | Deskripsi :

Skala : 1 : 5 | Satuan : mm | Tanggal : 28/08/2023 | Nama Pekerjaan : 2D Drafting

Berat : | Nama Gambar : Sub-Assembly unit Z-Axis | No Gambar : 31
