BudimanZahri/mini_cnc_miling_engraver/Mechanical/Drawing 2D design mechanical/Gambar Kerja (2D)/32.Sub-Assembly Unit X-Axis 2D.PDF

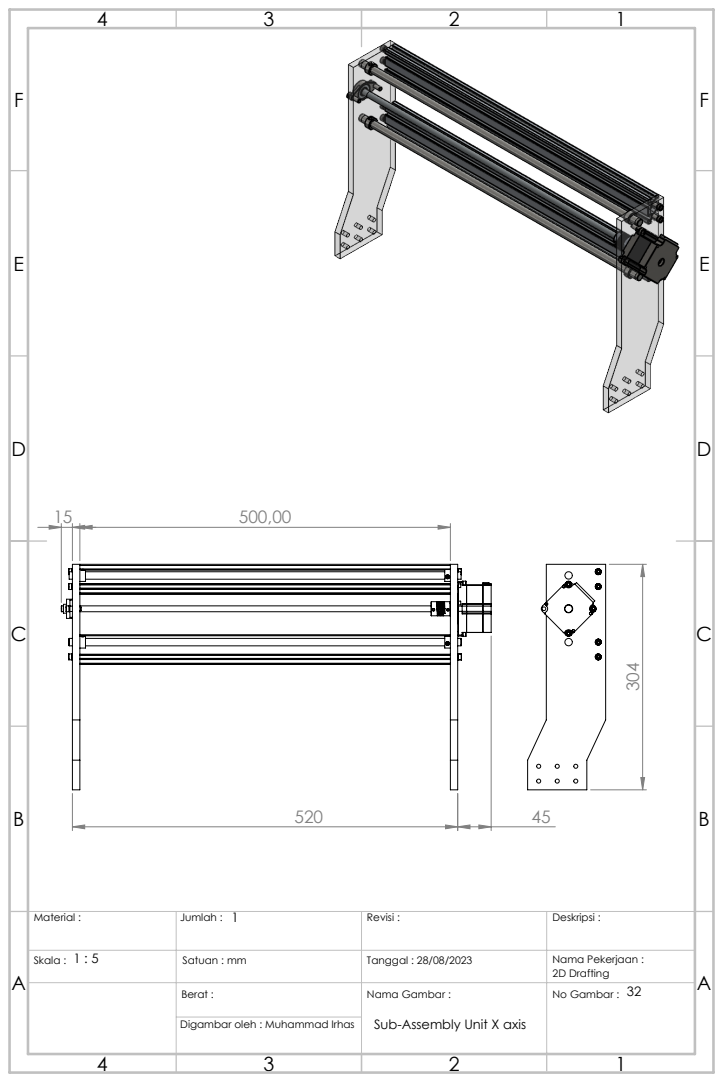
[picture p95: page 1]
Digambar oleh :; Muhammad Irhas

Material : | Jumlah : 1 | Revisi : | Deskripsi :

1 : 5 Skala : | Satuan : mm | Tanggal : 28/08/2023 | Nama Pekerjaan : 2D Drafting

Berat : | Nama Gambar : Sub-Assembly Unit X axis | No Gambar :
