BudimanZahri/mini_cnc_miling_engraver/Mechanical/Drawing 2D design mechanical/Gambar Kerja (2D)/33. Sub-Assembly Unit Y-Axis 2D.PDF

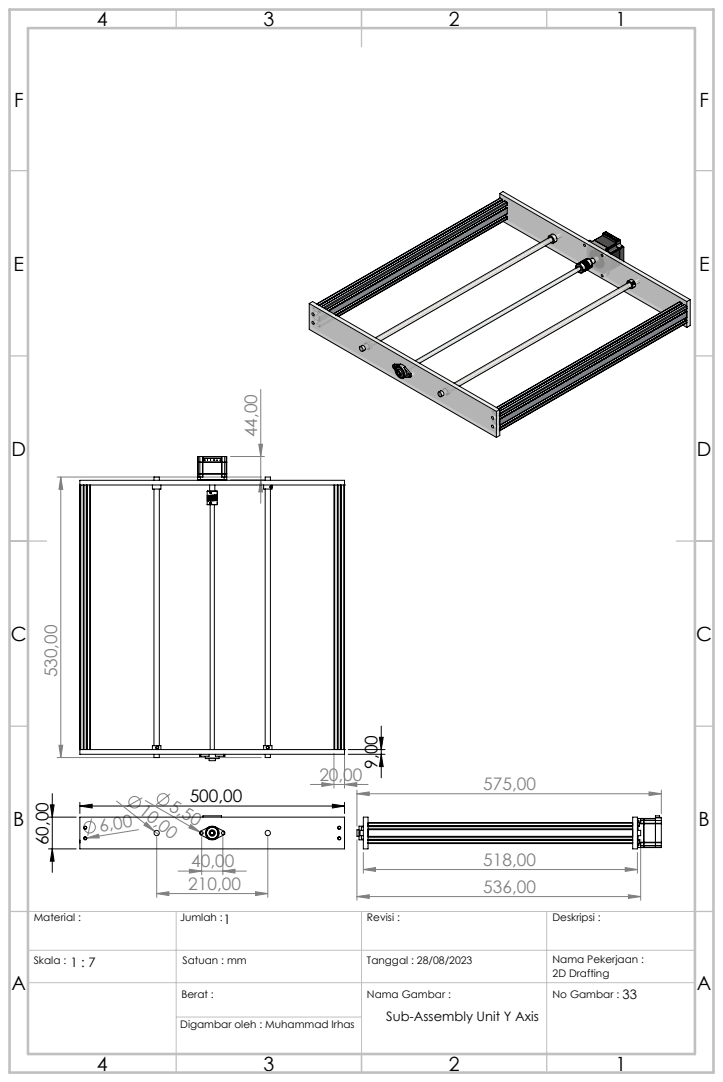
[picture p96: page 1]
Digambar oleh :; Muhammad Irhas

Material : | Jumlah : 1 | Revisi : | Deskripsi :

Skala : 1 : 7 | Satuan : mm | Tanggal : 28/08/2023 | Nama Pekerjaan : 2D Drafting

Berat : | Nama Gambar : Sub-Assembly Unit Y Axis | No Gambar :
