BudimanZahri/mini_cnc_miling_engraver/Mechanical/Drawing 2D design mechanical/Gambar Kerja (2D)/36.Assembly Total 2D.PDF

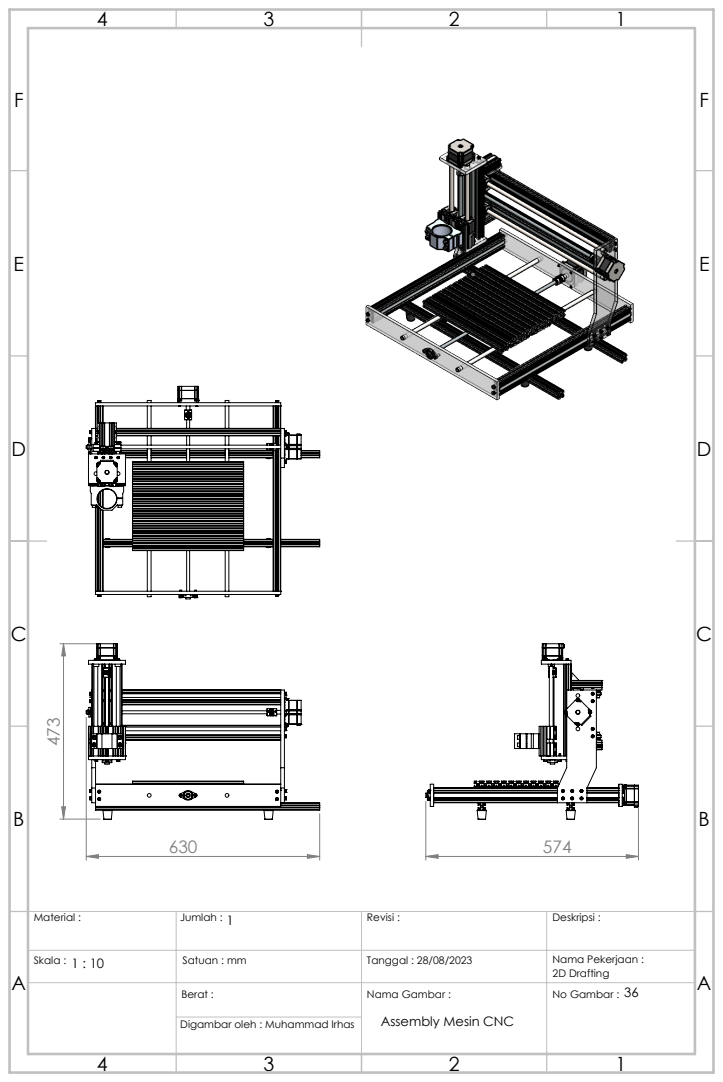
[picture p98: page 1]
Digambar oleh :; Muhammad Irhas

Material : | Jumlah : 1 | Revisi : | Deskripsi :

Skala : 1 : 10 | Satuan : mm | Tanggal : 28/08/2023 | Nama Pekerjaan : 2D Drafting

Berat : | Nama Gambar : Assembly Mesin CNC | No Gambar :
