BudimanZahri/mini_cnc_miling_engraver/Mechanical/Drawing 2D design mechanical/Gambar Kerja (2D)/4.Linear Bearing Block SCS10UU 2D.PDF

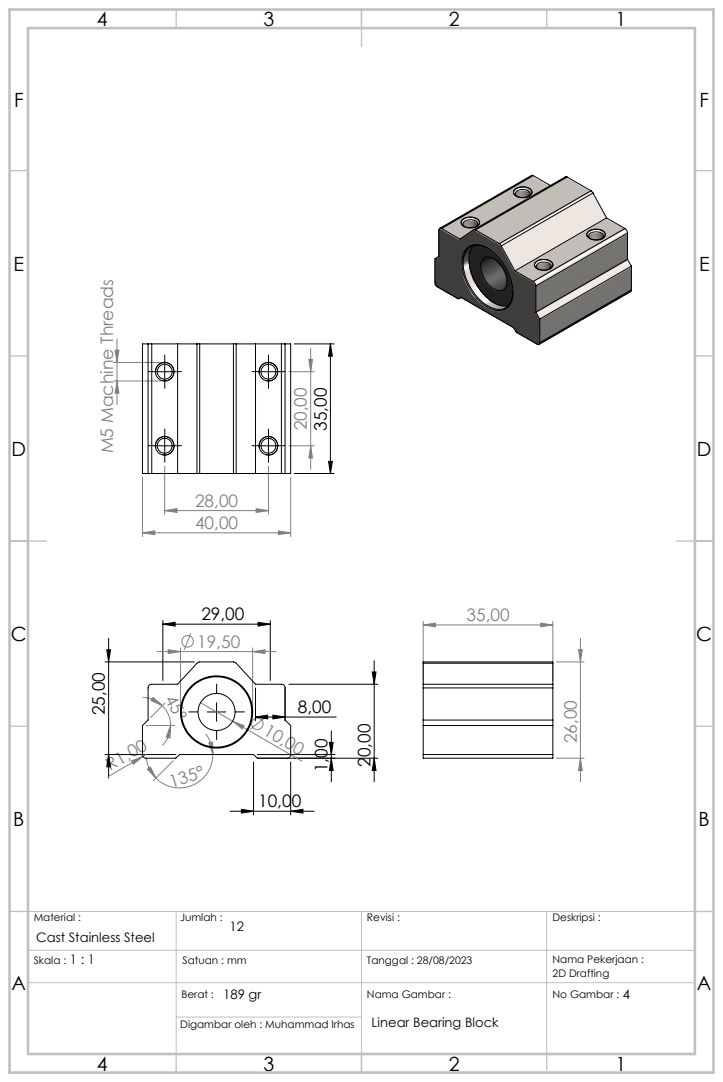
[picture p99: page 1]
M5 Machine Threads; Digambar oleh :; Muhammad Irhas

Material : Cast Stainless Steel | Jumlah : 12 | Revisi : | Deskripsi :

Skala : 1 : 1 | Satuan : mm | Tanggal : 28/08/2023 | Nama Pekerjaan : 2D Drafting

Berat : 189 gr | Nama Gambar : Linear Bearing Block | No Gambar :
