BudimanZahri/mini_cnc_miling_engraver/Mechanical/Drawing 2D design mechanical/Gambar Kerja (2D)/5.lead Screw T8 D2 lead 8 250mm 2D.PDF

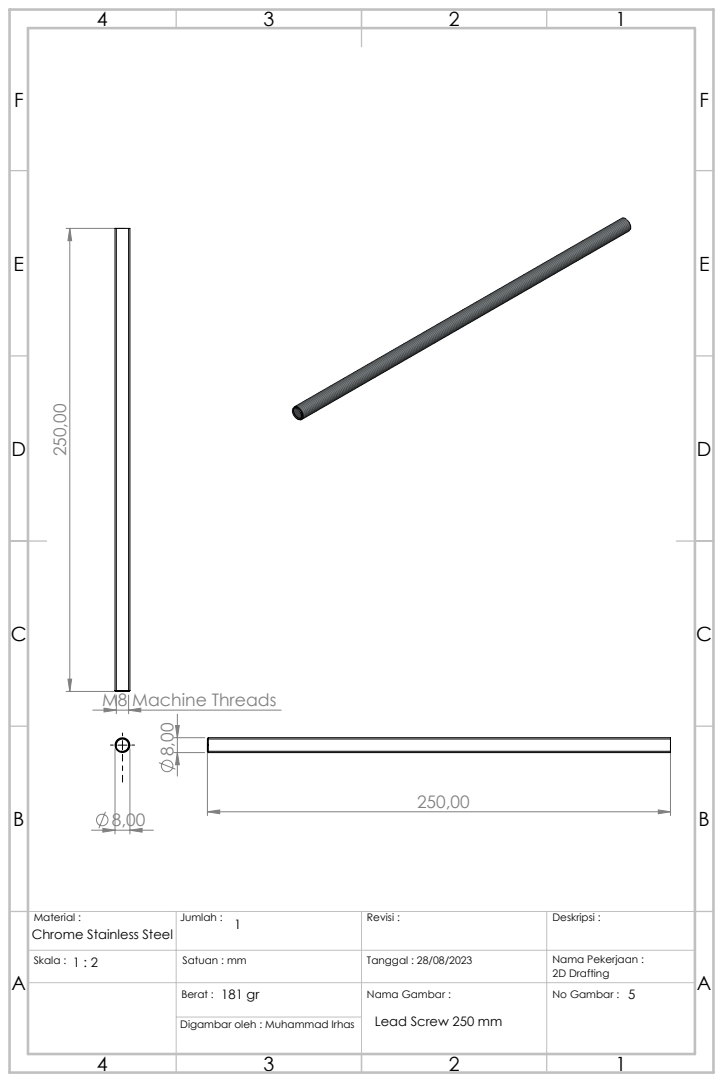
[picture p100: page 1]
M8 Machine Threads; Digambar oleh :; Muhammad Irhas

Material : Chrome Stainless Steel | Jumlah : 1 | Revisi : | Deskripsi :

Skala : 1 : 2 | Satuan : mm | Tanggal : 28/08/2023 | Nama Pekerjaan : 2D Drafting

Berat : 181 gr | Nama Gambar : Lead Screw 250 mm | No Gambar : 5
