BudimanZahri/mini_cnc_miling_engraver/Mechanical/Drawing 2D design mechanical/Gambar Kerja (2D)/6.Linear Shaft 2D.PDF

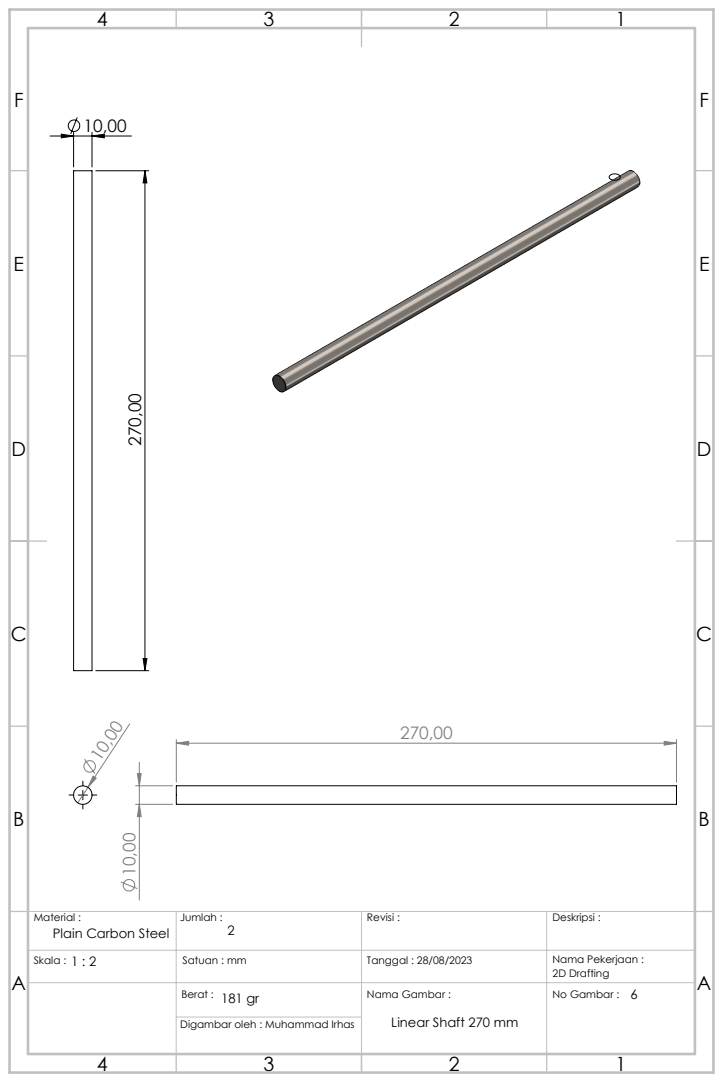
[picture p101: page 1]
Digambar oleh :; Muhammad Irhas

Material : Plain Carbon Steel | Jumlah : 2 | Revisi : | Deskripsi :

Skala : 1 : 2 | Satuan : mm | Tanggal : 28/08/2023 | Nama Pekerjaan : 2D Drafting

Berat : 181 gr | Nama Gambar : Linear Shaft 270 mm | No Gambar : 6
