BudimanZahri/mini_cnc_miling_engraver/Mechanical/Drawing 2D design mechanical/Gambar Kerja (2D)/7.motor stepper 2D.PDF

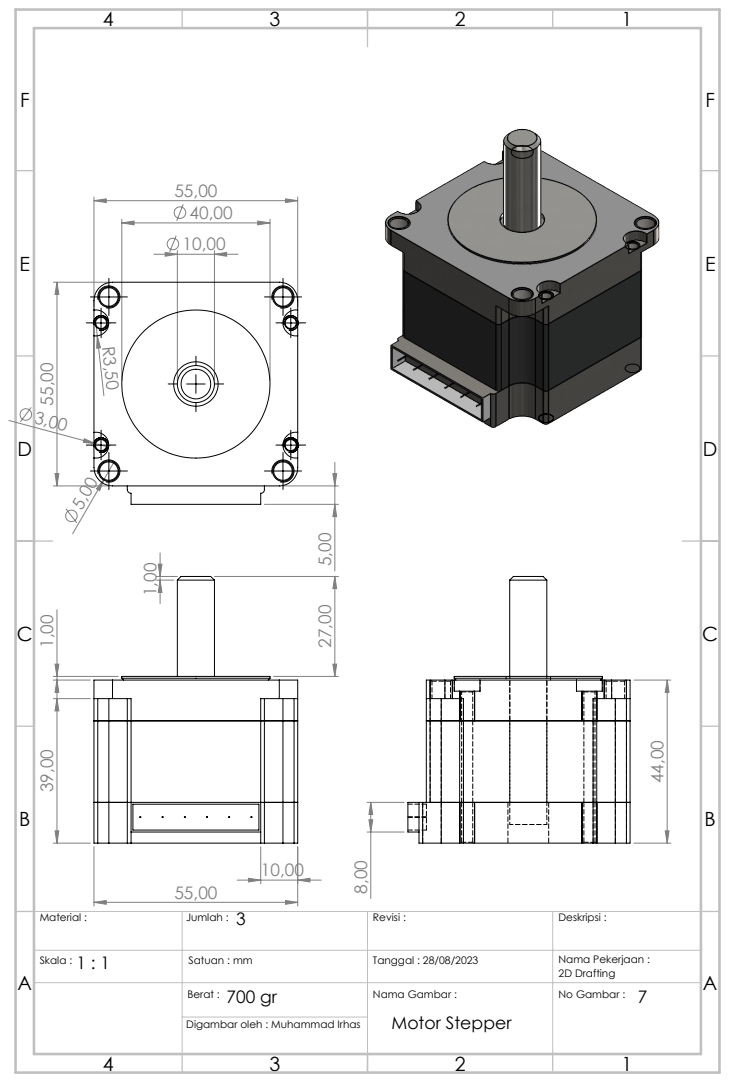
[picture p102: page 1]
Digambar oleh :; Muhammad Irhas

Material : | Jumlah : 3 | Revisi : | Deskripsi :
Skala : 1 : 1 | Satuan : mm | Tanggal : 28/08/2023 | Nama Pekerjaan : 2D Drafting

Berat : 700 gr | Nama Gambar : Motor Stepper | No Gambar : 7
