BudimanZahri/mini_cnc_miling_engraver/Mechanical/Drawing 2D design mechanical/Gambar Kerja (2D)/9.Flexible Coupler RS D19L25 8x8 2D.PDF

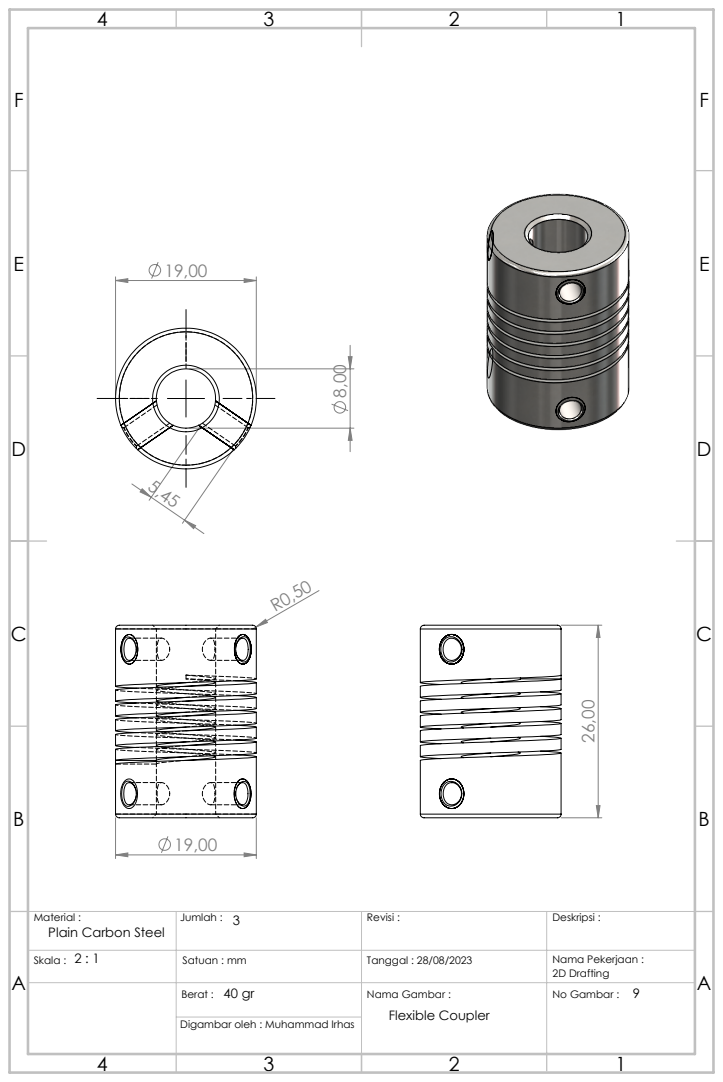
[picture p104: page 1]
Digambar oleh :; Muhammad Irhas

Material : Plain Carbon Steel | Jumlah : 3 | Revisi : | Deskripsi :

Skala : 2 : 1 | Satuan : mm | Tanggal : 28/08/2023 | Nama Pekerjaan : 2D Drafting

40 gr Berat : | Nama Gambar : Flexible Coupler | 9 No Gambar :
