BudimanZahri/mini_cnc_miling_engraver/Mechanical/3D Design/PBLMK-041-A SHEET 3-4.pdf

A ( .6 )

B ( .6 )

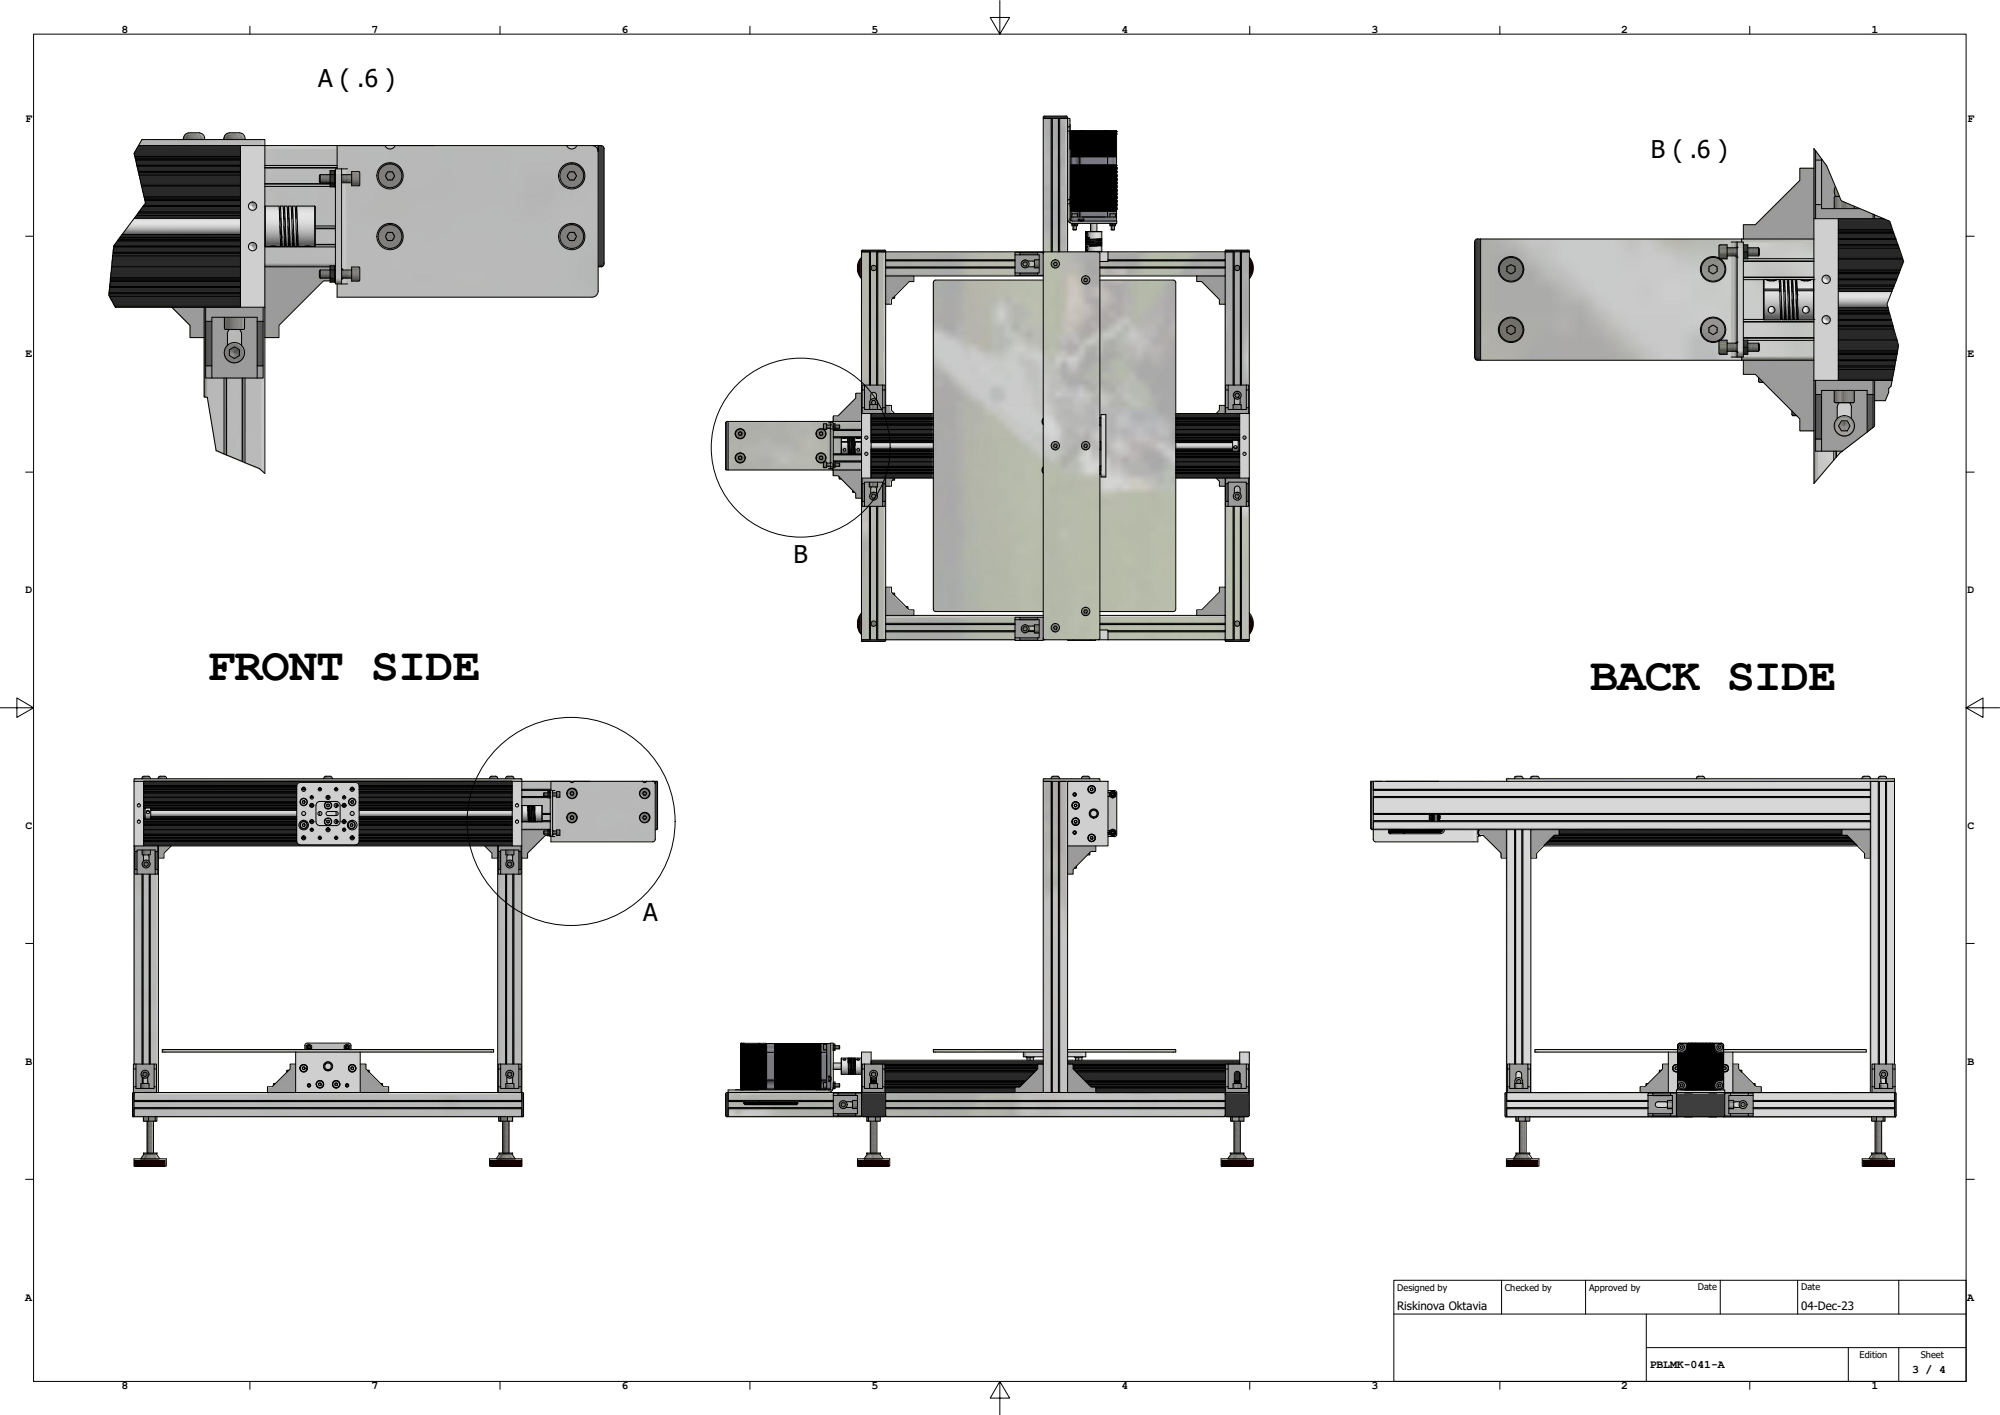
[picture p105: page 1]
PBLMK-041-A; Riskinova Oktavia; 04-Dec-23; Designed by; Checked by; Approved by; Date; Edition; Sheet; FRONT SIDE; BACK SIDE

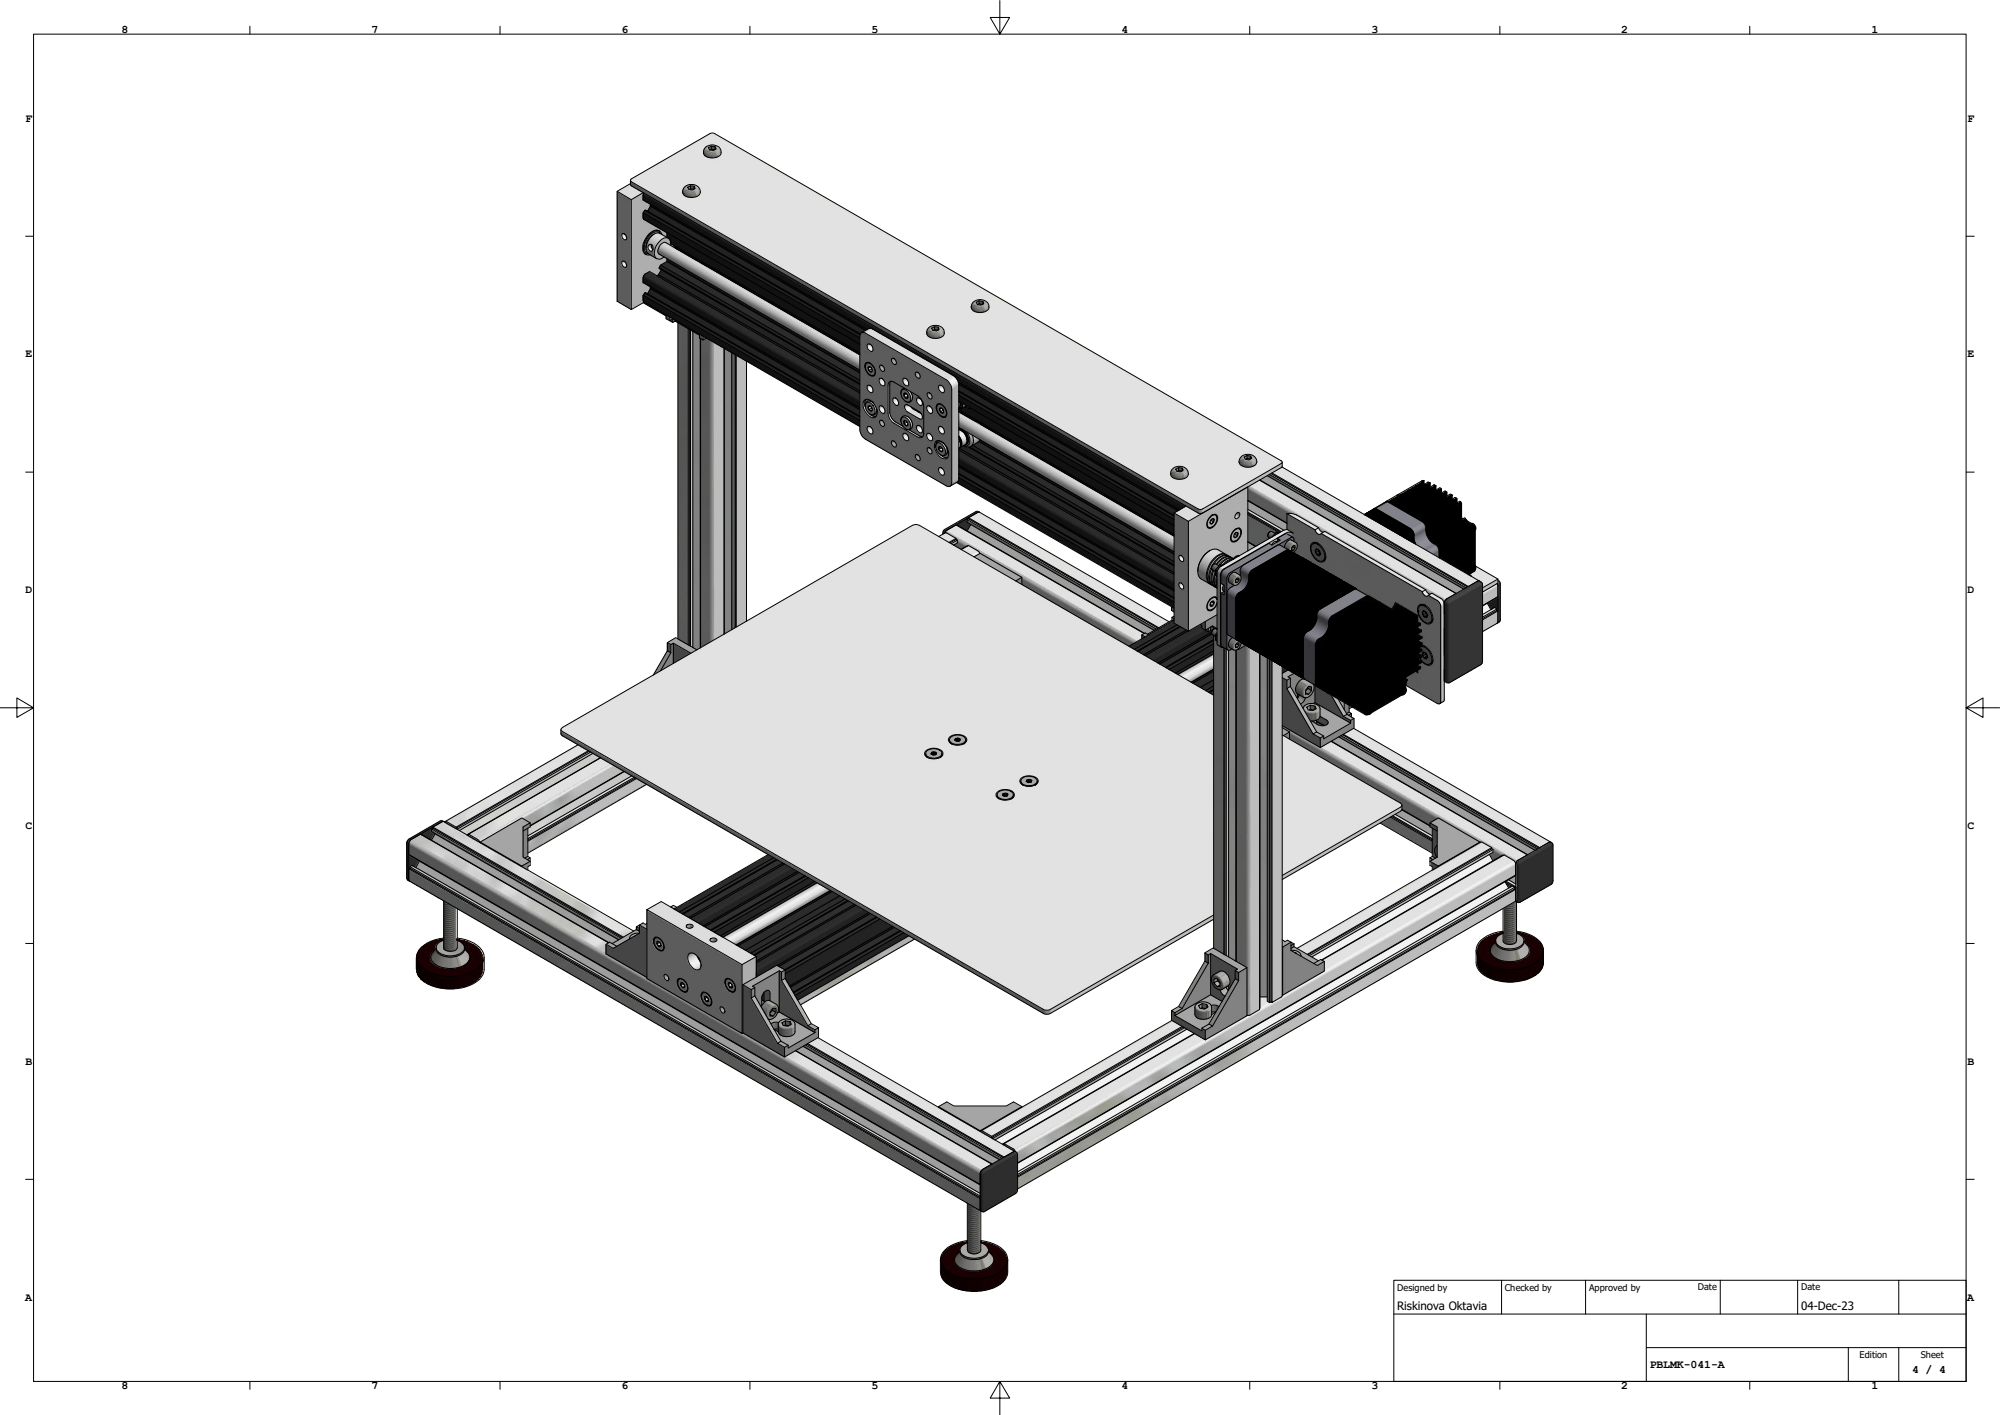
[picture p106: page 2]
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
