BudimanZahri/mini_cnc_miling_engraver/Mechanical/3D Design/PBLMK-041-A1.pdf

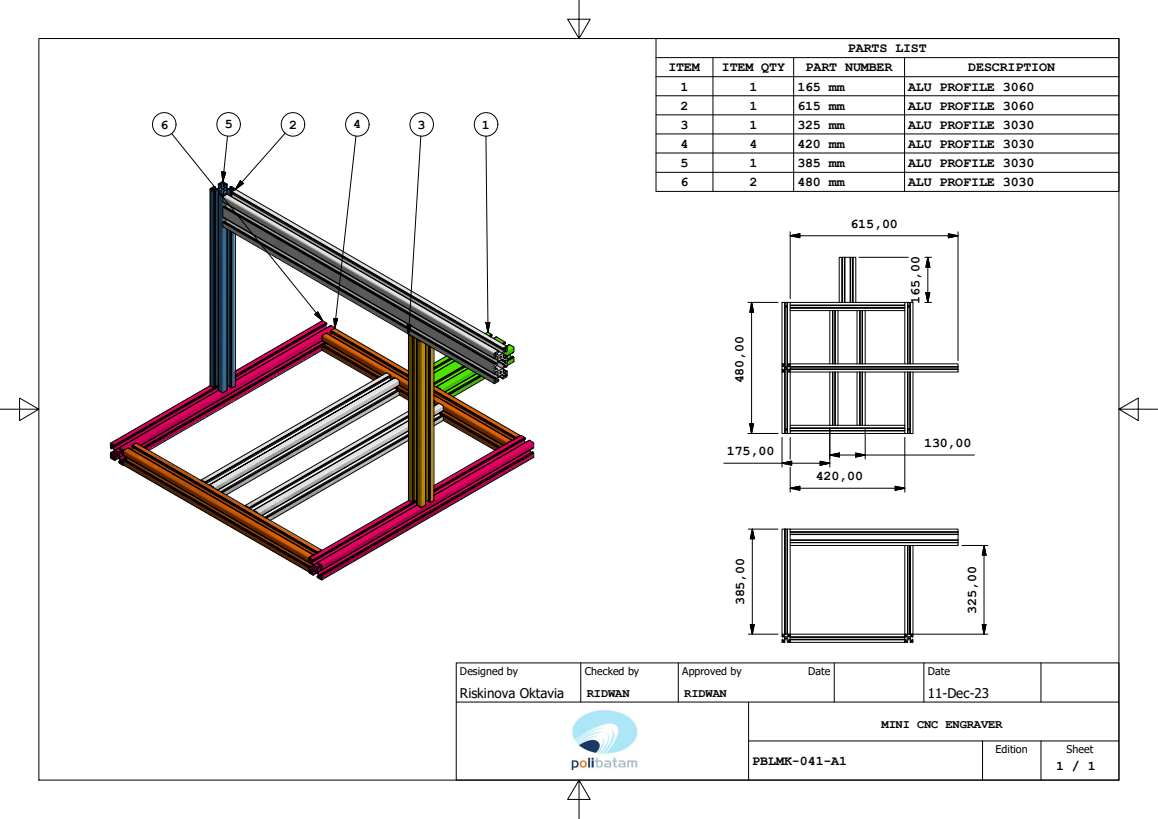
[picture p107: page 1]
PARTS LIST; ITEM; ITEM QTY; PART NUMBER; DESCRIPTION; ALU PROFILE 3060; ALU PROFILE 3030; PBLMK-041-A1; Riskinova Oktavia; 11-Dec-23; Designed by; Checked by; Approved by; Date; Edition; Sheet; RIDWAN

MINI CNC ENGRAVER
