BudimanZahri/mini_cnc_miling_engraver/(list of files, drawings)

Other design files:
Electrical/Diagram Wiring and Schematic Wiring.fzz
