BudimanZahri/mini_cnc_miling_engraver/(commit log)

2024-06-28 Add arrow controls for X and Y in interface, and add Z-axis support in Arduino program for CNC
2024-06-30 Adding wiring schematic fritzing
    [Diagram Wiring and Schematic Wiring.fzz]
2024-07-01 Adding Schematic Wiring
2024-07-05 Adding mechanical design and update new code for arrow Z axis program
    [ALU PROFILE 3030 00000001.0009.ipt, ALU PROFILE 3030 00000001.SLDPRT, ALU PROFILE 3030 00000001.ipt, ALU PROFILE 3030 00000002.0009.ipt, ALU PROFILE 3030 00000002.SLDPRT, ALU PROFILE 3030 00000002.ipt, ALU PROFILE 3030 00000003.0006.ipt, ALU PROFILE 3030 00000003.SLDPRT]
2024-07-06 Adding design per part
    [16.lead Screw T8 D2 lead 8 SOLID.SLDDRW, 17.Linear Shaft SOLID.SLDDRW, 18.Lock Shaft.SLDDRW, 19.Nut Lead Screw T8 SOLID.SLDDRW, 20.Dudukan Nut Lead Screw SOLID.SLDDRW, 21.Dudukan Nut Housing SOLID.SLDDRW, 22.Frame Depan SOLID.SLDDRW, 23.Frame Belakang SOLID.SLDDRW]
2024-07-14 adding gantt chart and ppt slide
    [PBLMK232-54_Gant Chart.xlsx]
